mehdinuri/CPU4v1/README.md

# CPU4v1
Maestro Intersection Controlling System

# How to Use VSCode with STM32 Microcontrollers
[VSCode STM32](https://community.st.com/t5/stm32-mcus/how-to-use-vs-code-with-stm32-microcontrollers/ta-p/742589)

# Setup for STM32 development on Windows with WSL2
[WSL2 ST](https://github.com/robinhellmers/developer_setup_stm32_wsl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)
