mehdinuri/CPU4v1/PSM/Docs/sema_C2506-P250606_PSM_V1.pdf

GRID VOLTAGE & FREQUENCY MEASUREMENT | BP CONNECTOR

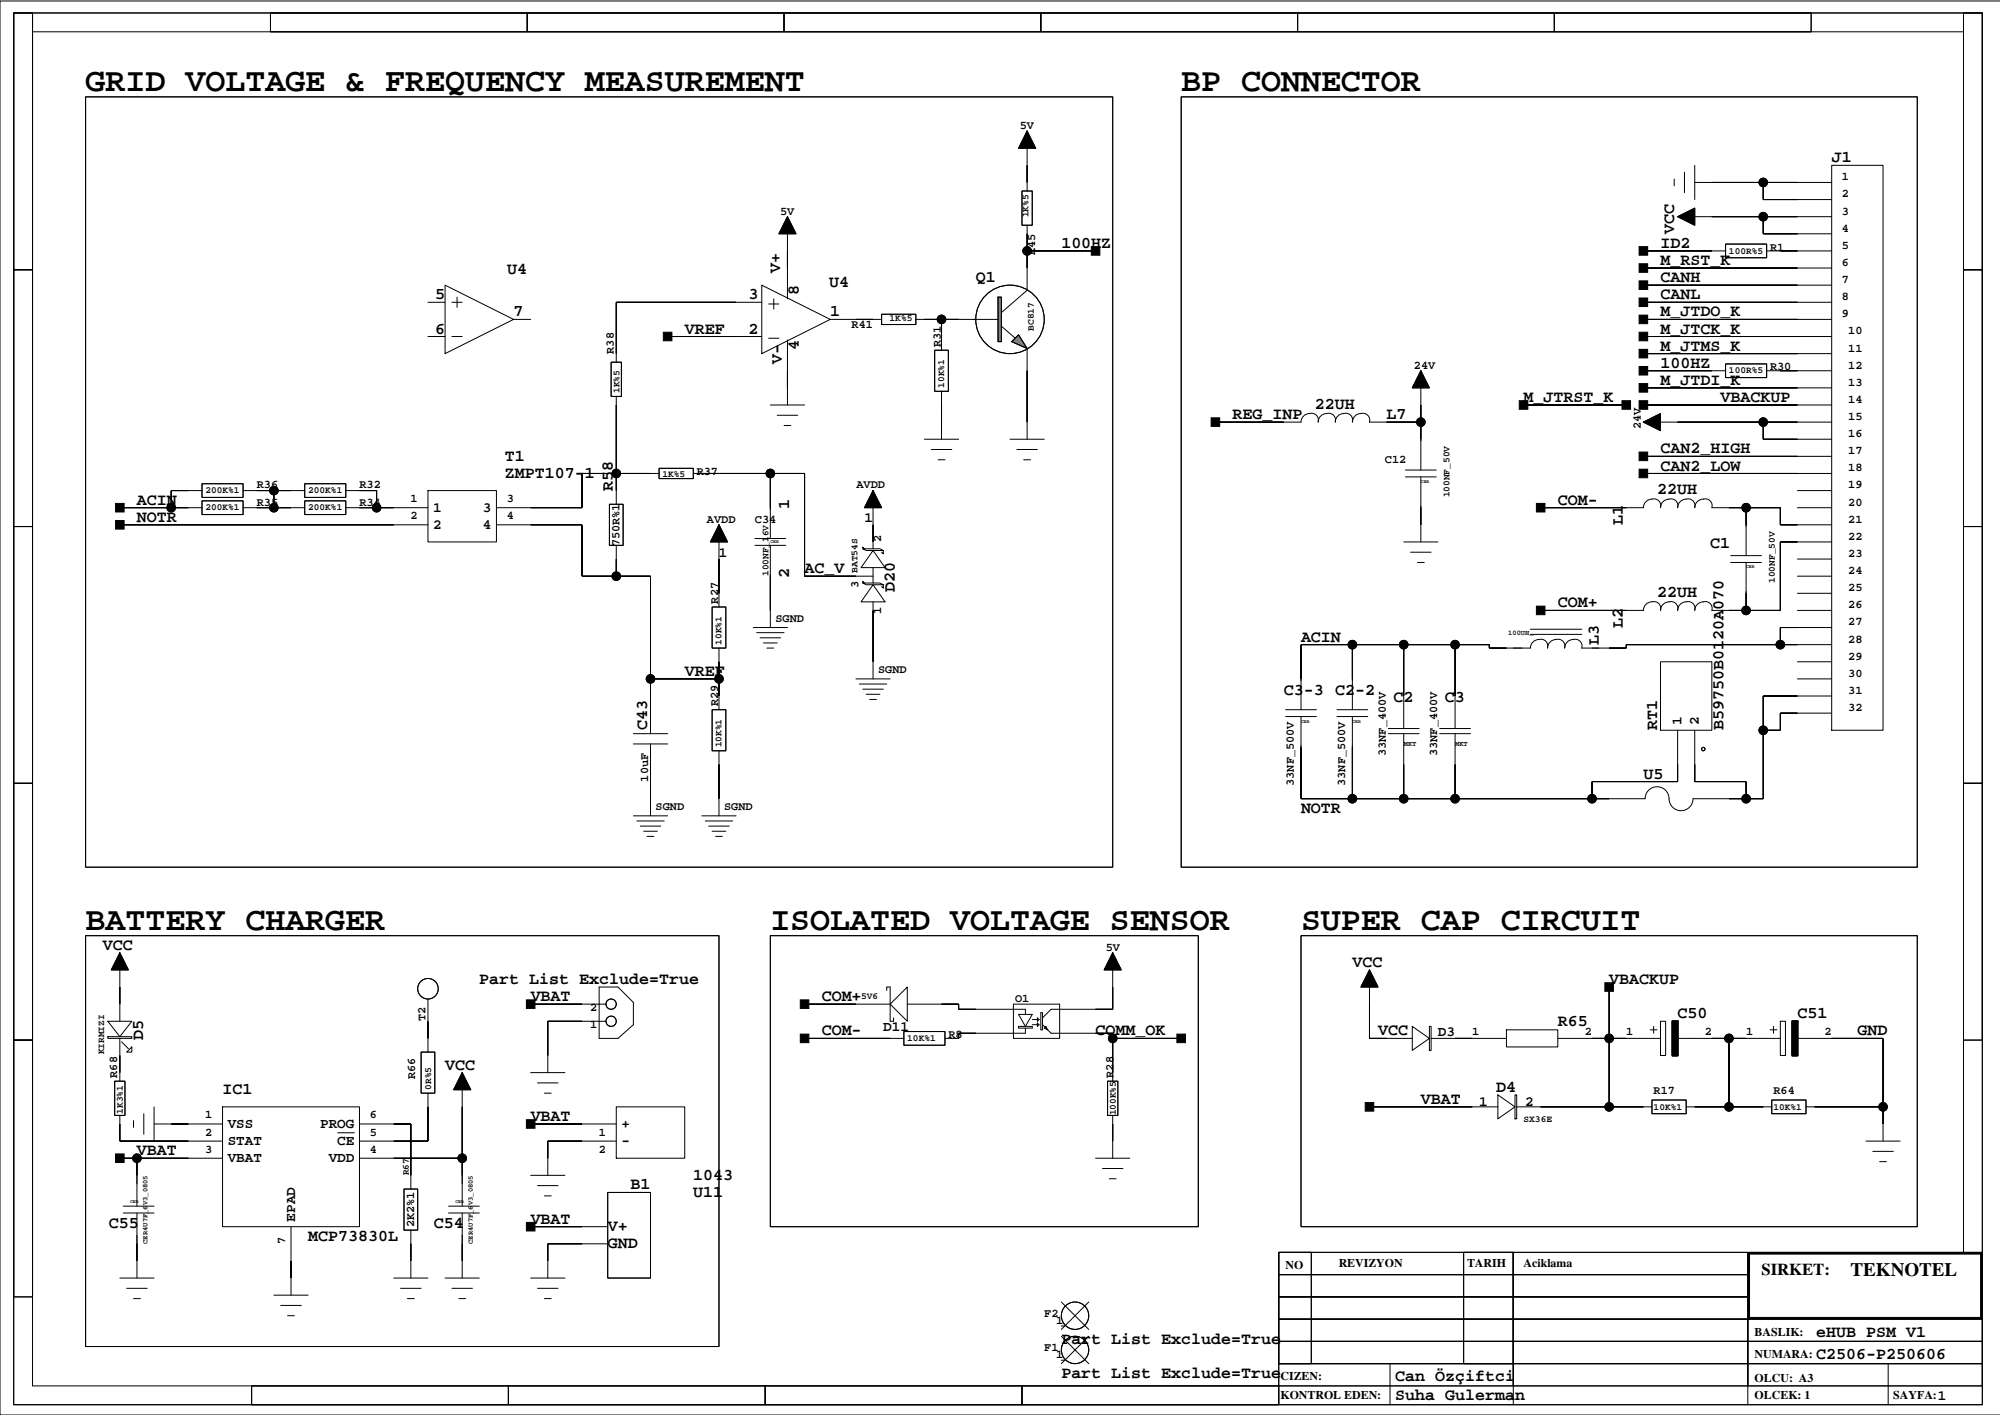
[picture p1: page 1]

Part List Exclude=True
VBAT

MICROCONTROLLER | INDICATOR LEDs

# CAN TRANSCEIVERS

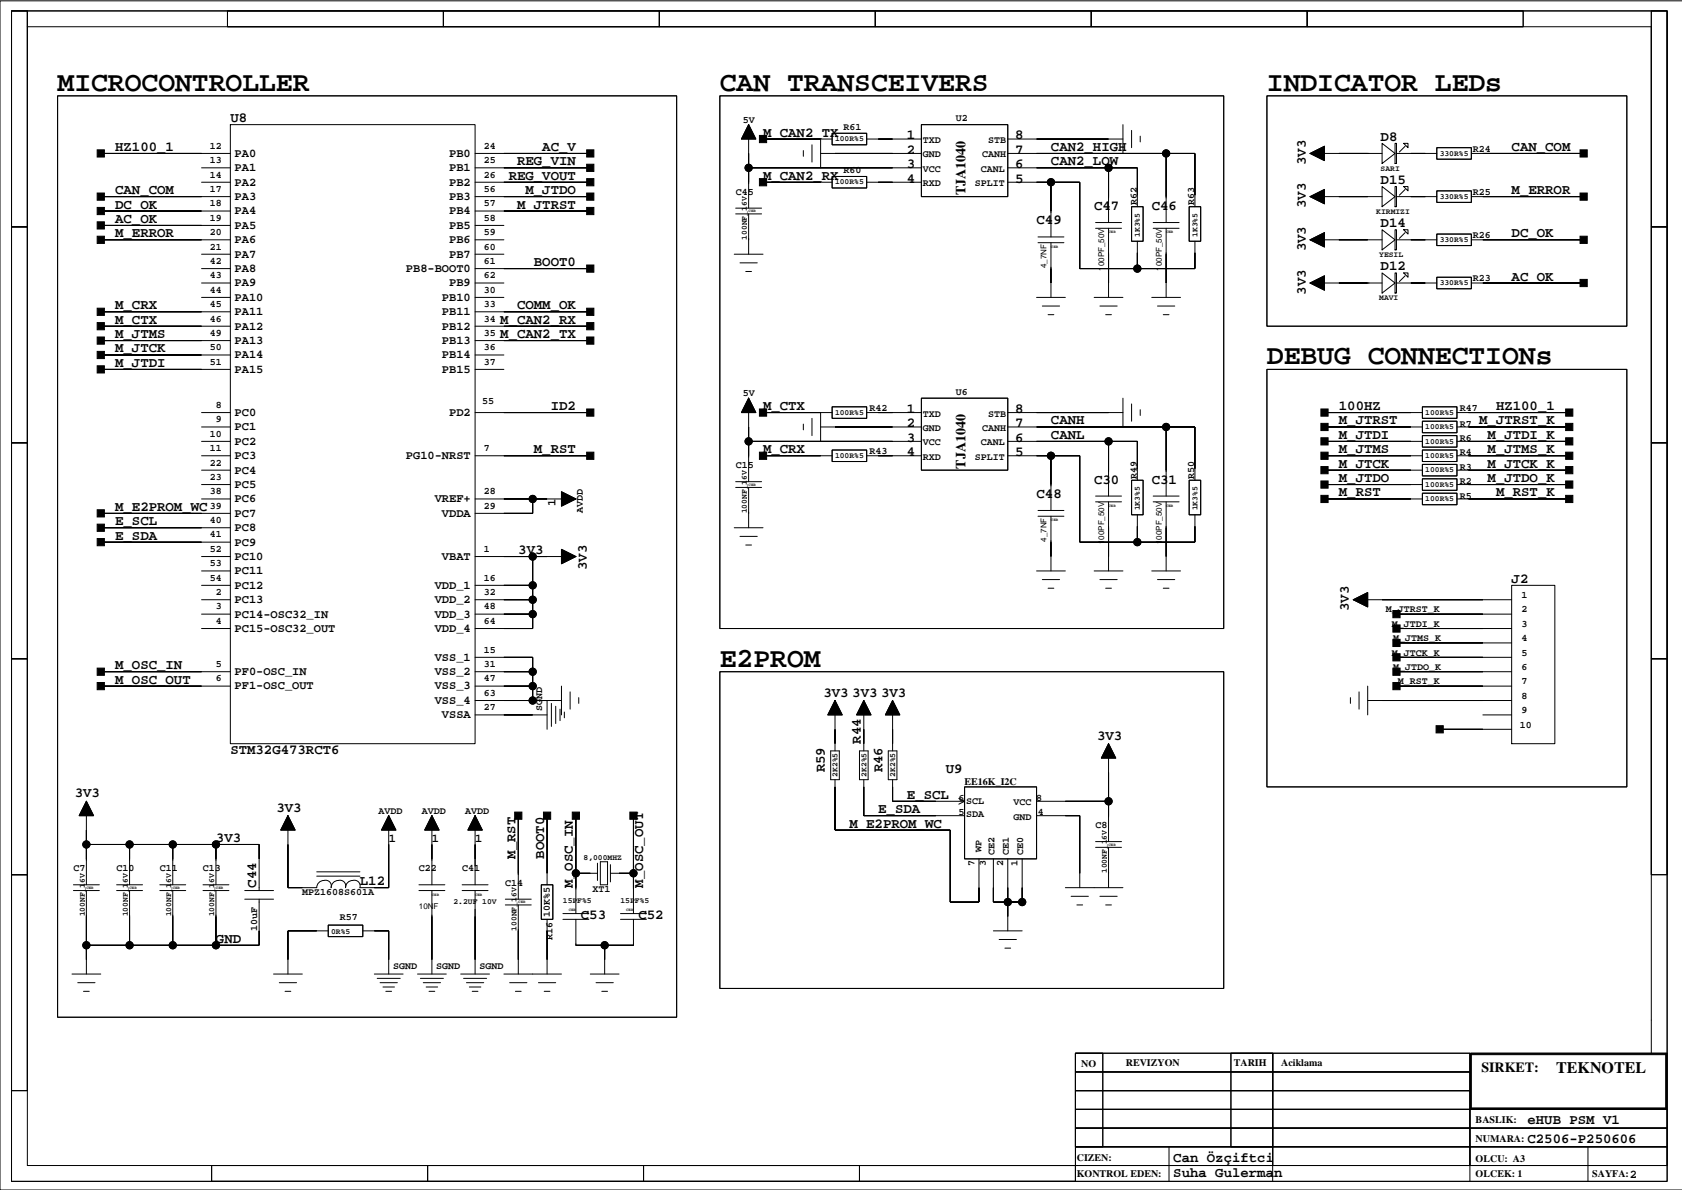
[picture p2: page 2]

# 24V IN 5V7 6A OUT SMPS

# LDOs

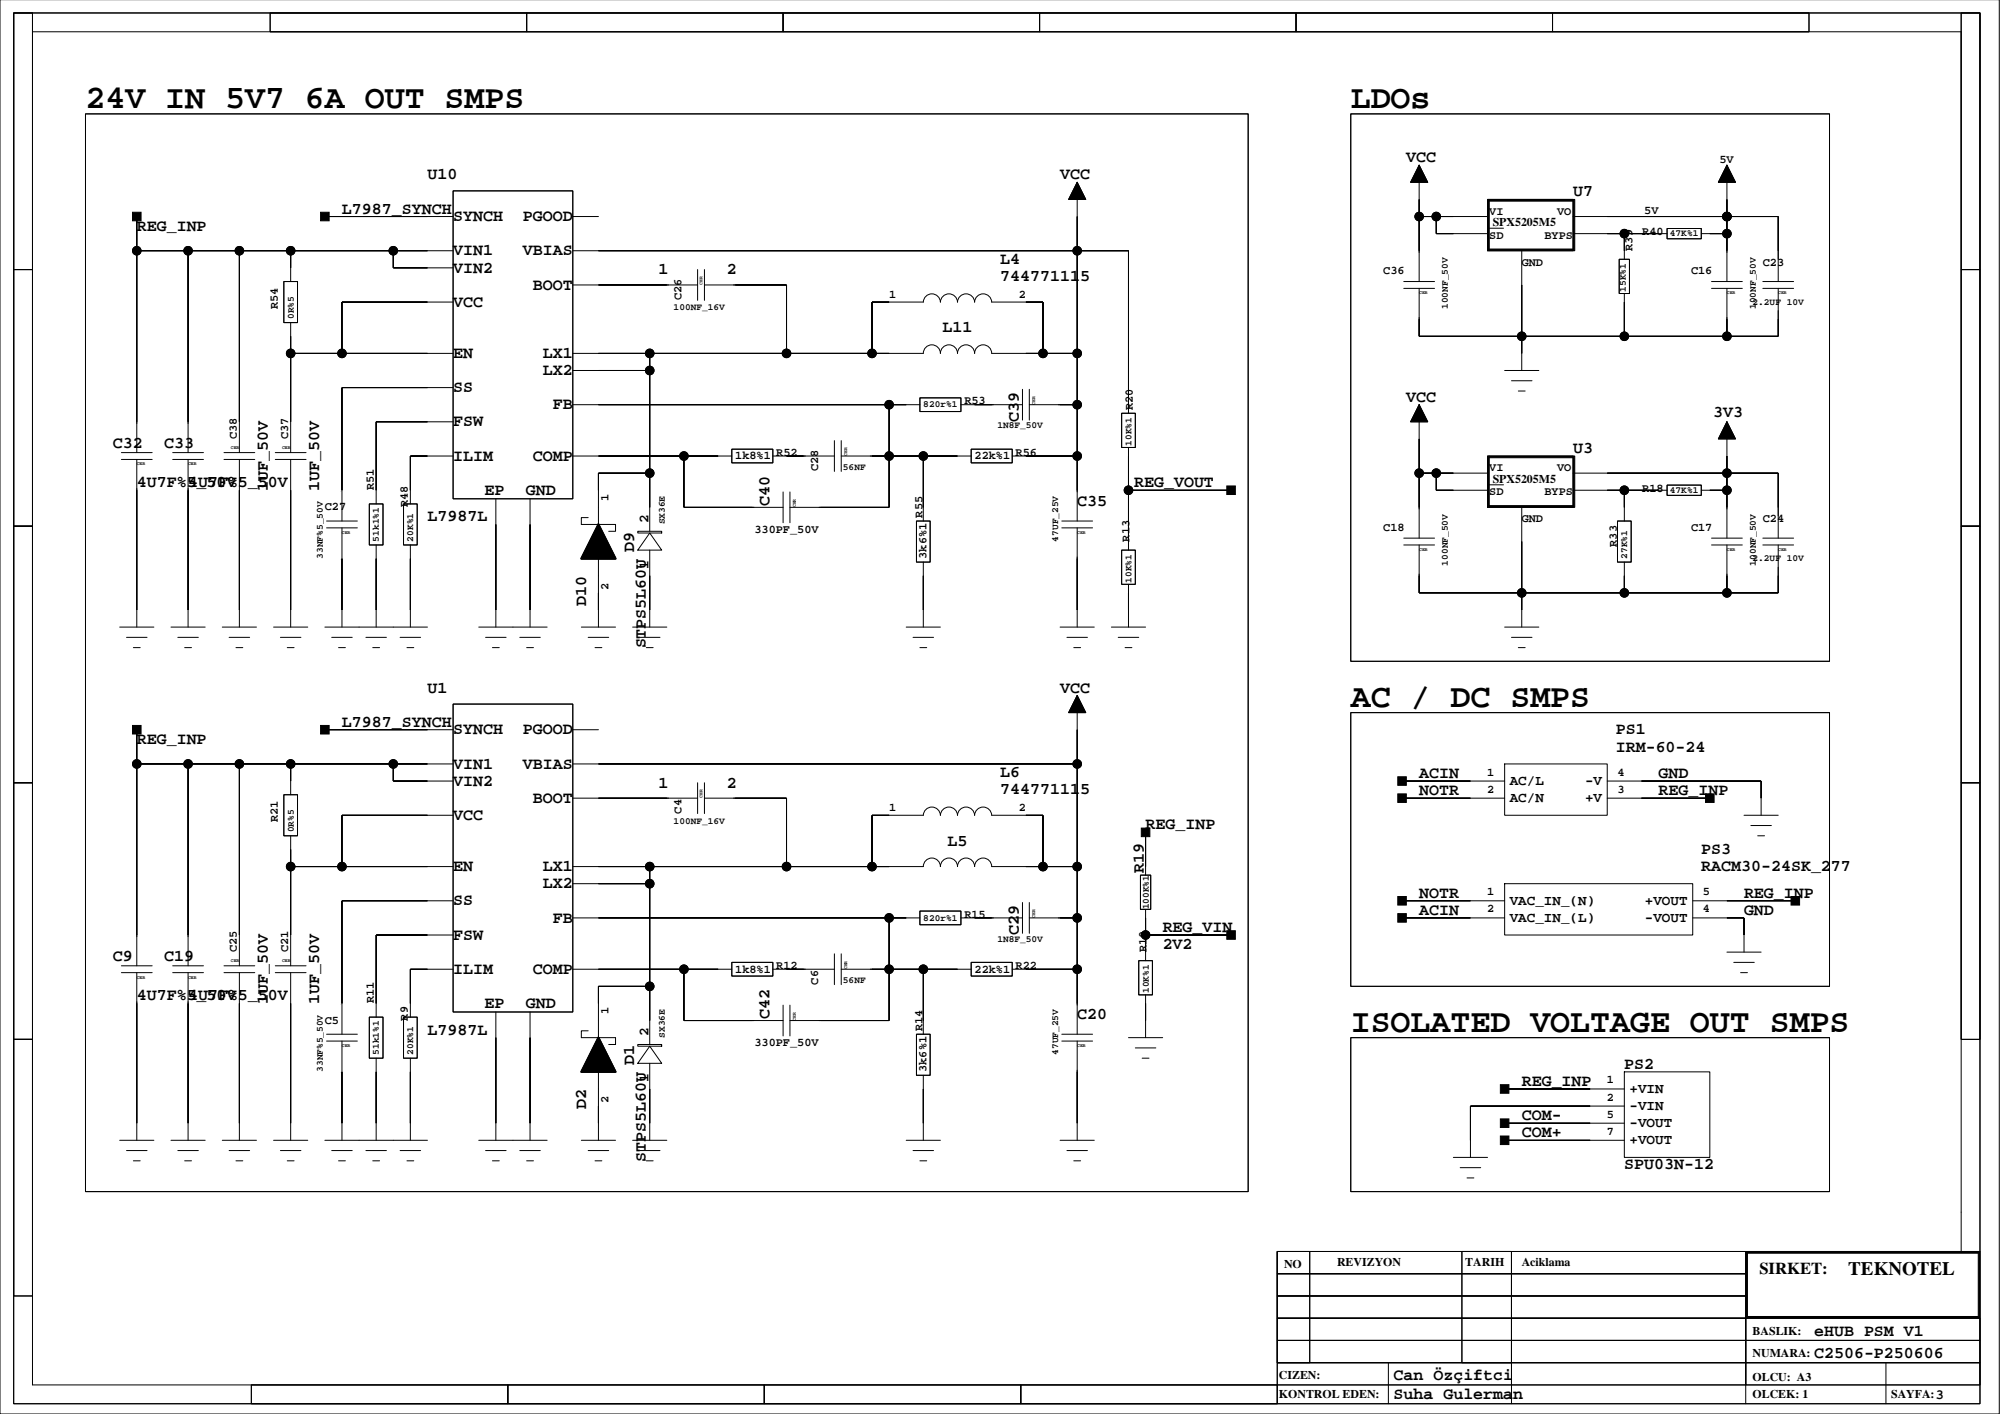
[picture p3: page 3]

ISOLATED VOLTAGE OUT SMPS
