mehdinuri/CPU4v1/SSM/Docs/sema_C2505-P250505_SSM_V1.pdf

## NRST

## Debug Connector

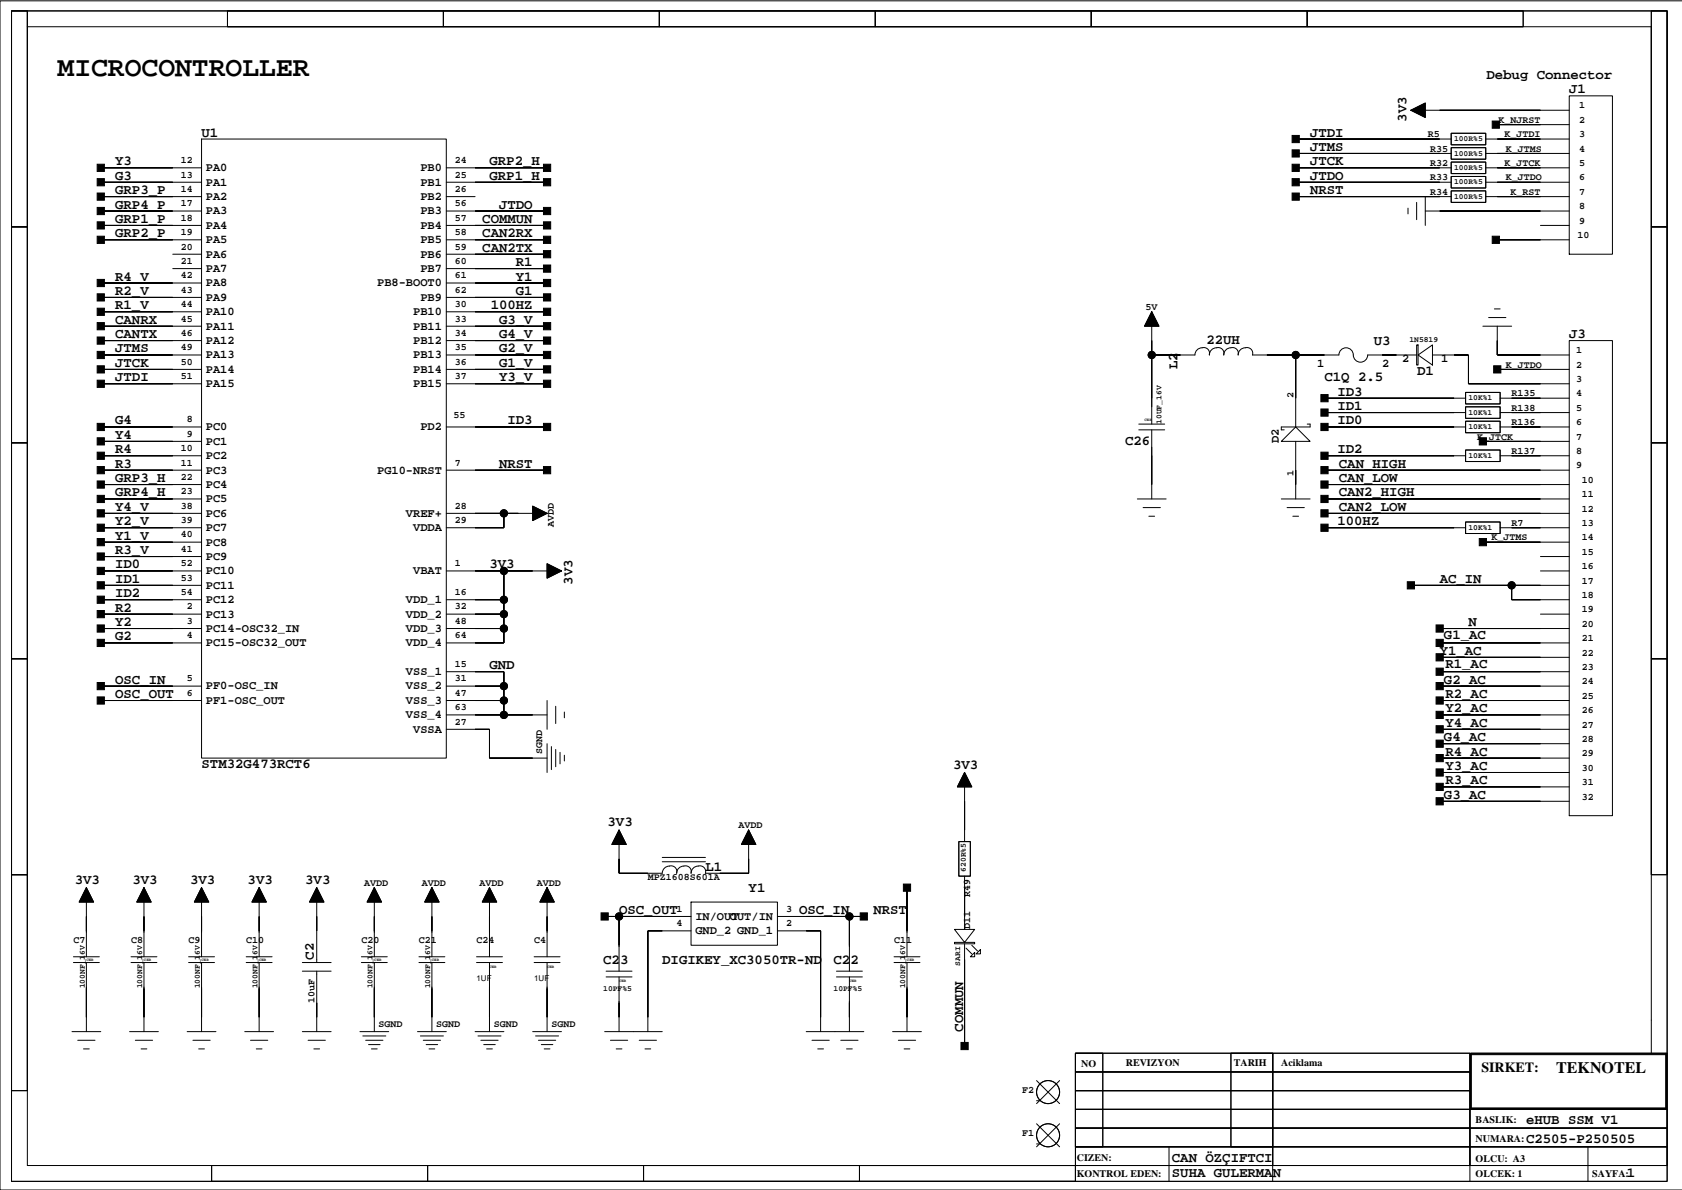
[picture p4: page 1]

C28
U33

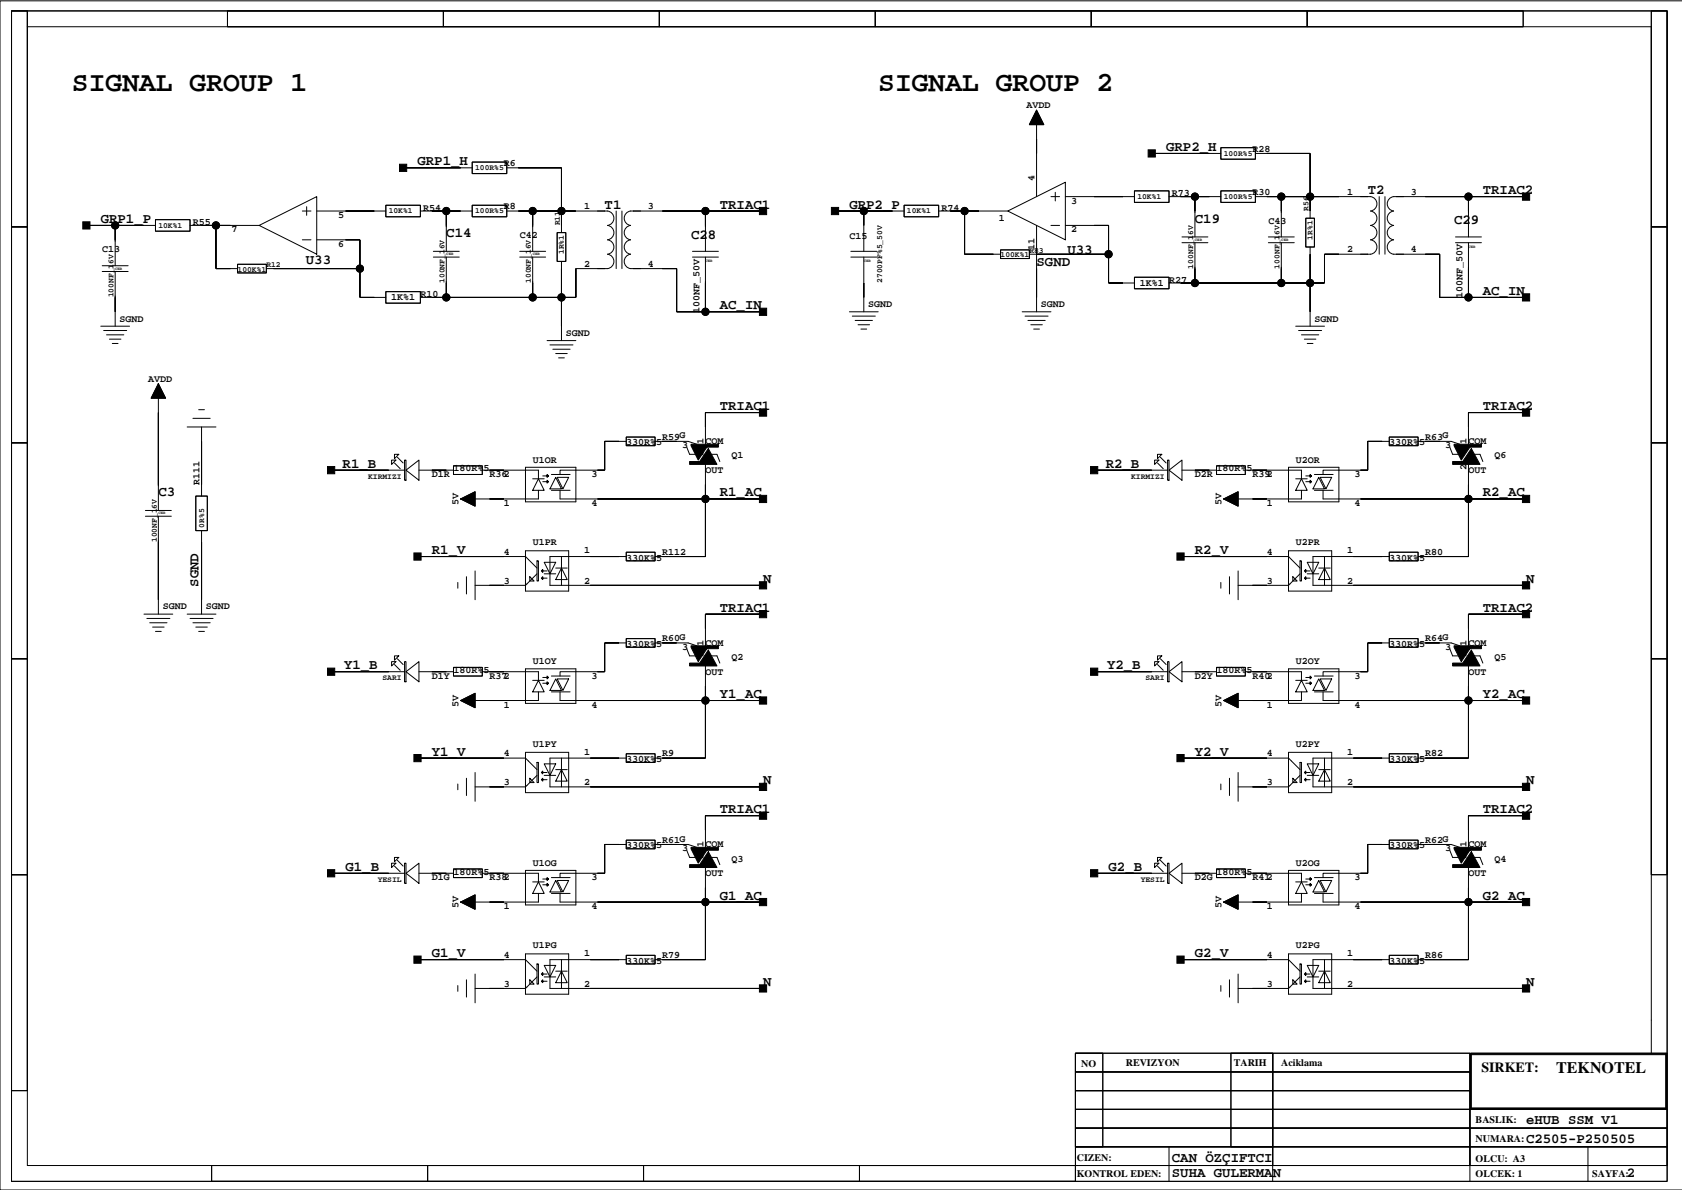
[picture p5: page 2]

U33

C31

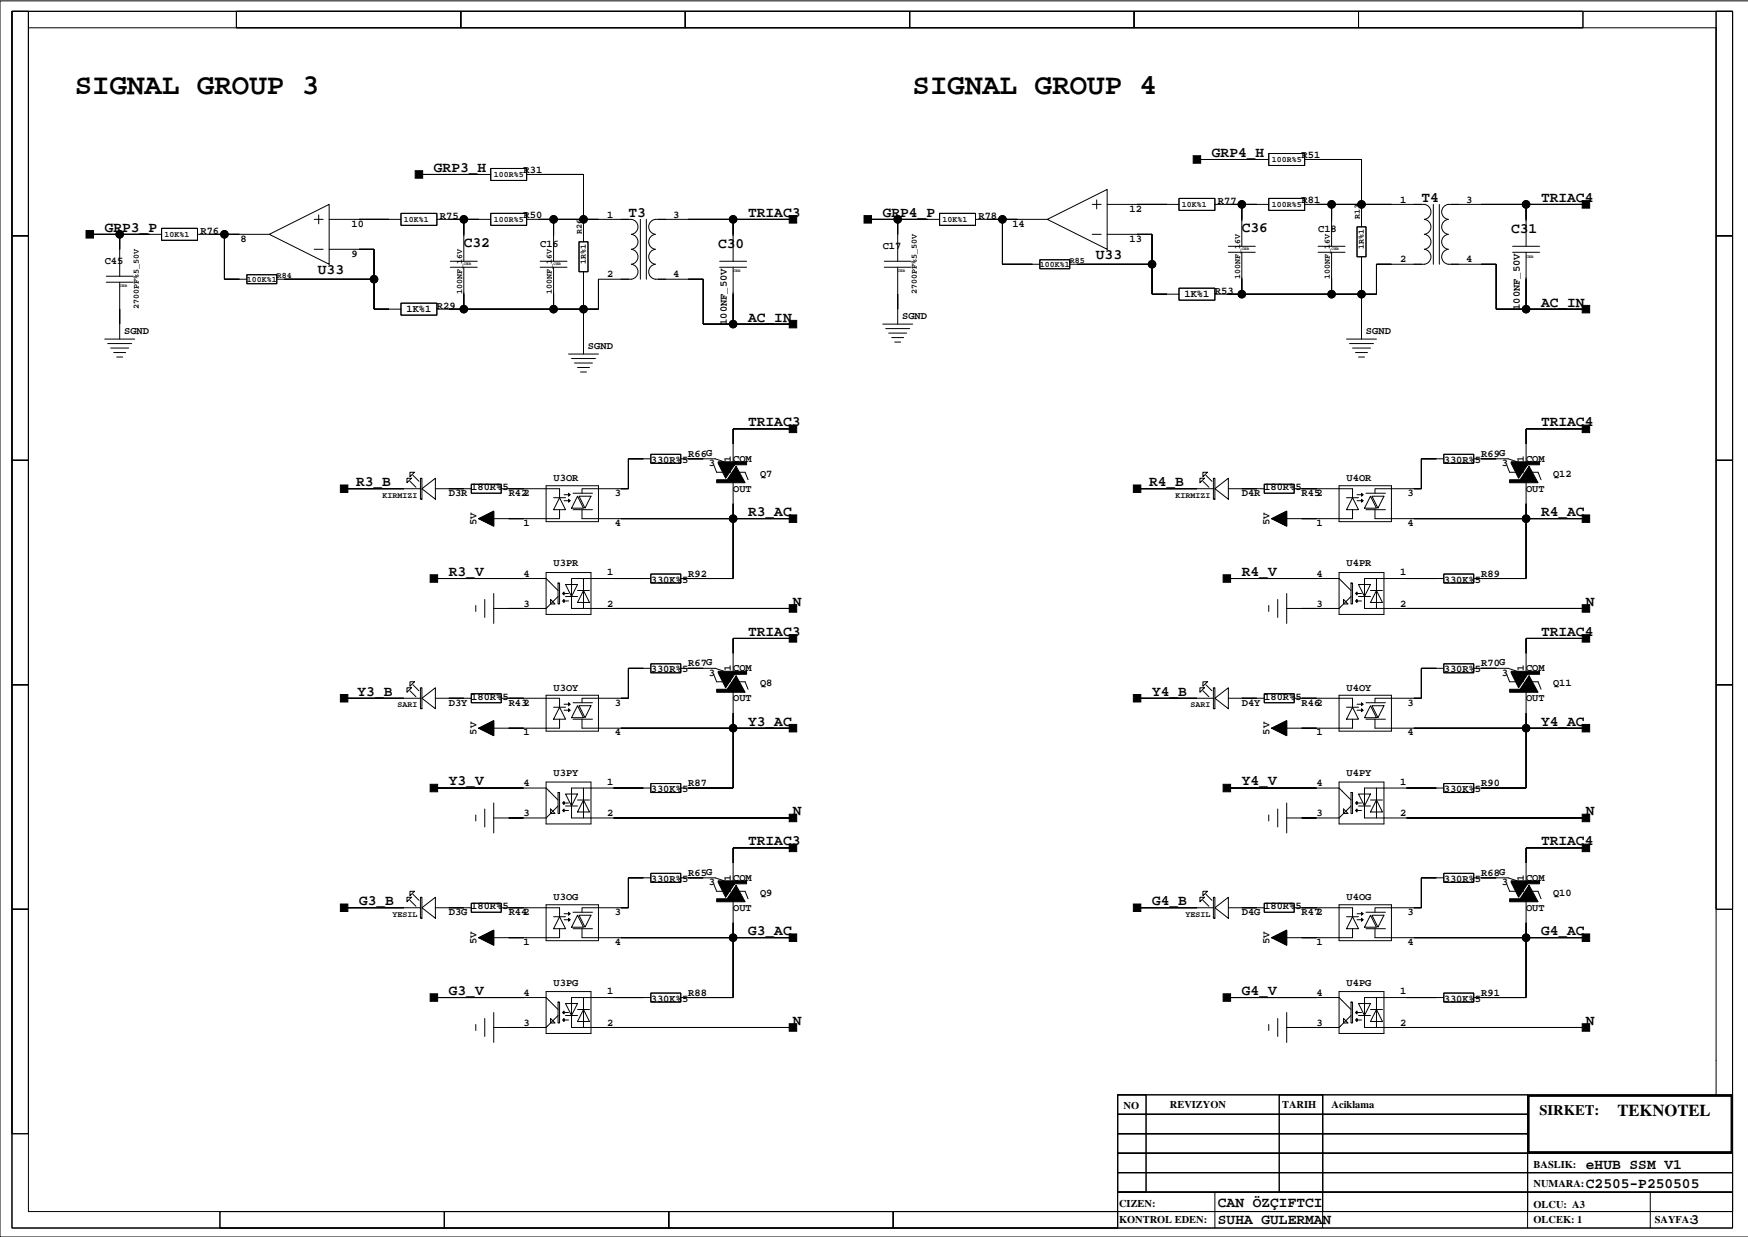
[picture p6: page 3]

## CANTX CAN_HIGH

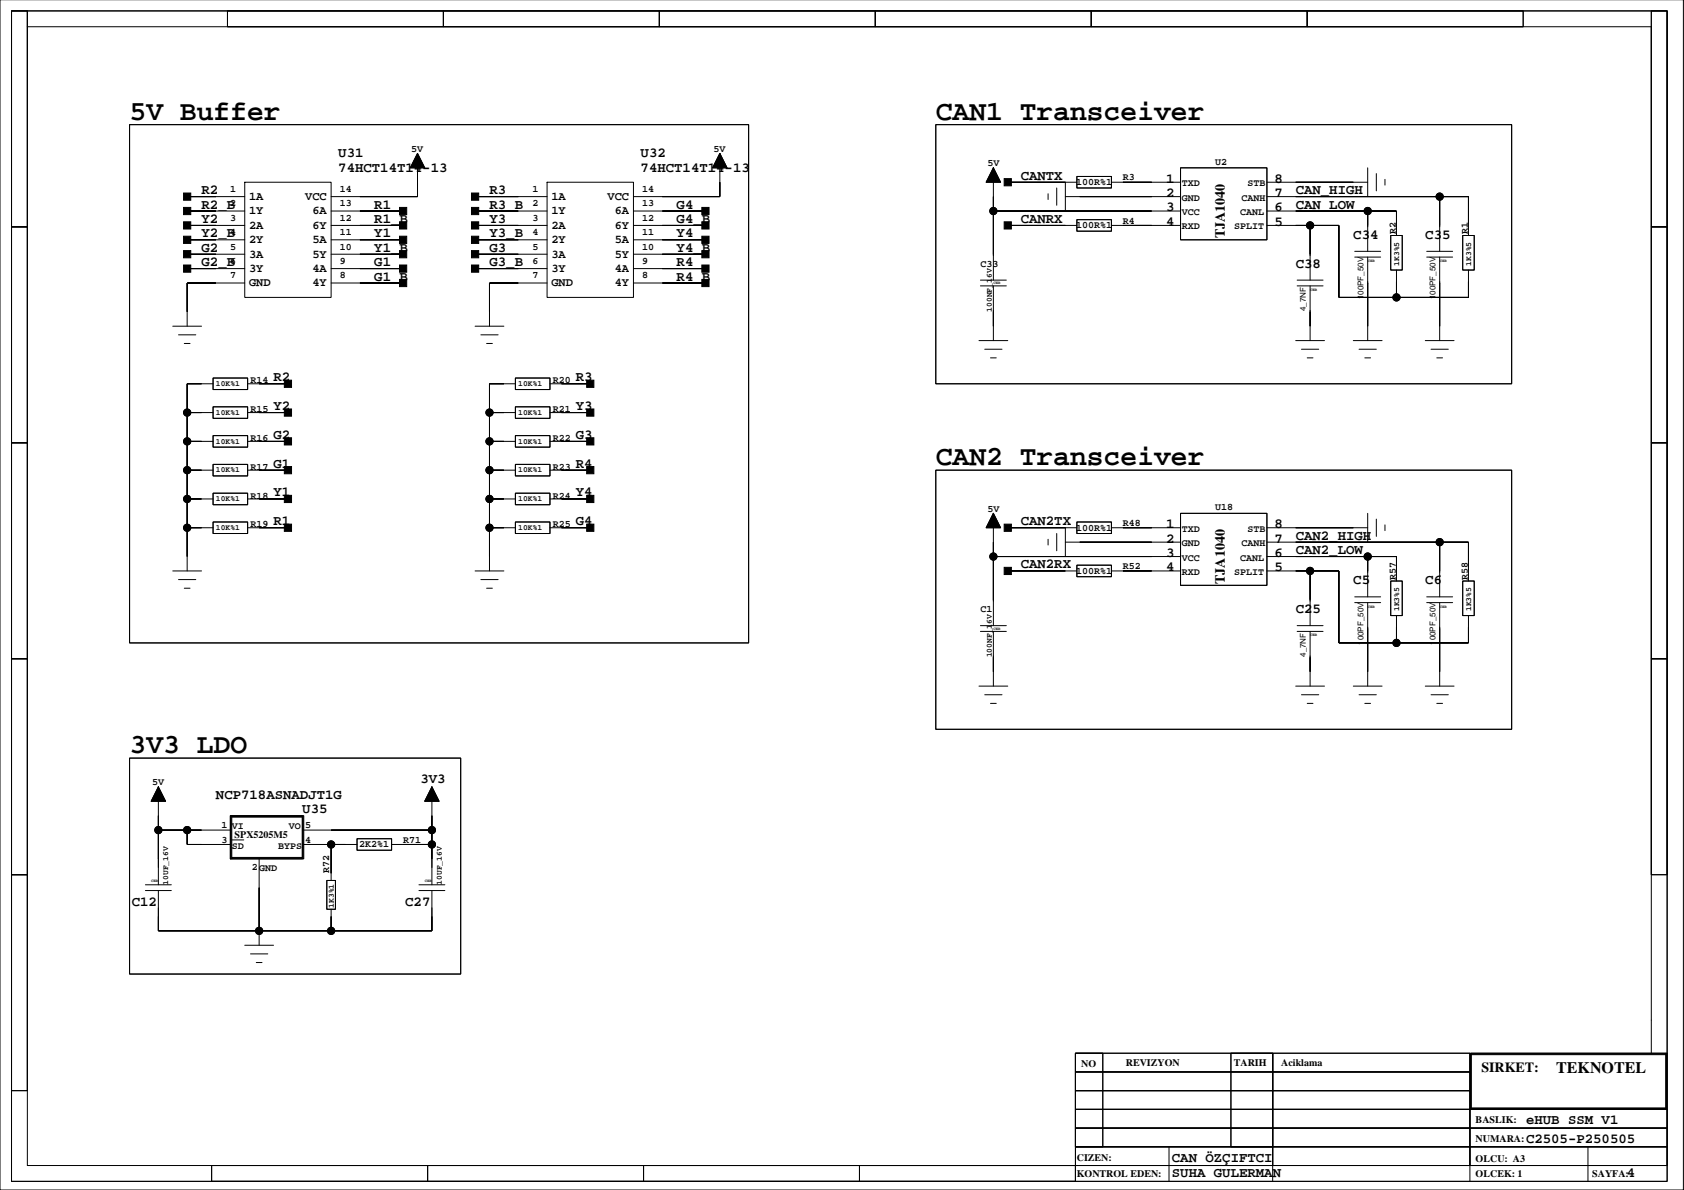
[picture p7: page 4]
