mehdinuri/CPU4v1/CPM/Docs/schema_c0502-p251207_cpu_v4.pdf

C60

C41

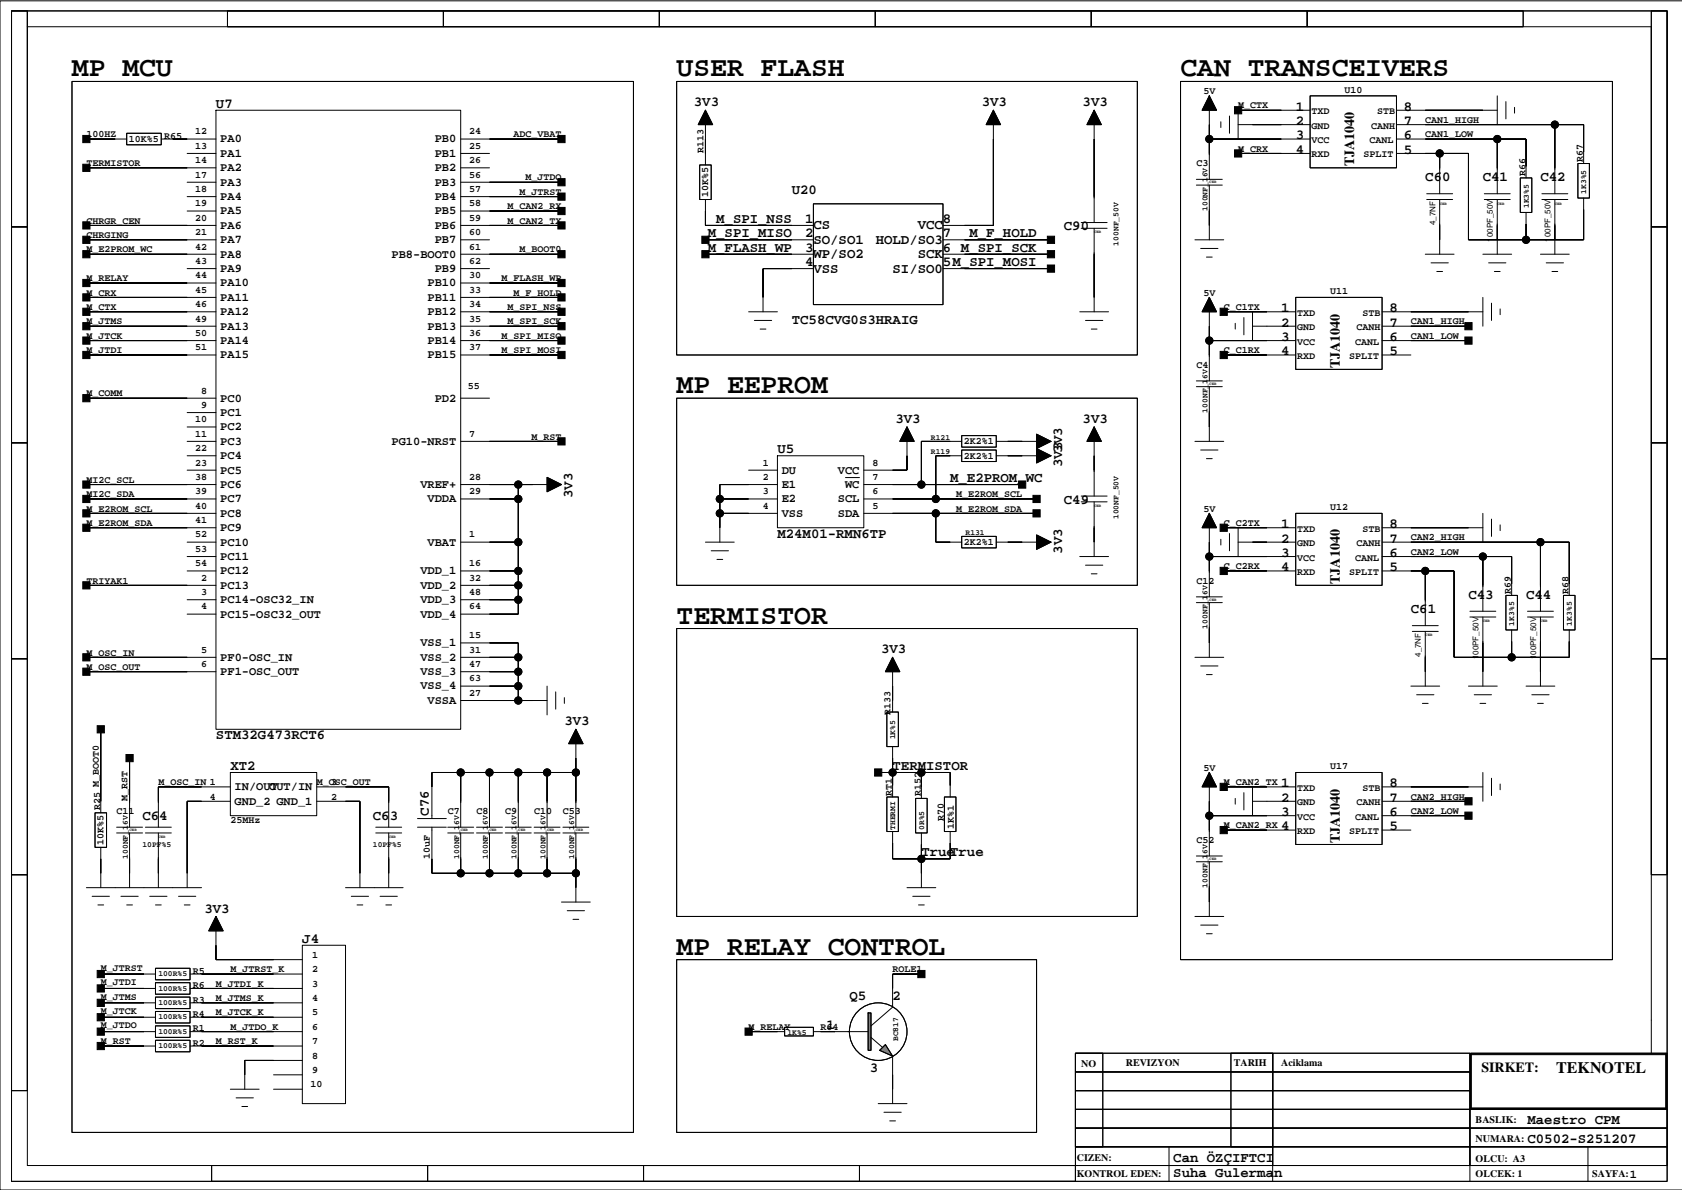
[picture p8: page 1]

3V3

J5

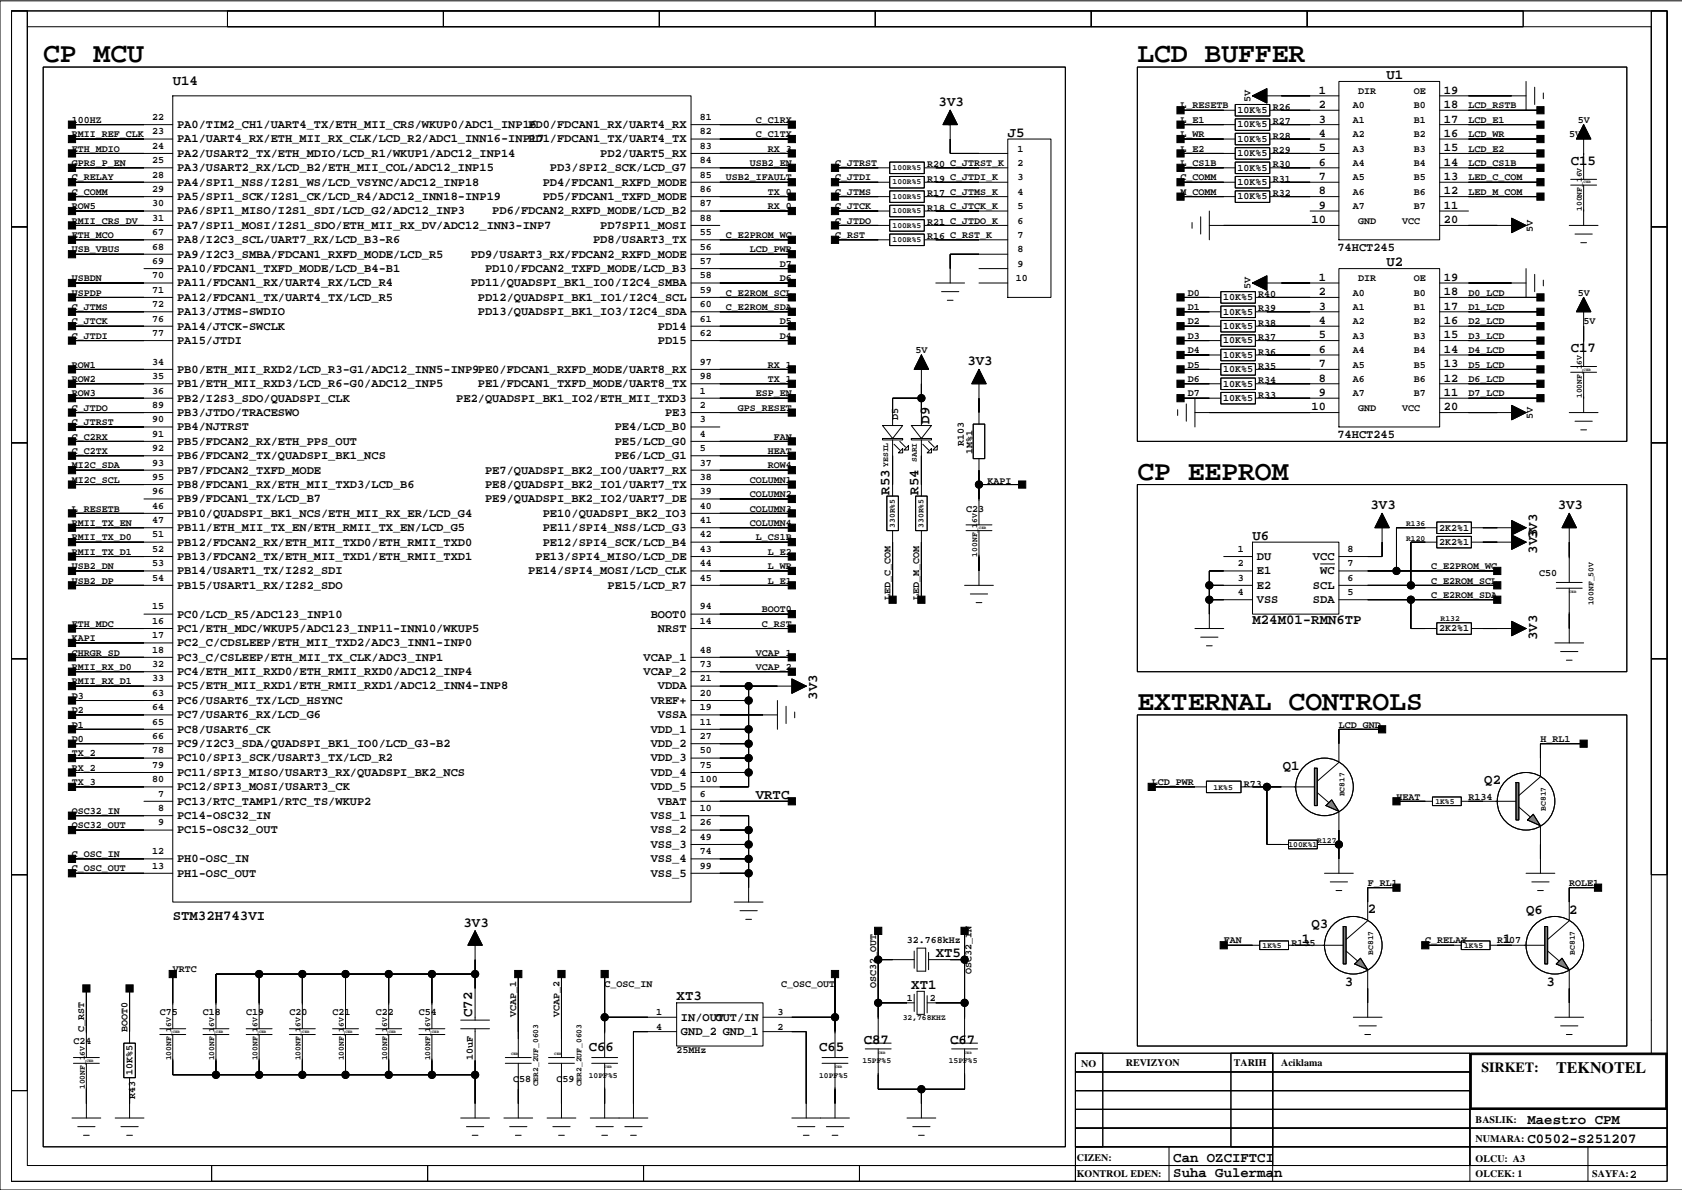
[picture p9: page 2]

U13

L2

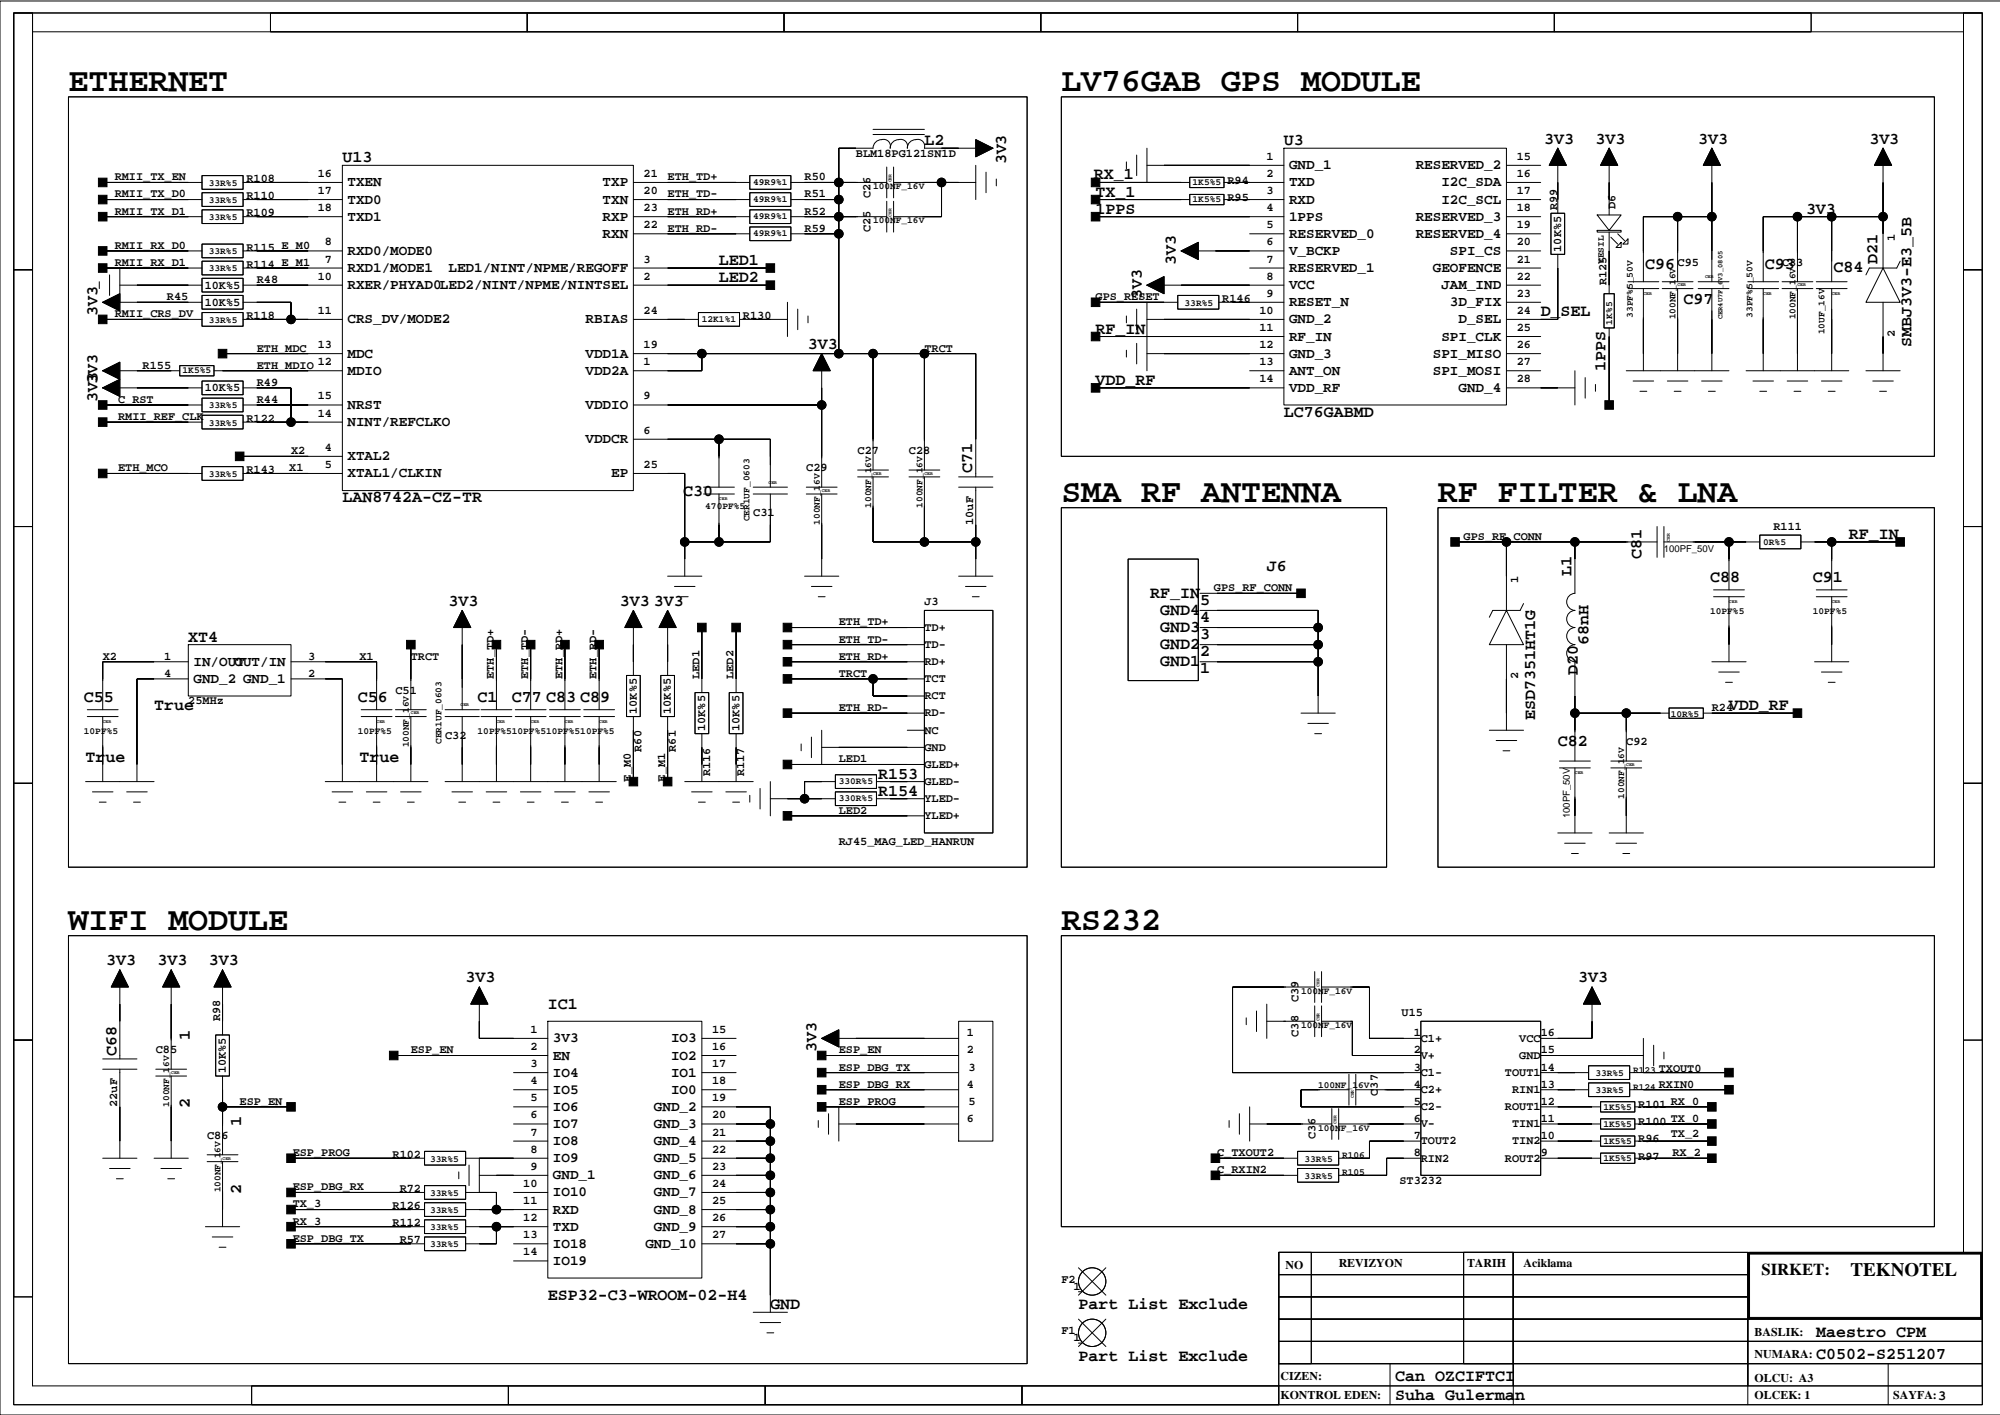
[picture p10: page 3]

## NTC

## BAT

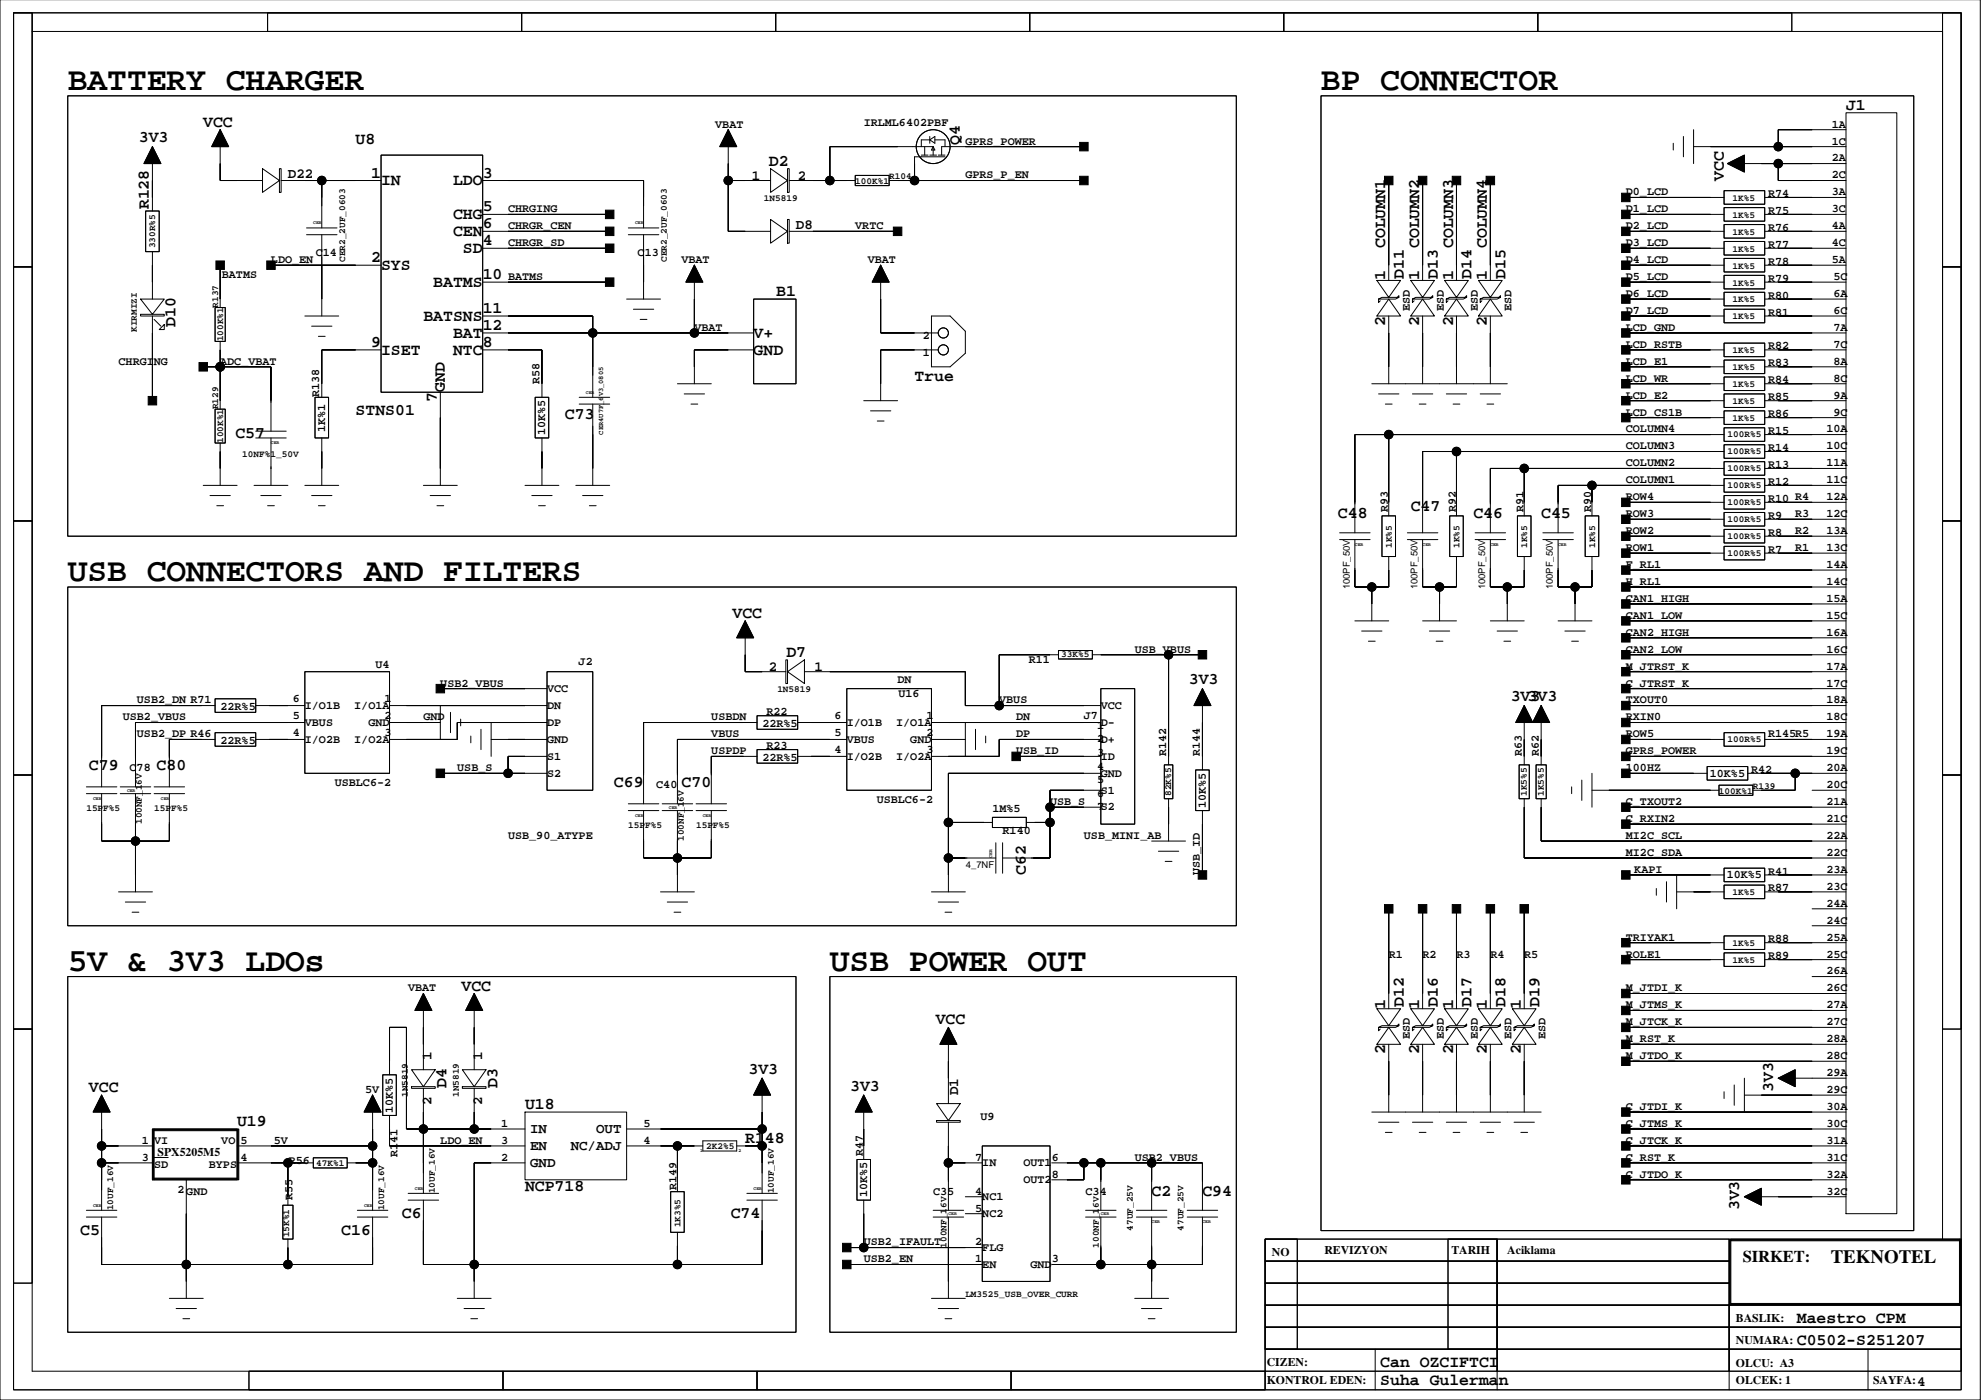
[picture p11: page 4]

USB CONNECTORS AND FILTERS

3 | CER | 2 | 2K2%5
