mehdinuri/CPU4v1/CPM/CP/Docs/PedestrianDetector_Schema.pdf

3V3

3V3

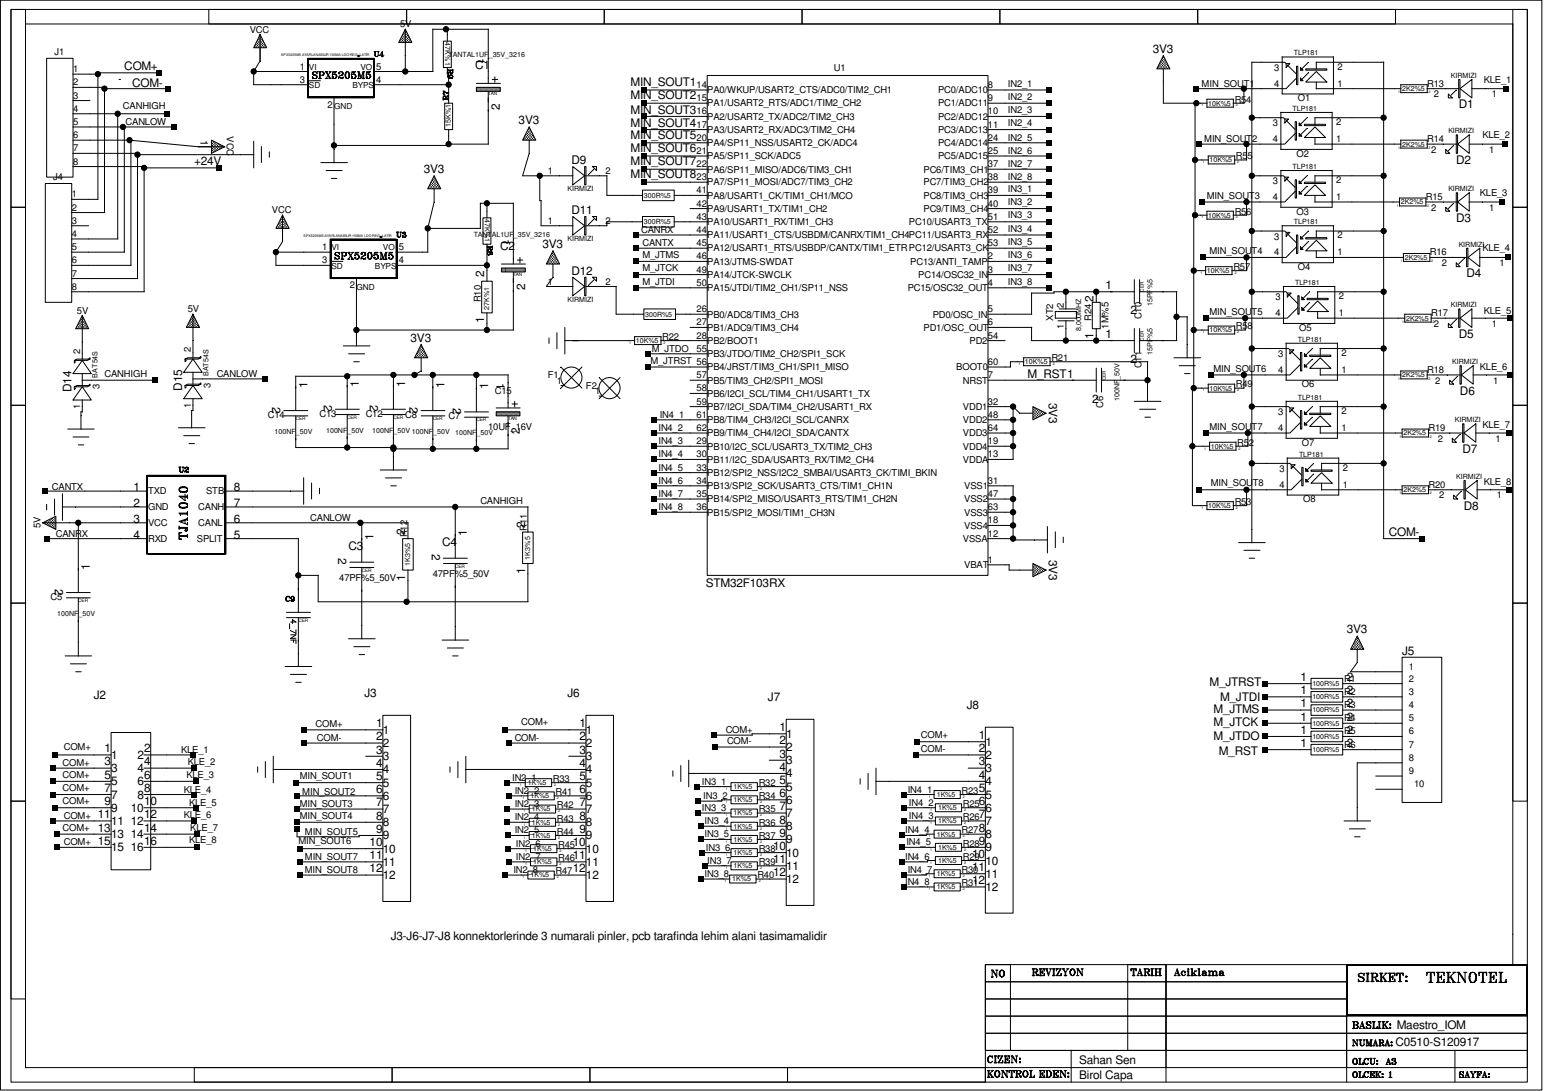
[picture p12: page 1]

J3-J6-J7-J8 konnektorlerinde 3 numarali pinler, pcb tarafinda lehim alani tasimamalidir
