mehdinuri/CPU4v1/CPM/MP/MP.ioc

Mcu.UserName=STM32G473RCTx
PA0.GPIO_Label=WKUP_100Hz
PA0.Signal=S_TIM2_CH1
PA10.GPIO_Label=RELAY
PA10.Signal=GPIO_Output
PA11.Signal=FDCAN1_RX
PA12.Signal=FDCAN1_TX
PA13.Signal=SYS_JTMS-SWDIO
PA14.Signal=SYS_JTCK-SWCLK
PA15.Signal=SYS_JTDI
PA2.GPIO_Label=TERMISTOR
PA2.Signal=ADC1_IN3
PA6.GPIO_Label=CHRGR_CEN
PA6.Signal=GPIO_Output
PA7.GPIO_Label=CHRGING
PA7.Signal=GPIO_Input
PA8.GPIO_Label=EEPROM_WP
PA8.Signal=GPIO_Output
PB0.GPIO_Label=VBAT
PB0.Signal=ADC1_IN15
PB10.GPIO_Label=FLASH_WP
PB10.Signal=GPIO_Output
PB11.GPIO_Label=FLASH_HOLD
PB11.Signal=GPIO_Output
PB12.Signal=SPI2_NSS
PB13.Signal=SPI2_SCK
PB14.Signal=SPI2_MISO
PB15.Signal=SPI2_MOSI
PB3.Signal=SYS_JTDO-SWO
PB4.Signal=SYS_JTRST
PB5.Signal=FDCAN2_RX
PB6.Signal=FDCAN2_TX
PC0.GPIO_Label=COM_LED
PC0.Signal=GPIO_Output
PC13.GPIO_Label=TRIAC
PC13.Signal=GPIO_Output
PC6.Signal=I2C4_SCL
PC7.Signal=I2C4_SDA
PC8.Signal=I2C3_SCL
PC9.Signal=I2C3_SDA
PF0-OSC_IN.Signal=RCC_OSC_IN
PF1-OSC_OUT.Signal=RCC_OSC_OUT
