mehdinuri/CPU4v1/CPM/CP/Core/Src/main.c

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
/* Includes ------------------------------------------------------------------*/
#include "main.h"
#include "FreeRTOS.h"
#include "cmsis_os2.h"
#include "bdma.h"
#include "crc.h"
#include "dma.h"
#include "fdcan.h"
#include "i2c.h"
#include "iwdg.h"
#include "mbedtls.h"
#include "rng.h"
#include "rtc.h"
#include "tim.h"
#include "usart.h"
#include "usb_device.h"
#include "gpio.h"
#include "DWT.h"
#include "SystemRuntime.h"

void SystemClock_Config(void);
void PeriphCommonClock_Config(void);
static void MPU_Config(void);
void MX_FREERTOS_Init(void);
/* USER CODE BEGIN 0 */
void D2SRAMClocksEnable(void)
{
  __HAL_RCC_D2SRAM1_CLK_ENABLE();
  __HAL_RCC_D2SRAM2_CLK_ENABLE();
  __HAL_RCC_D2SRAM3_CLK_ENABLE();
}

void PeripheralsInit(void)
{
  DWTInit();
  MX_GPIO_Init();
  MX_DMA_Init();
  MX_BDMA_Init();
  MX_RTC_Init();
  MX_TIM2_Init();
  MX_FDCAN1_Init();
  MX_FDCAN2_Init();
  MX_USART2_UART_Init();
  MX_UART4_Init();
  MX_UART5_Init();
  MX_UART8_Init();
  /* MX_I2C1_Init(); */
  MX_I2C4_Init();
  /* MX_CRC_Init(); */
  MX_RNG_Init();
}

/* USER CODE END 0 */

/**
  * @brief  The application entry point.
  * @retval int
  */
int main(void)
{

  /* USER CODE BEGIN 1 */
  SCB_InvalidateICache();
  SCB_InvalidateDCache();
  /* USER CODE END 1 */

  /* MPU Configuration--------------------------------------------------------*/
  MPU_Config();

  /* Enable the CPU Cache */

  /* Enable I-Cache---------------------------------------------------------*/
  SCB_EnableICache();

  /* Enable D-Cache---------------------------------------------------------*/
  SCB_EnableDCache();

  /* MCU Configuration--------------------------------------------------------*/

  /* Reset of all peripherals, Initializes the Flash interface and the Systick. */
  HAL_Init();

  /* USER CODE BEGIN Init */
  __HAL_RCC_CSI_ENABLE();
  __HAL_RCC_SYSCFG_CLK_ENABLE();
  HAL_EnableCompensationCell();
  /* USER CODE END Init */

  /* Configure the system clock */
  SystemClock_Config();

  /* Configure the peripherals common clocks */
  PeriphCommonClock_Config();

  /* USER CODE BEGIN SysInit */
  D2SRAMClocksEnable();

  SetDeviceResetSource();
  SetDeviceResetEvent();
  CheckWakeupState();
  ClearAllFlags();

  /* USER CODE END SysInit */

  /* Initialize all configured peripherals */
  
  /* Call PreOsInit function */
  MX_MBEDTLS_Init();
  /* USER CODE BEGIN 2 */
  PeripheralsInit();

  /* USER CODE END 2 */

  /* Init scheduler */
  osKernelInitialize();  /* Call init function for freertos objects (in cmsis_os2.c) */
  MX_FREERTOS_Init();

  /* Start scheduler */
  osKernelStart();

  /* We should never get here as control is now taken by the scheduler */

  /* Infinite loop */
  /* USER CODE BEGIN WHILE */
  while (1)
  {
    /* USER CODE END WHILE */

    /* USER CODE BEGIN 3 */
  }

  /* USER CODE END 3 */
}

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
/* USER CODE BEGIN 4 */
void SystemReset(void)
{
  #ifdef DEBUG
  __disable_irq();
  while (1)
  {
    ;
  }

  #else
  HAL_NVIC_SystemReset();
  #endif
}

/* USER CODE END 4 */

 /* MPU Configuration */

void MPU_Config(void)
{
  MPU_Region_InitTypeDef MPU_InitStruct = {0};

  /* Disables the MPU */
  HAL_MPU_Disable();

  /** Initializes and configures the Region and the memory to be protected
  */
  MPU_InitStruct.Enable = MPU_REGION_ENABLE;
  MPU_InitStruct.Number = MPU_REGION_NUMBER0;
  MPU_InitStruct.BaseAddress = 0x00;
  MPU_InitStruct.Size = MPU_REGION_SIZE_4GB;
  MPU_InitStruct.SubRegionDisable = 0x87;
  MPU_InitStruct.TypeExtField = MPU_TEX_LEVEL0;
  MPU_InitStruct.AccessPermission = MPU_REGION_NO_ACCESS;
  MPU_InitStruct.DisableExec = MPU_INSTRUCTION_ACCESS_DISABLE;
  MPU_InitStruct.IsShareable = MPU_ACCESS_SHAREABLE;
  MPU_InitStruct.IsCacheable = MPU_ACCESS_NOT_CACHEABLE;
  MPU_InitStruct.IsBufferable = MPU_ACCESS_NOT_BUFFERABLE;

  HAL_MPU_ConfigRegion(&MPU_InitStruct);

  /** Initializes and configures the Region and the memory to be protected
  */
  MPU_InitStruct.Number = MPU_REGION_NUMBER1;
  MPU_InitStruct.BaseAddress = 0x08000000;
  MPU_InitStruct.Size = MPU_REGION_SIZE_2MB;
  MPU_InitStruct.SubRegionDisable = 0x0;
  MPU_InitStruct.AccessPermission = MPU_REGION_FULL_ACCESS;
  MPU_InitStruct.DisableExec = MPU_INSTRUCTION_ACCESS_ENABLE;
  MPU_InitStruct.IsShareable = MPU_ACCESS_NOT_SHAREABLE;
  MPU_InitStruct.IsCacheable = MPU_ACCESS_CACHEABLE;

  HAL_MPU_ConfigRegion(&MPU_InitStruct);

  /** Initializes and configures the Region and the memory to be protected
  */
  MPU_InitStruct.Number = MPU_REGION_NUMBER2;
  MPU_InitStruct.BaseAddress = 0x00000000;
  MPU_InitStruct.Size = MPU_REGION_SIZE_64KB;
  MPU_InitStruct.TypeExtField = MPU_TEX_LEVEL1;
  MPU_InitStruct.IsCacheable = MPU_ACCESS_NOT_CACHEABLE;

  HAL_MPU_ConfigRegion(&MPU_InitStruct);

  /** Initializes and configures the Region and the memory to be protected
  */
  MPU_InitStruct.Number = MPU_REGION_NUMBER3;
  MPU_InitStruct.BaseAddress = 0x20000000;
  MPU_InitStruct.Size = MPU_REGION_SIZE_128KB;
  MPU_InitStruct.DisableExec = MPU_INSTRUCTION_ACCESS_DISABLE;

  HAL_MPU_ConfigRegion(&MPU_InitStruct);

  /** Initializes and configures the Region and the memory to be protected
  */
  MPU_InitStruct.Number = MPU_REGION_NUMBER4;
  MPU_InitStruct.BaseAddress = 0x24000000;
  MPU_InitStruct.Size = MPU_REGION_SIZE_512KB;
  MPU_InitStruct.SubRegionDisable = 0x07;
  MPU_InitStruct.IsCacheable = MPU_ACCESS_CACHEABLE;
  MPU_InitStruct.IsBufferable = MPU_ACCESS_BUFFERABLE;

  HAL_MPU_ConfigRegion(&MPU_InitStruct);

  /** Initializes and configures the Region and the memory to be protected
  */
  MPU_InitStruct.Number = MPU_REGION_NUMBER5;
  MPU_InitStruct.Size = MPU_REGION_SIZE_128KB;
  MPU_InitStruct.SubRegionDisable = 0x00;
  MPU_InitStruct.IsCacheable = MPU_ACCESS_NOT_CACHEABLE;
  MPU_InitStruct.IsBufferable = MPU_ACCESS_NOT_BUFFERABLE;

  HAL_MPU_ConfigRegion(&MPU_InitStruct);

  /** Initializes and configures the Region and the memory to be protected
  */
  MPU_InitStruct.Number = MPU_REGION_NUMBER6;
  MPU_InitStruct.BaseAddress = 0x24020000;
  MPU_InitStruct.Size = MPU_REGION_SIZE_64KB;
  MPU_InitStruct.SubRegionDisable = 0x0;

  HAL_MPU_ConfigRegion(&MPU_InitStruct);

  /** Initializes and configures the Region and the memory to be protected
  */
  MPU_InitStruct.Number = MPU_REGION_NUMBER7;
  MPU_InitStruct.BaseAddress = 0x30000000;
  MPU_InitStruct.Size = MPU_REGION_SIZE_256KB;
  MPU_InitStruct.SubRegionDisable = 0x03;
  MPU_InitStruct.IsCacheable = MPU_ACCESS_CACHEABLE;
  MPU_InitStruct.IsBufferable = MPU_ACCESS_BUFFERABLE;

  HAL_MPU_ConfigRegion(&MPU_InitStruct);

  /** Initializes and configures the Region and the memory to be protected
  */
  MPU_InitStruct.Number = MPU_REGION_NUMBER8;
  MPU_InitStruct.Size = MPU_REGION_SIZE_64KB;
  MPU_InitStruct.SubRegionDisable = 0x0;
  MPU_InitStruct.IsShareable = MPU_ACCESS_SHAREABLE;
  MPU_InitStruct.IsCacheable = MPU_ACCESS_NOT_CACHEABLE;
  MPU_InitStruct.IsBufferable = MPU_ACCESS_NOT_BUFFERABLE;

  HAL_MPU_ConfigRegion(&MPU_InitStruct);

  /** Initializes and configures the Region and the memory to be protected
  */
  MPU_InitStruct.Number = MPU_REGION_NUMBER9;
  MPU_InitStruct.Size = MPU_REGION_SIZE_256B;
  MPU_InitStruct.SubRegionDisable = 0x00;
  MPU_InitStruct.TypeExtField = MPU_TEX_LEVEL0;
  MPU_InitStruct.IsBufferable = MPU_ACCESS_BUFFERABLE;

  HAL_MPU_ConfigRegion(&MPU_InitStruct);

  /** Initializes and configures the Region and the memory to be protected
  */
  MPU_InitStruct.Number = MPU_REGION_NUMBER10;
  MPU_InitStruct.BaseAddress = 0x30040000;
  MPU_InitStruct.Size = MPU_REGION_SIZE_32KB;
  MPU_InitStruct.SubRegionDisable = 0x0;
  MPU_InitStruct.TypeExtField = MPU_TEX_LEVEL1;
  MPU_InitStruct.IsShareable = MPU_ACCESS_NOT_SHAREABLE;
  MPU_InitStruct.IsCacheable = MPU_ACCESS_CACHEABLE;

  HAL_MPU_ConfigRegion(&MPU_InitStruct);

  /** Initializes and configures the Region and the memory to be protected
  */
  MPU_InitStruct.Number = MPU_REGION_NUMBER11;
  MPU_InitStruct.BaseAddress = 0x38000000;
  MPU_InitStruct.Size = MPU_REGION_SIZE_64KB;
  MPU_InitStruct.IsShareable = MPU_ACCESS_SHAREABLE;
  MPU_InitStruct.IsCacheable = MPU_ACCESS_NOT_CACHEABLE;
  MPU_InitStruct.IsBufferable = MPU_ACCESS_NOT_BUFFERABLE;

  HAL_MPU_ConfigRegion(&MPU_InitStruct);

  /** Initializes and configures the Region and the memory to be protected
  */
  MPU_InitStruct.Number = MPU_REGION_NUMBER12;
  MPU_InitStruct.BaseAddress = 0x38800000;
  MPU_InitStruct.Size = MPU_REGION_SIZE_4KB;
  MPU_InitStruct.IsShareable = MPU_ACCESS_NOT_SHAREABLE;

  HAL_MPU_ConfigRegion(&MPU_InitStruct);
  /* Enables the MPU */
  HAL_MPU_Enable(MPU_PRIVILEGED_DEFAULT);

}

/**
  * @brief  Period elapsed callback in non blocking mode
  * @note   This function is called  when TIM1 interrupt took place, inside
  * HAL_TIM_IRQHandler(). It makes a direct call to HAL_IncTick() to increment
  * a global variable "uwTick" used as application time base.
  * @param  htim : TIM handle
  * @retval None
  */
void HAL_TIM_PeriodElapsedCallback(TIM_HandleTypeDef *htim)
{
  if (htim->Instance == TIM1)
  {
    HAL_IncTick();
  }
}

/**
  * @brief  This function is executed in case of error occurrence.
  * @retval None
  */
void Error_Handler(void)
{
  /* USER CODE BEGIN Error_Handler_Debug */
  /* User can add his own implementation to report the HAL error return state */
  __disable_irq();
  while (1)
  {
  }

  /* USER CODE END Error_Handler_Debug */
}
#ifdef USE_FULL_ASSERT
/**
  * @brief  Reports the name of the source file and the source line number
  *         where the assert_param error has occurred.
  * @param  file: pointer to the source file name
  * @param  line: assert_param error line source number
  * @retval None
  */
void assert_failed(uint8_t *file, uint32_t line)
{
  /* USER CODE BEGIN 6 */

  /* User can add his own implementation to report the file name and line number,
   *  ex: printf("Wrong parameters value: file %s on line %d\r\n", file, line) */
  /* USER CODE END 6 */
}
#endif /* USE_FULL_ASSERT */
