mehdinuri/CPU4v1/CPM/CP/App/Adapters/STM32/ControllerModeControlAdapter.h

/* App/Adapters/STM32/ControllerModeControlAdapter.h */
#ifndef CONTROLLER_MODE_CONTROL_ADAPTER_H
#define CONTROLLER_MODE_CONTROL_ADAPTER_H

#include "Domain/Intersection/IntersectionEngine.h"
#include "Ports/IControllerModeControlPort.h"

typedef struct
{
  IntersectionEngine_t *engine;
} ControllerModeControlAdapterCtx_t;

void ControllerModeControlAdapterInit(ControllerModeControlAdapterCtx_t *ctx);
IControllerModeControlPort_t ControllerModeControlAdapterCreatePort(
  ControllerModeControlAdapterCtx_t *ctx);

#endif /* CONTROLLER_MODE_CONTROL_ADAPTER_H */
