mehdinuri/CPU4v1/SSM/Core/Inc/main.h

#define R2_Pin GPIO_PIN_13
#define R2_GPIO_Port GPIOC
#define Y2_Pin GPIO_PIN_14
#define Y2_GPIO_Port GPIOC
#define G2_Pin GPIO_PIN_15
#define G2_GPIO_Port GPIOC
#define G4_Pin GPIO_PIN_0
#define G4_GPIO_Port GPIOC
#define Y4_Pin GPIO_PIN_1
#define Y4_GPIO_Port GPIOC
#define R4_Pin GPIO_PIN_2
#define R4_GPIO_Port GPIOC
#define R3_Pin GPIO_PIN_3
#define R3_GPIO_Port GPIOC
#define Y3_Pin GPIO_PIN_0
#define Y3_GPIO_Port GPIOA
#define G3_Pin GPIO_PIN_1
#define G3_GPIO_Port GPIOA
#define GRP3_P_Pin GPIO_PIN_2
#define GRP3_P_GPIO_Port GPIOA
#define GRP4_P_Pin GPIO_PIN_3
#define GRP4_P_GPIO_Port GPIOA
#define GRP1_P_Pin GPIO_PIN_4
#define GRP1_P_GPIO_Port GPIOA
#define GRP2_P_Pin GPIO_PIN_5
#define GRP2_P_GPIO_Port GPIOA
#define GRP3_H_Pin GPIO_PIN_4
#define GRP3_H_GPIO_Port GPIOC
#define GRP4_H_Pin GPIO_PIN_5
#define GRP4_H_GPIO_Port GPIOC
#define GRP2_H_Pin GPIO_PIN_0
#define GRP2_H_GPIO_Port GPIOB
#define GRP1_H_Pin GPIO_PIN_1
#define GRP1_H_GPIO_Port GPIOB
#define GRID_FREQ_Pin GPIO_PIN_10
#define GRID_FREQ_GPIO_Port GPIOB
#define G3_V_Pin GPIO_PIN_11
#define G3_V_GPIO_Port GPIOB
#define G4_V_Pin GPIO_PIN_12
#define G4_V_GPIO_Port GPIOB
#define G2_V_Pin GPIO_PIN_13
#define G2_V_GPIO_Port GPIOB
#define G1_V_Pin GPIO_PIN_14
#define G1_V_GPIO_Port GPIOB
#define Y3_V_Pin GPIO_PIN_15
#define Y3_V_GPIO_Port GPIOB
#define Y4_V_Pin GPIO_PIN_6
#define Y4_V_GPIO_Port GPIOC
#define Y2_V_Pin GPIO_PIN_7
#define Y2_V_GPIO_Port GPIOC
#define Y1_V_Pin GPIO_PIN_8
#define Y1_V_GPIO_Port GPIOC
#define R3_V_Pin GPIO_PIN_9
#define R3_V_GPIO_Port GPIOC
#define R4_V_Pin GPIO_PIN_8
#define R4_V_GPIO_Port GPIOA
#define R2_V_Pin GPIO_PIN_9
#define R2_V_GPIO_Port GPIOA
#define R1_V_Pin GPIO_PIN_10
#define R1_V_GPIO_Port GPIOA
#define ID0_Pin GPIO_PIN_10
#define ID0_GPIO_Port GPIOC
#define ID1_Pin GPIO_PIN_11
#define ID1_GPIO_Port GPIOC
#define ID2_Pin GPIO_PIN_12
#define ID2_GPIO_Port GPIOC
#define ID3_Pin GPIO_PIN_2
#define ID3_GPIO_Port GPIOD
#define COM_LED_Pin GPIO_PIN_4
#define COM_LED_GPIO_Port GPIOB
#define R1_Pin GPIO_PIN_7
#define R1_GPIO_Port GPIOB
#define Y1_Pin GPIO_PIN_8
#define Y1_GPIO_Port GPIOB
#define G1_Pin GPIO_PIN_9
#define G1_GPIO_Port GPIOB
