mehdinuri/CPU4v1/CPM/CP/App/Adapters/STM32/ControlBusAdapter.h

/* App/Adapters/STM32/ControlBusAdapter.h
 *
 * FDCAN2-backed control-bus adapter for the private CP <-> MP link.
 */
#ifndef CONTROL_BUS_ADAPTER_H
#define CONTROL_BUS_ADAPTER_H

#include "cmsis_os2.h"
#include "fdcan.h"

#include "Ports/IControlBusPort.h"

typedef struct
{
  FDCAN_HandleTypeDef *hfdcan;
  ControlBusRxCallback_t rxCallback;
  void *rxCallbackCtx;
  osMemoryPoolId_t rxPool;
  osMemoryPoolId_t txPool;
  osMessageQueueId_t rxQueue;
  osMessageQueueId_t txQueue;
  uint32_t txErrors;
  uint32_t rxDrops;
  uint32_t txDrops;
} ControlBusAdapterCtx_t;

void ControlBusAdapterInit(ControlBusAdapterCtx_t *ctx,
                           FDCAN_HandleTypeDef *hfdcan);
IControlBusPort_t ControlBusAdapterCreatePort(ControlBusAdapterCtx_t *ctx);
void ControlBusAdapterOnRxIsr(ControlBusAdapterCtx_t *ctx,
                              const FDCAN_RxHeaderTypeDef *header,
                              const uint8_t *data);
void ControlBusAdapterStep(ControlBusAdapterCtx_t *ctx);

#endif /* CONTROL_BUS_ADAPTER_H */
