mehdinuri/CPU4v1/CPM/CP/Core/Src/fdcan.c

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
/* Includes ------------------------------------------------------------------*/
#include "fdcan.h"

/* USER CODE BEGIN 0 */
#include <string.h>
#include "cmsis_os.h"
#include "Adapters/STM32/ControlBusAdapter.h"
#include "Adapters/STM32/FieldBusRxAdapter.h"
#include "Adapters/STM32/MmiCanAdapter.h"

extern ControlBusAdapterCtx_t *MainApplicationGetControlBusAdapter(void);
/* USER CODE END 0 */

FDCAN_HandleTypeDef hfdcan1;
FDCAN_HandleTypeDef hfdcan2;

/* FDCAN1 init function */
void MX_FDCAN1_Init(void)
{

  /* USER CODE BEGIN FDCAN1_Init 0 */
  FDCAN_FilterTypeDef SFilterConfig;

  /* USER CODE END FDCAN1_Init 0 */

  hfdcan1.Instance = FDCAN1;
  hfdcan1.Init.FrameFormat = FDCAN_FRAME_CLASSIC;
  hfdcan1.Init.Mode = FDCAN_MODE_NORMAL;
  hfdcan1.Init.AutoRetransmission = ENABLE;
  hfdcan1.Init.TransmitPause = DISABLE;
  hfdcan1.Init.ProtocolException = ENABLE;
  hfdcan1.Init.NominalPrescaler = 4;
  hfdcan1.Init.NominalSyncJumpWidth = 1;
  hfdcan1.Init.NominalTimeSeg1 = 8;
  hfdcan1.Init.NominalTimeSeg2 = 1;
  hfdcan1.Init.DataPrescaler = 1;
  hfdcan1.Init.DataSyncJumpWidth = 1;
  hfdcan1.Init.DataTimeSeg1 = 1;
  hfdcan1.Init.DataTimeSeg2 = 1;
  hfdcan1.Init.MessageRAMOffset = 0;
  hfdcan1.Init.StdFiltersNbr = 1;
  hfdcan1.Init.ExtFiltersNbr = 0;
  hfdcan1.Init.RxFifo0ElmtsNbr = 32;
  hfdcan1.Init.RxFifo0ElmtSize = FDCAN_DATA_BYTES_8;
  hfdcan1.Init.RxFifo1ElmtsNbr = 0;
  hfdcan1.Init.RxFifo1ElmtSize = FDCAN_DATA_BYTES_8;
  hfdcan1.Init.RxBuffersNbr = 0;
  hfdcan1.Init.RxBufferSize = FDCAN_DATA_BYTES_8;
  hfdcan1.Init.TxEventsNbr = 0;
  hfdcan1.Init.TxBuffersNbr = 0;
  hfdcan1.Init.TxFifoQueueElmtsNbr = 32;
  hfdcan1.Init.TxFifoQueueMode = FDCAN_TX_FIFO_OPERATION;
  hfdcan1.Init.TxElmtSize = FDCAN_DATA_BYTES_8;
  if (HAL_FDCAN_Init(&hfdcan1) != HAL_OK)
  {
    Error_Handler();
  }
  /* USER CODE BEGIN FDCAN1_Init 2 */

  SFilterConfig.IdType = FDCAN_STANDARD_ID;
  SFilterConfig.FilterIndex = 0;
  SFilterConfig.FilterType = FDCAN_FILTER_RANGE;
  SFilterConfig.FilterConfig = FDCAN_FILTER_TO_RXFIFO0;
  SFilterConfig.FilterID1 = 0x000;
  SFilterConfig.FilterID2 = 0x7FF;
  if (HAL_FDCAN_ConfigFilter(&hfdcan1, &SFilterConfig) != HAL_OK)
  {
    Error_Handler();
  }

  if (HAL_FDCAN_ConfigGlobalFilter(&hfdcan1, FDCAN_REJECT, FDCAN_REJECT,
                                   FDCAN_REJECT_REMOTE,
                                   FDCAN_REJECT_REMOTE) != HAL_OK)
  {
    Error_Handler();
  }

  /* USER CODE END FDCAN1_Init 2 */

}
/* FDCAN2 init function */
void MX_FDCAN2_Init(void)
{

  /* USER CODE BEGIN FDCAN2_Init 0 */
  FDCAN_FilterTypeDef SFilterConfig;

  /* USER CODE END FDCAN2_Init 0 */

  hfdcan2.Instance = FDCAN2;
  hfdcan2.Init.FrameFormat = FDCAN_FRAME_FD_BRS;
  hfdcan2.Init.Mode = FDCAN_MODE_NORMAL;
  hfdcan2.Init.AutoRetransmission = ENABLE;
  hfdcan2.Init.TransmitPause = DISABLE;
  hfdcan2.Init.ProtocolException = ENABLE;
  hfdcan2.Init.NominalPrescaler = 4;
  hfdcan2.Init.NominalSyncJumpWidth = 1;
  hfdcan2.Init.NominalTimeSeg1 = 8;
  hfdcan2.Init.NominalTimeSeg2 = 1;
  hfdcan2.Init.DataPrescaler = 10;
  hfdcan2.Init.DataSyncJumpWidth = 1;
  hfdcan2.Init.DataTimeSeg1 = 8;
  hfdcan2.Init.DataTimeSeg2 = 1;
  /* FDCAN1 and FDCAN2 share a single message RAM. Keep FDCAN2 away from the
   * legacy FDCAN1 allocation so both controllers can run concurrently. */
  hfdcan2.Init.MessageRAMOffset = 512;
  hfdcan2.Init.StdFiltersNbr = 1;
  hfdcan2.Init.ExtFiltersNbr = 1;
  hfdcan2.Init.RxFifo0ElmtsNbr = 32;
  hfdcan2.Init.RxFifo0ElmtSize = FDCAN_DATA_BYTES_64;
  hfdcan2.Init.RxFifo1ElmtsNbr = 0;
  hfdcan2.Init.RxFifo1ElmtSize = FDCAN_DATA_BYTES_64;
  hfdcan2.Init.RxBuffersNbr = 0;
  hfdcan2.Init.RxBufferSize = FDCAN_DATA_BYTES_8;
  hfdcan2.Init.TxEventsNbr = 0;
  hfdcan2.Init.TxBuffersNbr = 0;
  hfdcan2.Init.TxFifoQueueElmtsNbr = 32;
  hfdcan2.Init.TxFifoQueueMode = FDCAN_TX_FIFO_OPERATION;
  hfdcan2.Init.TxElmtSize = FDCAN_DATA_BYTES_64;
  if (HAL_FDCAN_Init(&hfdcan2) != HAL_OK)
  {
    Error_Handler();
  }
  /* USER CODE BEGIN FDCAN2_Init 2 */
  SFilterConfig.IdType = FDCAN_STANDARD_ID;
  SFilterConfig.FilterIndex = 0;
  SFilterConfig.FilterType = FDCAN_FILTER_RANGE;
  SFilterConfig.FilterConfig = FDCAN_FILTER_TO_RXFIFO0;
  SFilterConfig.FilterID1 = 0x100U;
  SFilterConfig.FilterID2 = 0x186U;
  if (HAL_FDCAN_ConfigFilter(&hfdcan2, &SFilterConfig) != HAL_OK)
  {
    Error_Handler();
  }

  if (HAL_FDCAN_ConfigGlobalFilter(&hfdcan2, FDCAN_REJECT, FDCAN_REJECT,
                                   FDCAN_REJECT_REMOTE,
                                   FDCAN_REJECT_REMOTE) != HAL_OK)
  {
    Error_Handler();
  }

  /* USER CODE END FDCAN2_Init 2 */

}

static uint32_t HAL_RCC_FDCAN_CLK_ENABLED=0;

void HAL_FDCAN_MspInit(FDCAN_HandleTypeDef* fdcanHandle)
{

  GPIO_InitTypeDef GPIO_InitStruct = {0};
  RCC_PeriphCLKInitTypeDef PeriphClkInitStruct = {0};
  if(fdcanHandle->Instance==FDCAN1)
  {
  /** Initializes the peripherals clock
  */
    PeriphClkInitStruct.PeriphClockSelection = RCC_PERIPHCLK_FDCAN;
    PeriphClkInitStruct.FdcanClockSelection = RCC_FDCANCLKSOURCE_PLL;
    if (HAL_RCCEx_PeriphCLKConfig(&PeriphClkInitStruct) != HAL_OK)
    {
      Error_Handler();
    }

    /* FDCAN1 clock enable */
    HAL_RCC_FDCAN_CLK_ENABLED++;
    if(HAL_RCC_FDCAN_CLK_ENABLED==1){
      __HAL_RCC_FDCAN_CLK_ENABLE();
    }

    __HAL_RCC_GPIOD_CLK_ENABLE();
    /**FDCAN1 GPIO Configuration
    PD0     ------> FDCAN1_RX
    PD1     ------> FDCAN1_TX
    */
    GPIO_InitStruct.Pin = GPIO_PIN_0|GPIO_PIN_1;
    GPIO_InitStruct.Mode = GPIO_MODE_AF_PP;
    GPIO_InitStruct.Pull = GPIO_NOPULL;
    GPIO_InitStruct.Speed = GPIO_SPEED_FREQ_LOW;
    GPIO_InitStruct.Alternate = GPIO_AF9_FDCAN1;
    HAL_GPIO_Init(GPIOD, &GPIO_InitStruct);

    /* FDCAN1 interrupt Init */
    HAL_NVIC_SetPriority(FDCAN1_IT0_IRQn, 5, 0);
    HAL_NVIC_EnableIRQ(FDCAN1_IT0_IRQn);
  }
  else if(fdcanHandle->Instance==FDCAN2)
  {
  /** Initializes the peripherals clock
  */
    PeriphClkInitStruct.PeriphClockSelection = RCC_PERIPHCLK_FDCAN;
    PeriphClkInitStruct.FdcanClockSelection = RCC_FDCANCLKSOURCE_PLL;
    if (HAL_RCCEx_PeriphCLKConfig(&PeriphClkInitStruct) != HAL_OK)
    {
      Error_Handler();
    }

    /* FDCAN2 clock enable */
    HAL_RCC_FDCAN_CLK_ENABLED++;
    if(HAL_RCC_FDCAN_CLK_ENABLED==1){
      __HAL_RCC_FDCAN_CLK_ENABLE();
    }

    __HAL_RCC_GPIOB_CLK_ENABLE();
    /**FDCAN2 GPIO Configuration
    PB5     ------> FDCAN2_RX
    PB6     ------> FDCAN2_TX
    */
    GPIO_InitStruct.Pin = GPIO_PIN_5|GPIO_PIN_6;
    GPIO_InitStruct.Mode = GPIO_MODE_AF_PP;
    GPIO_InitStruct.Pull = GPIO_NOPULL;
    GPIO_InitStruct.Speed = GPIO_SPEED_FREQ_LOW;
    GPIO_InitStruct.Alternate = GPIO_AF9_FDCAN2;
    HAL_GPIO_Init(GPIOB, &GPIO_InitStruct);

    /* FDCAN2 interrupt Init */
    HAL_NVIC_SetPriority(FDCAN2_IT0_IRQn, 5, 0);
    HAL_NVIC_EnableIRQ(FDCAN2_IT0_IRQn);
  }
}

void HAL_FDCAN_MspDeInit(FDCAN_HandleTypeDef* fdcanHandle)
{

  if(fdcanHandle->Instance==FDCAN1)
  {
    /* Peripheral clock disable */
    HAL_RCC_FDCAN_CLK_ENABLED--;
    if(HAL_RCC_FDCAN_CLK_ENABLED==0){
      __HAL_RCC_FDCAN_CLK_DISABLE();
    }

    /**FDCAN1 GPIO Configuration
    PD0     ------> FDCAN1_RX
    PD1     ------> FDCAN1_TX
    */
    HAL_GPIO_DeInit(GPIOD, GPIO_PIN_0|GPIO_PIN_1);

    /* FDCAN1 interrupt Deinit */
    HAL_NVIC_DisableIRQ(FDCAN1_IT0_IRQn);
  }
  else if(fdcanHandle->Instance==FDCAN2)
  {
    /* Peripheral clock disable */
    HAL_RCC_FDCAN_CLK_ENABLED--;
    if(HAL_RCC_FDCAN_CLK_ENABLED==0){
      __HAL_RCC_FDCAN_CLK_DISABLE();
    }

    /**FDCAN2 GPIO Configuration
    PB5     ------> FDCAN2_RX
    PB6     ------> FDCAN2_TX
    */
    HAL_GPIO_DeInit(GPIOB, GPIO_PIN_5|GPIO_PIN_6);

    /* FDCAN2 interrupt Deinit */
    HAL_NVIC_DisableIRQ(FDCAN2_IT0_IRQn);
  }
}

/* USER CODE BEGIN 1 */
void CANStart(FDCAN_HandleTypeDef *hfdcan)
{
  if (HAL_FDCAN_Start(hfdcan) != HAL_OK)
  {
    Error_Handler();
  }

  if (HAL_FDCAN_ActivateNotification(hfdcan, FDCAN_IT_RX_FIFO0_NEW_MESSAGE,
                                     0) != HAL_OK)
  {
    Error_Handler();
  }
}

void CANStop(FDCAN_HandleTypeDef *hfdcan)
{
  HAL_FDCAN_Stop(hfdcan);
}

void CANDeInit(FDCAN_HandleTypeDef *hfdcan)
{
  CANStop(hfdcan);

  HAL_FDCAN_DeInit(hfdcan);
}

void CANSendMessage(tpSFDCANTxMsg pxCANTxMessage)
{
  if (HAL_FDCAN_AddMessageToTxFifoQ(pxCANTxMessage->hfdcan,
                                    &pxCANTxMessage->TxHeader,
                                    pxCANTxMessage->Data) != HAL_OK)
  {
    Error_Handler();
  }
}

void CANWaitTransmissionComplete(FDCAN_HandleTypeDef *hfdcan)
{
  while (HAL_FDCAN_GetTxFifoFreeLevel(hfdcan) == 0)
  {
    osDelay(1);
  }
}

void HAL_FDCAN_RxFifo0Callback(FDCAN_HandleTypeDef *hfdcan, uint32_t RxFifo0ITs)
{
  if (hfdcan->Instance == FDCAN1)
  {
    tSFDCANRxMsg SRxMsg;

    memset(&SRxMsg, 0, sizeof(SRxMsg));

    SRxMsg.hfdcan = &hfdcan1;

    if (HAL_FDCAN_GetRxMessage(hfdcan, FDCAN_RX_FIFO0, &SRxMsg.RxHeader,
                               SRxMsg.Data) != HAL_OK)
    {
      Error_Handler();
    }

    FieldBusRxAdapterOnRxIsr(&SRxMsg.RxHeader, &SRxMsg.Data[0]);

    if ((SRxMsg.RxHeader.Identifier >= MMI_PROTOCOL_V2_CAN_ID_ACK)
        && (SRxMsg.RxHeader.Identifier <= MMI_PROTOCOL_V2_CAN_ID_HELLO_REQ))
    {
      MmiCanAdapterOnRxIsr(&SRxMsg.RxHeader, &SRxMsg.Data[0]);
    }
  }
  else if (hfdcan->Instance == FDCAN2)
  {
    tSFDCANRxMsg SRxMsg;
    ControlBusAdapterCtx_t *controlBusAdapter;

    memset(&SRxMsg, 0, sizeof(SRxMsg));

    if (HAL_FDCAN_GetRxMessage(hfdcan, FDCAN_RX_FIFO0, &SRxMsg.RxHeader,
                               SRxMsg.Data) != HAL_OK)
    {
      Error_Handler();
    }

    controlBusAdapter = MainApplicationGetControlBusAdapter();
    if (controlBusAdapter != NULL)
    {
      ControlBusAdapterOnRxIsr(controlBusAdapter,
                               &SRxMsg.RxHeader,
                               &SRxMsg.Data[0]);
    }
  }
}

/* USER CODE END 1 */
