mehdinuri/CPU4v1/CPM/MP/Core/Src/i2c.c

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
/* Includes ------------------------------------------------------------------*/
#include "i2c.h"

/* USER CODE BEGIN 0 */
#include "cmsis_os.h"
#include <string.h>

#define EVENT_FLAGS_I2C4_ERROR 0x01U
#define EVENT_FLAGS_I2C4_RX_COMPLETE 0x02U
#define EVENT_FLAGS_I2C4_TX_COMPLETE 0x04U
#define EVENT_FLAGS_I2C4_ADDR_ACKNOWLEDGED 0x04U
#define EVENT_FLAGS_I2C4_LISTEN_COMPLETE 0x08U

static osEventFlagsId_t s_i2c4EventHandle = NULL;

/* USER CODE END 0 */

I2C_HandleTypeDef hi2c3;
I2C_HandleTypeDef hi2c4;
DMA_HandleTypeDef hdma_i2c3_rx;
DMA_HandleTypeDef hdma_i2c3_tx;
DMA_HandleTypeDef hdma_i2c4_rx;
DMA_HandleTypeDef hdma_i2c4_tx;

/* I2C3 init function */
void MX_I2C3_Init(void)
{

  hi2c3.Instance = I2C3;
  hi2c3.Init.Timing = 0x10F32A82;
  hi2c3.Init.OwnAddress1 = 0;
  hi2c3.Init.AddressingMode = I2C_ADDRESSINGMODE_7BIT;
  hi2c3.Init.DualAddressMode = I2C_DUALADDRESS_DISABLE;
  hi2c3.Init.OwnAddress2 = 0;
  hi2c3.Init.OwnAddress2Masks = I2C_OA2_NOMASK;
  hi2c3.Init.GeneralCallMode = I2C_GENERALCALL_DISABLE;
  hi2c3.Init.NoStretchMode = I2C_NOSTRETCH_DISABLE;
  if (HAL_I2C_Init(&hi2c3) != HAL_OK)
  {
    Error_Handler();
  }

  /** Configure Analogue filter
  */
  if (HAL_I2CEx_ConfigAnalogFilter(&hi2c3, I2C_ANALOGFILTER_ENABLE) != HAL_OK)
  {
    Error_Handler();
  }

  /** Configure Digital filter
  */
  if (HAL_I2CEx_ConfigDigitalFilter(&hi2c3, 0) != HAL_OK)
  {
    Error_Handler();
  }
}
/* I2C4 init function */
void MX_I2C4_Init(void)
{

  hi2c4.Instance = I2C4;
  hi2c4.Init.Timing = 0x10F0277E;
  hi2c4.Init.OwnAddress1 = 783;
  hi2c4.Init.AddressingMode = I2C_ADDRESSINGMODE_10BIT;
  hi2c4.Init.DualAddressMode = I2C_DUALADDRESS_DISABLE;
  hi2c4.Init.OwnAddress2 = 0;
  hi2c4.Init.OwnAddress2Masks = I2C_OA2_NOMASK;
  hi2c4.Init.GeneralCallMode = I2C_GENERALCALL_DISABLE;
  hi2c4.Init.NoStretchMode = I2C_NOSTRETCH_DISABLE;
  if (HAL_I2C_Init(&hi2c4) != HAL_OK)
  {
    Error_Handler();
  }

  /** Configure Analogue filter
  */
  if (HAL_I2CEx_ConfigAnalogFilter(&hi2c4, I2C_ANALOGFILTER_ENABLE) != HAL_OK)
  {
    Error_Handler();
  }

  /** Configure Digital filter
  */
  if (HAL_I2CEx_ConfigDigitalFilter(&hi2c4, 7) != HAL_OK)
  {
    Error_Handler();
  }
  /* USER CODE BEGIN I2C4_Init 2 */
	if (HAL_I2C_EnableListen_IT(&hi2c4) != HAL_OK)
	{
		Error_Handler();
	}
  /* USER CODE END I2C4_Init 2 */

}

void HAL_I2C_MspInit(I2C_HandleTypeDef* i2cHandle)
{

  GPIO_InitTypeDef GPIO_InitStruct = {0};
  RCC_PeriphCLKInitTypeDef PeriphClkInit = {0};
  if(i2cHandle->Instance==I2C3)
  {
  /** Initializes the peripherals clocks
  */
    PeriphClkInit.PeriphClockSelection = RCC_PERIPHCLK_I2C3;
    PeriphClkInit.I2c3ClockSelection = RCC_I2C3CLKSOURCE_PCLK1;
    if (HAL_RCCEx_PeriphCLKConfig(&PeriphClkInit) != HAL_OK)
    {
      Error_Handler();
    }

    __HAL_RCC_GPIOC_CLK_ENABLE();
    /**I2C3 GPIO Configuration
    PC8     ------> I2C3_SCL
    PC9     ------> I2C3_SDA
    */
    GPIO_InitStruct.Pin = GPIO_PIN_8|GPIO_PIN_9;
    GPIO_InitStruct.Mode = GPIO_MODE_AF_OD;
    GPIO_InitStruct.Pull = GPIO_PULLUP;
    GPIO_InitStruct.Speed = GPIO_SPEED_FREQ_LOW;
    GPIO_InitStruct.Alternate = GPIO_AF8_I2C3;
    HAL_GPIO_Init(GPIOC, &GPIO_InitStruct);

    /* I2C3 clock enable */
    __HAL_RCC_I2C3_CLK_ENABLE();

    /* I2C3 DMA Init */
    /* I2C3_RX Init */
    hdma_i2c3_rx.Instance = DMA1_Channel1;
    hdma_i2c3_rx.Init.Request = DMA_REQUEST_I2C3_RX;
    hdma_i2c3_rx.Init.Direction = DMA_PERIPH_TO_MEMORY;
    hdma_i2c3_rx.Init.PeriphInc = DMA_PINC_DISABLE;
    hdma_i2c3_rx.Init.MemInc = DMA_MINC_ENABLE;
    hdma_i2c3_rx.Init.PeriphDataAlignment = DMA_PDATAALIGN_BYTE;
    hdma_i2c3_rx.Init.MemDataAlignment = DMA_MDATAALIGN_BYTE;
    hdma_i2c3_rx.Init.Mode = DMA_NORMAL;
    hdma_i2c3_rx.Init.Priority = DMA_PRIORITY_LOW;
    if (HAL_DMA_Init(&hdma_i2c3_rx) != HAL_OK)
    {
      Error_Handler();
    }

    __HAL_LINKDMA(i2cHandle,hdmarx,hdma_i2c3_rx);

    /* I2C3_TX Init */
    hdma_i2c3_tx.Instance = DMA1_Channel2;
    hdma_i2c3_tx.Init.Request = DMA_REQUEST_I2C3_TX;
    hdma_i2c3_tx.Init.Direction = DMA_MEMORY_TO_PERIPH;
    hdma_i2c3_tx.Init.PeriphInc = DMA_PINC_DISABLE;
    hdma_i2c3_tx.Init.MemInc = DMA_MINC_ENABLE;
    hdma_i2c3_tx.Init.PeriphDataAlignment = DMA_PDATAALIGN_BYTE;
    hdma_i2c3_tx.Init.MemDataAlignment = DMA_MDATAALIGN_BYTE;
    hdma_i2c3_tx.Init.Mode = DMA_NORMAL;
    hdma_i2c3_tx.Init.Priority = DMA_PRIORITY_LOW;
    if (HAL_DMA_Init(&hdma_i2c3_tx) != HAL_OK)
    {
      Error_Handler();
    }

    __HAL_LINKDMA(i2cHandle,hdmatx,hdma_i2c3_tx);

    /* I2C3 interrupt Init */
    HAL_NVIC_SetPriority(I2C3_EV_IRQn, 5, 0);
    HAL_NVIC_EnableIRQ(I2C3_EV_IRQn);
    HAL_NVIC_SetPriority(I2C3_ER_IRQn, 5, 0);
    HAL_NVIC_EnableIRQ(I2C3_ER_IRQn);
  }
  else if(i2cHandle->Instance==I2C4)
  {
  /** Initializes the peripherals clocks
  */
    PeriphClkInit.PeriphClockSelection = RCC_PERIPHCLK_I2C4;
    PeriphClkInit.I2c4ClockSelection = RCC_I2C4CLKSOURCE_PCLK1;
    if (HAL_RCCEx_PeriphCLKConfig(&PeriphClkInit) != HAL_OK)
    {
      Error_Handler();
    }

    __HAL_RCC_GPIOC_CLK_ENABLE();
    /**I2C4 GPIO Configuration
    PC6     ------> I2C4_SCL
    PC7     ------> I2C4_SDA
    */
    GPIO_InitStruct.Pin = GPIO_PIN_6|GPIO_PIN_7;
    GPIO_InitStruct.Mode = GPIO_MODE_AF_OD;
    GPIO_InitStruct.Pull = GPIO_PULLUP;
    GPIO_InitStruct.Speed = GPIO_SPEED_FREQ_LOW;
    GPIO_InitStruct.Alternate = GPIO_AF8_I2C4;
    HAL_GPIO_Init(GPIOC, &GPIO_InitStruct);

    /* I2C4 clock enable */
    __HAL_RCC_I2C4_CLK_ENABLE();

    /* I2C4 DMA Init */
    /* I2C4_RX Init */
    hdma_i2c4_rx.Instance = DMA1_Channel3;
    hdma_i2c4_rx.Init.Request = DMA_REQUEST_I2C4_RX;
    hdma_i2c4_rx.Init.Direction = DMA_PERIPH_TO_MEMORY;
    hdma_i2c4_rx.Init.PeriphInc = DMA_PINC_DISABLE;
    hdma_i2c4_rx.Init.MemInc = DMA_MINC_ENABLE;
    hdma_i2c4_rx.Init.PeriphDataAlignment = DMA_PDATAALIGN_BYTE;
    hdma_i2c4_rx.Init.MemDataAlignment = DMA_MDATAALIGN_BYTE;
    hdma_i2c4_rx.Init.Mode = DMA_NORMAL;
    hdma_i2c4_rx.Init.Priority = DMA_PRIORITY_LOW;
    if (HAL_DMA_Init(&hdma_i2c4_rx) != HAL_OK)
    {
      Error_Handler();
    }

    __HAL_LINKDMA(i2cHandle,hdmarx,hdma_i2c4_rx);

    /* I2C4_TX Init */
    hdma_i2c4_tx.Instance = DMA1_Channel4;
    hdma_i2c4_tx.Init.Request = DMA_REQUEST_I2C4_TX;
    hdma_i2c4_tx.Init.Direction = DMA_MEMORY_TO_PERIPH;
    hdma_i2c4_tx.Init.PeriphInc = DMA_PINC_DISABLE;
    hdma_i2c4_tx.Init.MemInc = DMA_MINC_ENABLE;
    hdma_i2c4_tx.Init.PeriphDataAlignment = DMA_PDATAALIGN_BYTE;
    hdma_i2c4_tx.Init.MemDataAlignment = DMA_MDATAALIGN_BYTE;
    hdma_i2c4_tx.Init.Mode = DMA_NORMAL;
    hdma_i2c4_tx.Init.Priority = DMA_PRIORITY_LOW;
    if (HAL_DMA_Init(&hdma_i2c4_tx) != HAL_OK)
    {
      Error_Handler();
    }

    __HAL_LINKDMA(i2cHandle,hdmatx,hdma_i2c4_tx);

    /* I2C4 interrupt Init */
    HAL_NVIC_SetPriority(I2C4_EV_IRQn, 5, 0);
    HAL_NVIC_EnableIRQ(I2C4_EV_IRQn);
    HAL_NVIC_SetPriority(I2C4_ER_IRQn, 5, 0);
    HAL_NVIC_EnableIRQ(I2C4_ER_IRQn);
  }
}

void HAL_I2C_MspDeInit(I2C_HandleTypeDef* i2cHandle)
{

  if(i2cHandle->Instance==I2C3)
  {
    /* Peripheral clock disable */
    __HAL_RCC_I2C3_CLK_DISABLE();

    /**I2C3 GPIO Configuration
    PC8     ------> I2C3_SCL
    PC9     ------> I2C3_SDA
    */
    HAL_GPIO_DeInit(GPIOC, GPIO_PIN_8);

    HAL_GPIO_DeInit(GPIOC, GPIO_PIN_9);

    /* I2C3 DMA DeInit */
    HAL_DMA_DeInit(i2cHandle->hdmarx);
    HAL_DMA_DeInit(i2cHandle->hdmatx);

    /* I2C3 interrupt Deinit */
    HAL_NVIC_DisableIRQ(I2C3_EV_IRQn);
    HAL_NVIC_DisableIRQ(I2C3_ER_IRQn);
  }
  else if(i2cHandle->Instance==I2C4)
  {
    /* Peripheral clock disable */
    __HAL_RCC_I2C4_CLK_DISABLE();

    /**I2C4 GPIO Configuration
    PC6     ------> I2C4_SCL
    PC7     ------> I2C4_SDA
    */
    HAL_GPIO_DeInit(GPIOC, GPIO_PIN_6);

    HAL_GPIO_DeInit(GPIOC, GPIO_PIN_7);

    /* I2C4 DMA DeInit */
    HAL_DMA_DeInit(i2cHandle->hdmarx);
    HAL_DMA_DeInit(i2cHandle->hdmatx);

    /* I2C4 interrupt Deinit */
    HAL_NVIC_DisableIRQ(I2C4_EV_IRQn);
    HAL_NVIC_DisableIRQ(I2C4_ER_IRQn);
  }
}

/* USER CODE BEGIN 1 */
void I2CDeInit(I2C_HandleTypeDef* hi2c)
{
	HAL_I2C_DeInit(hi2c);
}

void HAL_I2C_AddrCallback(I2C_HandleTypeDef *hi2c, uint8_t TransferDirection, uint16_t AddrMatchCode)
{
	if (hi2c->Instance == I2C4)
  {
		if (TransferDirection == I2C_DIRECTION_TRANSMIT)
		{
			if (s_i2c4EventHandle != NULL)
      {
        (void) osEventFlagsSet(s_i2c4EventHandle,
                               EVENT_FLAGS_I2C4_ADDR_ACKNOWLEDGED);
      }
		}
  }
}

void HAL_I2C_ListenCpltCallback(I2C_HandleTypeDef *hi2c)
{
	if (hi2c->Instance == I2C4)
  {
		if (s_i2c4EventHandle != NULL)
    {
      (void) osEventFlagsSet(s_i2c4EventHandle, EVENT_FLAGS_I2C4_LISTEN_COMPLETE);
    }
  }
}

void HAL_I2C_ErrorCallback(I2C_HandleTypeDef *I2cHandle)
{
	if (I2cHandle->Instance == I2C4)
	{
		if (s_i2c4EventHandle != NULL)
    {
      (void) osEventFlagsSet(s_i2c4EventHandle, EVENT_FLAGS_I2C4_ERROR);
    }
	}
}

void HAL_I2C_SlaveRxCpltCallback(I2C_HandleTypeDef *I2cHandle)
{
	if (I2cHandle->Instance == I2C4)
	{
		if (s_i2c4EventHandle != NULL)
		{
			(void) osEventFlagsSet(s_i2c4EventHandle, EVENT_FLAGS_I2C4_RX_COMPLETE);
		}
	}
}

void HAL_I2C_SlaveTxCpltCallback(I2C_HandleTypeDef *I2cHandle)
{
	if (I2cHandle->Instance == I2C4)
	{
		if (s_i2c4EventHandle != NULL)
		{
			(void) osEventFlagsSet(s_i2c4EventHandle, EVENT_FLAGS_I2C4_TX_COMPLETE);
		}
	}
}
/* USER CODE END 1 */
