mehdinuri/CPU4v1/CPM/CP/Core/Src/i2c.c

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
/* Includes ------------------------------------------------------------------*/
#include "i2c.h"

/* USER CODE BEGIN 0 */
#include "cmsis_os2.h"
#include "defs.h"

/* USER CODE END 0 */

I2C_HandleTypeDef hi2c1;
I2C_HandleTypeDef hi2c4;
DMA_HandleTypeDef hdma_i2c1_rx;
DMA_HandleTypeDef hdma_i2c1_tx;
DMA_HandleTypeDef hdma_i2c4_rx;
DMA_HandleTypeDef hdma_i2c4_tx;

/* I2C1 init function */
void MX_I2C1_Init(void)
{

  hi2c1.Instance = I2C1;
  hi2c1.Init.Timing = 0x10B01C5D;
  hi2c1.Init.OwnAddress1 = 783;
  hi2c1.Init.AddressingMode = I2C_ADDRESSINGMODE_10BIT;
  hi2c1.Init.DualAddressMode = I2C_DUALADDRESS_DISABLE;
  hi2c1.Init.OwnAddress2 = 0;
  hi2c1.Init.OwnAddress2Masks = I2C_OA2_NOMASK;
  hi2c1.Init.GeneralCallMode = I2C_GENERALCALL_DISABLE;
  hi2c1.Init.NoStretchMode = I2C_NOSTRETCH_DISABLE;
  if (HAL_I2C_Init(&hi2c1) != HAL_OK)
  {
    Error_Handler();
  }

  /** Configure Analogue filter
  */
  if (HAL_I2CEx_ConfigAnalogFilter(&hi2c1, I2C_ANALOGFILTER_ENABLE) != HAL_OK)
  {
    Error_Handler();
  }

  /** Configure Digital filter
  */
  if (HAL_I2CEx_ConfigDigitalFilter(&hi2c1, 7) != HAL_OK)
  {
    Error_Handler();
  }
}
/* I2C4 init function */
void MX_I2C4_Init(void)
{

  hi2c4.Instance = I2C4;
  hi2c4.Init.Timing = 0x10B01C5D;
  hi2c4.Init.OwnAddress1 = 0;
  hi2c4.Init.AddressingMode = I2C_ADDRESSINGMODE_7BIT;
  hi2c4.Init.DualAddressMode = I2C_DUALADDRESS_DISABLE;
  hi2c4.Init.OwnAddress2 = 0;
  hi2c4.Init.OwnAddress2Masks = I2C_OA2_NOMASK;
  hi2c4.Init.GeneralCallMode = I2C_GENERALCALL_DISABLE;
  hi2c4.Init.NoStretchMode = I2C_NOSTRETCH_DISABLE;
  if (HAL_I2C_Init(&hi2c4) != HAL_OK)
  {
    Error_Handler();
  }

  /** Configure Analogue filter
  */
  if (HAL_I2CEx_ConfigAnalogFilter(&hi2c4, I2C_ANALOGFILTER_ENABLE) != HAL_OK)
  {
    Error_Handler();
  }

  /** Configure Digital filter
  */
  if (HAL_I2CEx_ConfigDigitalFilter(&hi2c4, 7) != HAL_OK)
  {
    Error_Handler();
  }
}

void HAL_I2C_MspInit(I2C_HandleTypeDef* i2cHandle)
{

  GPIO_InitTypeDef GPIO_InitStruct = {0};
  if(i2cHandle->Instance==I2C1)
  {
    __HAL_RCC_GPIOB_CLK_ENABLE();
    /**I2C1 GPIO Configuration
    PB7     ------> I2C1_SDA
    PB8     ------> I2C1_SCL
    */
    GPIO_InitStruct.Pin = GPIO_PIN_7|GPIO_PIN_8;
    GPIO_InitStruct.Mode = GPIO_MODE_AF_OD;
    GPIO_InitStruct.Pull = GPIO_PULLUP;
    GPIO_InitStruct.Speed = GPIO_SPEED_FREQ_LOW;
    GPIO_InitStruct.Alternate = GPIO_AF4_I2C1;
    HAL_GPIO_Init(GPIOB, &GPIO_InitStruct);

    /* I2C1 clock enable */
    __HAL_RCC_I2C1_CLK_ENABLE();

    /* I2C1 DMA Init */
    /* I2C1_RX Init */
    hdma_i2c1_rx.Instance = DMA2_Stream0;
    hdma_i2c1_rx.Init.Request = DMA_REQUEST_I2C1_RX;
    hdma_i2c1_rx.Init.Direction = DMA_PERIPH_TO_MEMORY;
    hdma_i2c1_rx.Init.PeriphInc = DMA_PINC_DISABLE;
    hdma_i2c1_rx.Init.MemInc = DMA_MINC_ENABLE;
    hdma_i2c1_rx.Init.PeriphDataAlignment = DMA_PDATAALIGN_BYTE;
    hdma_i2c1_rx.Init.MemDataAlignment = DMA_MDATAALIGN_BYTE;
    hdma_i2c1_rx.Init.Mode = DMA_NORMAL;
    hdma_i2c1_rx.Init.Priority = DMA_PRIORITY_HIGH;
    hdma_i2c1_rx.Init.FIFOMode = DMA_FIFOMODE_DISABLE;
    if (HAL_DMA_Init(&hdma_i2c1_rx) != HAL_OK)
    {
      Error_Handler();
    }

    __HAL_LINKDMA(i2cHandle,hdmarx,hdma_i2c1_rx);

    /* I2C1_TX Init */
    hdma_i2c1_tx.Instance = DMA2_Stream1;
    hdma_i2c1_tx.Init.Request = DMA_REQUEST_I2C1_TX;
    hdma_i2c1_tx.Init.Direction = DMA_MEMORY_TO_PERIPH;
    hdma_i2c1_tx.Init.PeriphInc = DMA_PINC_DISABLE;
    hdma_i2c1_tx.Init.MemInc = DMA_MINC_ENABLE;
    hdma_i2c1_tx.Init.PeriphDataAlignment = DMA_PDATAALIGN_BYTE;
    hdma_i2c1_tx.Init.MemDataAlignment = DMA_MDATAALIGN_BYTE;
    hdma_i2c1_tx.Init.Mode = DMA_NORMAL;
    hdma_i2c1_tx.Init.Priority = DMA_PRIORITY_HIGH;
    hdma_i2c1_tx.Init.FIFOMode = DMA_FIFOMODE_DISABLE;
    if (HAL_DMA_Init(&hdma_i2c1_tx) != HAL_OK)
    {
      Error_Handler();
    }

    __HAL_LINKDMA(i2cHandle,hdmatx,hdma_i2c1_tx);

    /* I2C1 interrupt Init */
    HAL_NVIC_SetPriority(I2C1_EV_IRQn, 5, 0);
    HAL_NVIC_EnableIRQ(I2C1_EV_IRQn);
    HAL_NVIC_SetPriority(I2C1_ER_IRQn, 5, 0);
    HAL_NVIC_EnableIRQ(I2C1_ER_IRQn);
  }
  else if(i2cHandle->Instance==I2C4)
  {
    __HAL_RCC_GPIOD_CLK_ENABLE();
    /**I2C4 GPIO Configuration
    PD12     ------> I2C4_SCL
    PD13     ------> I2C4_SDA
    */
    GPIO_InitStruct.Pin = GPIO_PIN_12|GPIO_PIN_13;
    GPIO_InitStruct.Mode = GPIO_MODE_AF_OD;
    GPIO_InitStruct.Pull = GPIO_PULLUP;
    GPIO_InitStruct.Speed = GPIO_SPEED_FREQ_LOW;
    GPIO_InitStruct.Alternate = GPIO_AF4_I2C4;
    HAL_GPIO_Init(GPIOD, &GPIO_InitStruct);

    /* I2C4 clock enable */
    __HAL_RCC_I2C4_CLK_ENABLE();

    /* I2C4 DMA Init */
    /* I2C4_RX Init */
    hdma_i2c4_rx.Instance = BDMA_Channel0;
    hdma_i2c4_rx.Init.Request = BDMA_REQUEST_I2C4_RX;
    hdma_i2c4_rx.Init.Direction = DMA_PERIPH_TO_MEMORY;
    hdma_i2c4_rx.Init.PeriphInc = DMA_PINC_DISABLE;
    hdma_i2c4_rx.Init.MemInc = DMA_MINC_ENABLE;
    hdma_i2c4_rx.Init.PeriphDataAlignment = DMA_PDATAALIGN_BYTE;
    hdma_i2c4_rx.Init.MemDataAlignment = DMA_MDATAALIGN_BYTE;
    hdma_i2c4_rx.Init.Mode = DMA_NORMAL;
    hdma_i2c4_rx.Init.Priority = DMA_PRIORITY_HIGH;
    if (HAL_DMA_Init(&hdma_i2c4_rx) != HAL_OK)
    {
      Error_Handler();
    }

    __HAL_LINKDMA(i2cHandle,hdmarx,hdma_i2c4_rx);

    /* I2C4_TX Init */
    hdma_i2c4_tx.Instance = BDMA_Channel1;
    hdma_i2c4_tx.Init.Request = BDMA_REQUEST_I2C4_TX;
    hdma_i2c4_tx.Init.Direction = DMA_MEMORY_TO_PERIPH;
    hdma_i2c4_tx.Init.PeriphInc = DMA_PINC_DISABLE;
    hdma_i2c4_tx.Init.MemInc = DMA_MINC_ENABLE;
    hdma_i2c4_tx.Init.PeriphDataAlignment = DMA_PDATAALIGN_BYTE;
    hdma_i2c4_tx.Init.MemDataAlignment = DMA_MDATAALIGN_BYTE;
    hdma_i2c4_tx.Init.Mode = DMA_NORMAL;
    hdma_i2c4_tx.Init.Priority = DMA_PRIORITY_HIGH;
    if (HAL_DMA_Init(&hdma_i2c4_tx) != HAL_OK)
    {
      Error_Handler();
    }

    __HAL_LINKDMA(i2cHandle,hdmatx,hdma_i2c4_tx);

    /* I2C4 interrupt Init */
    HAL_NVIC_SetPriority(I2C4_EV_IRQn, 5, 0);
    HAL_NVIC_EnableIRQ(I2C4_EV_IRQn);
    HAL_NVIC_SetPriority(I2C4_ER_IRQn, 5, 0);
    HAL_NVIC_EnableIRQ(I2C4_ER_IRQn);
  }
}

void HAL_I2C_MspDeInit(I2C_HandleTypeDef* i2cHandle)
{

  if(i2cHandle->Instance==I2C1)
  {
    /* Peripheral clock disable */
    __HAL_RCC_I2C1_CLK_DISABLE();

    /**I2C1 GPIO Configuration
    PB7     ------> I2C1_SDA
    PB8     ------> I2C1_SCL
    */
    HAL_GPIO_DeInit(GPIOB, GPIO_PIN_7);

    HAL_GPIO_DeInit(GPIOB, GPIO_PIN_8);

    /* I2C1 DMA DeInit */
    HAL_DMA_DeInit(i2cHandle->hdmarx);
    HAL_DMA_DeInit(i2cHandle->hdmatx);

    /* I2C1 interrupt Deinit */
    HAL_NVIC_DisableIRQ(I2C1_EV_IRQn);
    HAL_NVIC_DisableIRQ(I2C1_ER_IRQn);
  }
  else if(i2cHandle->Instance==I2C4)
  {
    /* Peripheral clock disable */
    __HAL_RCC_I2C4_CLK_DISABLE();

    /**I2C4 GPIO Configuration
    PD12     ------> I2C4_SCL
    PD13     ------> I2C4_SDA
    */
    HAL_GPIO_DeInit(GPIOD, GPIO_PIN_12);

    HAL_GPIO_DeInit(GPIOD, GPIO_PIN_13);

    /* I2C4 DMA DeInit */
    HAL_DMA_DeInit(i2cHandle->hdmarx);
    HAL_DMA_DeInit(i2cHandle->hdmatx);

    /* I2C4 interrupt Deinit */
    HAL_NVIC_DisableIRQ(I2C4_EV_IRQn);
    HAL_NVIC_DisableIRQ(I2C4_ER_IRQn);
  }
}

/* USER CODE BEGIN 1 */
void I2CDeInit(I2C_HandleTypeDef *i2chandle)
{
  HAL_I2C_DeInit(i2chandle);
}

void HAL_I2C_ErrorCallback(I2C_HandleTypeDef *I2cHandle)
{
  if (I2cHandle->Instance == I2C1)
  {
    if (I2C1EventHandle != NULL)
    {
      osEventFlagsSet(I2C1EventHandle, EVENT_FLAGS_I2C1_ERROR);
    }
  }
  else if (I2cHandle->Instance == I2C4)
  {
    if (I2C4EventHandle != NULL)
    {
      osEventFlagsSet(I2C4EventHandle, EVENT_FLAGS_I2C4_ERROR);
    }
  }
}

void HAL_I2C_MasterRxCpltCallback(I2C_HandleTypeDef *I2cHandle)
{
  if (I2cHandle->Instance == I2C1)
  {
    if (I2C1EventHandle != NULL)
    {
      osEventFlagsSet(I2C1EventHandle, EVENT_FLAGS_I2C1_RX_COMPLETE);
    }
  }
  else if (I2cHandle->Instance == I2C4)
  {
    if (I2C4EventHandle != NULL)
    {
      osEventFlagsSet(I2C4EventHandle, EVENT_FLAGS_I2C4_RX_COMPLETE);
    }
  }
}

void HAL_I2C_MasterTxCpltCallback(I2C_HandleTypeDef *I2cHandle)
{
  if (I2cHandle->Instance == I2C1)
  {
    if (I2C1EventHandle != NULL)
    {
      osEventFlagsSet(I2C1EventHandle, EVENT_FLAGS_I2C1_TX_COMPLETE);
    }
  }
  else if (I2cHandle->Instance == I2C4)
  {
    if (I2C4EventHandle != NULL)
    {
      osEventFlagsSet(I2C4EventHandle, EVENT_FLAGS_I2C4_TX_COMPLETE);
    }
  }
}

/* USER CODE END 1 */
