mehdinuri/CPU4v1/CPM/CP/Core/Src/usart.c

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
/* Includes ------------------------------------------------------------------*/
#include "usart.h"

/* USER CODE BEGIN 0 */
#include <string.h>
#include "SerialAdapter.h"

/* ------------------------------------------------------------------
 * HAL callback dispatch registry
 * Each SerialAdapter registers its UART handle and context pointer via
 * SerialAdapterRegisterHalCallbacks() during MainApplication_Init().
 * The three HAL weak-override callbacks below dispatch through this
 * table — no service headers are included in this file.
 * ------------------------------------------------------------------ */
#define SERIAL_REGISTRY_SIZE 4U

typedef struct
{
  UART_HandleTypeDef *huart; /* NULL = slot empty */
  SerialAdapterCtx_t *ctx;
} SerialCallbackEntry_t;

static SerialCallbackEntry_t s_registry[SERIAL_REGISTRY_SIZE];

void SerialAdapterRegisterHalCallbacks(UART_HandleTypeDef *huart,
                                       SerialAdapterCtx_t *ctx)
{
  uint8_t i;

  for (i = 0U; i < SERIAL_REGISTRY_SIZE; i++)
  {
    if (s_registry[i].huart == NULL)
    {
      s_registry[i].huart = huart;
      s_registry[i].ctx   = ctx;
      return;
    }
  }
  /* No free slot: increase SERIAL_REGISTRY_SIZE. */
}

static SerialAdapterCtx_t *RegistryLookup(UART_HandleTypeDef *huart)
{
  uint8_t i;

  for (i = 0U; i < SERIAL_REGISTRY_SIZE; i++)
  {
    if (s_registry[i].huart == huart)
    {
      return s_registry[i].ctx;
    }
  }
  return NULL;
}
/* USER CODE END 0 */

UART_HandleTypeDef huart4;
UART_HandleTypeDef huart5;
UART_HandleTypeDef huart8;
UART_HandleTypeDef huart2;
DMA_HandleTypeDef hdma_uart4_rx;
DMA_HandleTypeDef hdma_uart4_tx;
DMA_HandleTypeDef hdma_uart5_rx;
DMA_HandleTypeDef hdma_uart5_tx;
DMA_HandleTypeDef hdma_uart8_rx;
DMA_HandleTypeDef hdma_uart8_tx;
DMA_HandleTypeDef hdma_usart2_rx;
DMA_HandleTypeDef hdma_usart2_tx;

/* UART4 init function */
void MX_UART4_Init(void)
{

  huart4.Instance = UART4;
  huart4.Init.BaudRate = 115200;
  huart4.Init.WordLength = UART_WORDLENGTH_8B;
  huart4.Init.StopBits = UART_STOPBITS_1;
  huart4.Init.Parity = UART_PARITY_NONE;
  huart4.Init.Mode = UART_MODE_TX_RX;
  huart4.Init.HwFlowCtl = UART_HWCONTROL_NONE;
  huart4.Init.OverSampling = UART_OVERSAMPLING_16;
  huart4.Init.OneBitSampling = UART_ONE_BIT_SAMPLE_DISABLE;
  huart4.Init.ClockPrescaler = UART_PRESCALER_DIV1;
  huart4.AdvancedInit.AdvFeatureInit = UART_ADVFEATURE_NO_INIT;
  if (HAL_UART_Init(&huart4) != HAL_OK)
  {
    Error_Handler();
  }
  if (HAL_UARTEx_SetTxFifoThreshold(&huart4, UART_TXFIFO_THRESHOLD_1_8) != HAL_OK)
  {
    Error_Handler();
  }
  if (HAL_UARTEx_SetRxFifoThreshold(&huart4, UART_RXFIFO_THRESHOLD_1_8) != HAL_OK)
  {
    Error_Handler();
  }
  if (HAL_UARTEx_DisableFifoMode(&huart4) != HAL_OK)
  {
    Error_Handler();
  }
}
/* UART5 init function */
void MX_UART5_Init(void)
{

  huart5.Instance = UART5;
  huart5.Init.BaudRate = 115200;
  huart5.Init.WordLength = UART_WORDLENGTH_8B;
  huart5.Init.StopBits = UART_STOPBITS_1;
  huart5.Init.Parity = UART_PARITY_NONE;
  huart5.Init.Mode = UART_MODE_TX_RX;
  huart5.Init.HwFlowCtl = UART_HWCONTROL_NONE;
  huart5.Init.OverSampling = UART_OVERSAMPLING_16;
  huart5.Init.OneBitSampling = UART_ONE_BIT_SAMPLE_DISABLE;
  huart5.Init.ClockPrescaler = UART_PRESCALER_DIV1;
  huart5.AdvancedInit.AdvFeatureInit = UART_ADVFEATURE_NO_INIT;
  if (HAL_UART_Init(&huart5) != HAL_OK)
  {
    Error_Handler();
  }
  if (HAL_UARTEx_SetTxFifoThreshold(&huart5, UART_TXFIFO_THRESHOLD_1_8) != HAL_OK)
  {
    Error_Handler();
  }
  if (HAL_UARTEx_SetRxFifoThreshold(&huart5, UART_RXFIFO_THRESHOLD_1_8) != HAL_OK)
  {
    Error_Handler();
  }
  if (HAL_UARTEx_DisableFifoMode(&huart5) != HAL_OK)
  {
    Error_Handler();
  }
}
/* UART8 init function */
void MX_UART8_Init(void)
{

  huart8.Instance = UART8;
  huart8.Init.BaudRate = 115200;
  huart8.Init.WordLength = UART_WORDLENGTH_8B;
  huart8.Init.StopBits = UART_STOPBITS_1;
  huart8.Init.Parity = UART_PARITY_NONE;
  huart8.Init.Mode = UART_MODE_TX_RX;
  huart8.Init.HwFlowCtl = UART_HWCONTROL_NONE;
  huart8.Init.OverSampling = UART_OVERSAMPLING_16;
  huart8.Init.OneBitSampling = UART_ONE_BIT_SAMPLE_DISABLE;
  huart8.Init.ClockPrescaler = UART_PRESCALER_DIV1;
  huart8.AdvancedInit.AdvFeatureInit = UART_ADVFEATURE_NO_INIT;
  if (HAL_UART_Init(&huart8) != HAL_OK)
  {
    Error_Handler();
  }
  if (HAL_UARTEx_SetTxFifoThreshold(&huart8, UART_TXFIFO_THRESHOLD_1_8) != HAL_OK)
  {
    Error_Handler();
  }
  if (HAL_UARTEx_SetRxFifoThreshold(&huart8, UART_RXFIFO_THRESHOLD_1_8) != HAL_OK)
  {
    Error_Handler();
  }
  if (HAL_UARTEx_DisableFifoMode(&huart8) != HAL_OK)
  {
    Error_Handler();
  }
}
/* USART2 init function */

void MX_USART2_UART_Init(void)
{

  huart2.Instance = USART2;
  huart2.Init.BaudRate = 38400;
  huart2.Init.WordLength = UART_WORDLENGTH_8B;
  huart2.Init.StopBits = UART_STOPBITS_1;
  huart2.Init.Parity = UART_PARITY_NONE;
  huart2.Init.Mode = UART_MODE_TX_RX;
  huart2.Init.HwFlowCtl = UART_HWCONTROL_NONE;
  huart2.Init.OverSampling = UART_OVERSAMPLING_16;
  huart2.Init.OneBitSampling = UART_ONE_BIT_SAMPLE_DISABLE;
  huart2.Init.ClockPrescaler = UART_PRESCALER_DIV1;
  huart2.AdvancedInit.AdvFeatureInit = UART_ADVFEATURE_NO_INIT;
  if (HAL_UART_Init(&huart2) != HAL_OK)
  {
    Error_Handler();
  }
  if (HAL_UARTEx_SetTxFifoThreshold(&huart2, UART_TXFIFO_THRESHOLD_1_8) != HAL_OK)
  {
    Error_Handler();
  }
  if (HAL_UARTEx_SetRxFifoThreshold(&huart2, UART_RXFIFO_THRESHOLD_1_8) != HAL_OK)
  {
    Error_Handler();
  }
  if (HAL_UARTEx_DisableFifoMode(&huart2) != HAL_OK)
  {
    Error_Handler();
  }
}

void HAL_UART_MspInit(UART_HandleTypeDef* uartHandle)
{

  GPIO_InitTypeDef GPIO_InitStruct = {0};
  if(uartHandle->Instance==UART4)
  {
    /* UART4 clock enable */
    __HAL_RCC_UART4_CLK_ENABLE();

    __HAL_RCC_GPIOC_CLK_ENABLE();
    /**UART4 GPIO Configuration
    PC10     ------> UART4_TX
    PC11     ------> UART4_RX
    */
    GPIO_InitStruct.Pin = GPIO_PIN_10|GPIO_PIN_11;
    GPIO_InitStruct.Mode = GPIO_MODE_AF_PP;
    GPIO_InitStruct.Pull = GPIO_NOPULL;
    GPIO_InitStruct.Speed = GPIO_SPEED_FREQ_LOW;
    GPIO_InitStruct.Alternate = GPIO_AF8_UART4;
    HAL_GPIO_Init(GPIOC, &GPIO_InitStruct);

    /* UART4 DMA Init */
    /* UART4_RX Init */
    hdma_uart4_rx.Instance = DMA1_Stream0;
    hdma_uart4_rx.Init.Request = DMA_REQUEST_UART4_RX;
    hdma_uart4_rx.Init.Direction = DMA_PERIPH_TO_MEMORY;
    hdma_uart4_rx.Init.PeriphInc = DMA_PINC_DISABLE;
    hdma_uart4_rx.Init.MemInc = DMA_MINC_ENABLE;
    hdma_uart4_rx.Init.PeriphDataAlignment = DMA_PDATAALIGN_BYTE;
    hdma_uart4_rx.Init.MemDataAlignment = DMA_MDATAALIGN_BYTE;
    hdma_uart4_rx.Init.Mode = DMA_NORMAL;
    hdma_uart4_rx.Init.Priority = DMA_PRIORITY_HIGH;
    hdma_uart4_rx.Init.FIFOMode = DMA_FIFOMODE_DISABLE;
    if (HAL_DMA_Init(&hdma_uart4_rx) != HAL_OK)
    {
      Error_Handler();
    }

    __HAL_LINKDMA(uartHandle,hdmarx,hdma_uart4_rx);

    /* UART4_TX Init */
    hdma_uart4_tx.Instance = DMA1_Stream1;
    hdma_uart4_tx.Init.Request = DMA_REQUEST_UART4_TX;
    hdma_uart4_tx.Init.Direction = DMA_MEMORY_TO_PERIPH;
    hdma_uart4_tx.Init.PeriphInc = DMA_PINC_DISABLE;
    hdma_uart4_tx.Init.MemInc = DMA_MINC_ENABLE;
    hdma_uart4_tx.Init.PeriphDataAlignment = DMA_PDATAALIGN_BYTE;
    hdma_uart4_tx.Init.MemDataAlignment = DMA_MDATAALIGN_BYTE;
    hdma_uart4_tx.Init.Mode = DMA_NORMAL;
    hdma_uart4_tx.Init.Priority = DMA_PRIORITY_HIGH;
    hdma_uart4_tx.Init.FIFOMode = DMA_FIFOMODE_DISABLE;
    if (HAL_DMA_Init(&hdma_uart4_tx) != HAL_OK)
    {
      Error_Handler();
    }

    __HAL_LINKDMA(uartHandle,hdmatx,hdma_uart4_tx);

    /* UART4 interrupt Init */
    HAL_NVIC_SetPriority(UART4_IRQn, 5, 0);
    HAL_NVIC_EnableIRQ(UART4_IRQn);
  }
  else if(uartHandle->Instance==UART5)
  {
    /* UART5 clock enable */
    __HAL_RCC_UART5_CLK_ENABLE();

    __HAL_RCC_GPIOC_CLK_ENABLE();
    __HAL_RCC_GPIOD_CLK_ENABLE();
    /**UART5 GPIO Configuration
    PC12     ------> UART5_TX
    PD2     ------> UART5_RX
    */
    GPIO_InitStruct.Pin = GPIO_PIN_12;
    GPIO_InitStruct.Mode = GPIO_MODE_AF_PP;
    GPIO_InitStruct.Pull = GPIO_NOPULL;
    GPIO_InitStruct.Speed = GPIO_SPEED_FREQ_LOW;
    GPIO_InitStruct.Alternate = GPIO_AF8_UART5;
    HAL_GPIO_Init(GPIOC, &GPIO_InitStruct);

    GPIO_InitStruct.Pin = GPIO_PIN_2;
    GPIO_InitStruct.Mode = GPIO_MODE_AF_PP;
    GPIO_InitStruct.Pull = GPIO_NOPULL;
    GPIO_InitStruct.Speed = GPIO_SPEED_FREQ_LOW;
    GPIO_InitStruct.Alternate = GPIO_AF8_UART5;
    HAL_GPIO_Init(GPIOD, &GPIO_InitStruct);

    /* UART5 DMA Init */
    /* UART5_RX Init */
    hdma_uart5_rx.Instance = DMA1_Stream4;
    hdma_uart5_rx.Init.Request = DMA_REQUEST_UART5_RX;
    hdma_uart5_rx.Init.Direction = DMA_PERIPH_TO_MEMORY;
    hdma_uart5_rx.Init.PeriphInc = DMA_PINC_DISABLE;
    hdma_uart5_rx.Init.MemInc = DMA_MINC_ENABLE;
    hdma_uart5_rx.Init.PeriphDataAlignment = DMA_PDATAALIGN_BYTE;
    hdma_uart5_rx.Init.MemDataAlignment = DMA_MDATAALIGN_BYTE;
    hdma_uart5_rx.Init.Mode = DMA_NORMAL;
    hdma_uart5_rx.Init.Priority = DMA_PRIORITY_HIGH;
    hdma_uart5_rx.Init.FIFOMode = DMA_FIFOMODE_DISABLE;
    if (HAL_DMA_Init(&hdma_uart5_rx) != HAL_OK)
    {
      Error_Handler();
    }

    __HAL_LINKDMA(uartHandle,hdmarx,hdma_uart5_rx);

    /* UART5_TX Init */
    hdma_uart5_tx.Instance = DMA1_Stream5;
    hdma_uart5_tx.Init.Request = DMA_REQUEST_UART5_TX;
    hdma_uart5_tx.Init.Direction = DMA_MEMORY_TO_PERIPH;
    hdma_uart5_tx.Init.PeriphInc = DMA_PINC_DISABLE;
    hdma_uart5_tx.Init.MemInc = DMA_MINC_ENABLE;
    hdma_uart5_tx.Init.PeriphDataAlignment = DMA_PDATAALIGN_BYTE;
    hdma_uart5_tx.Init.MemDataAlignment = DMA_MDATAALIGN_BYTE;
    hdma_uart5_tx.Init.Mode = DMA_NORMAL;
    hdma_uart5_tx.Init.Priority = DMA_PRIORITY_HIGH;
    hdma_uart5_tx.Init.FIFOMode = DMA_FIFOMODE_DISABLE;
    if (HAL_DMA_Init(&hdma_uart5_tx) != HAL_OK)
    {
      Error_Handler();
    }

    __HAL_LINKDMA(uartHandle,hdmatx,hdma_uart5_tx);

    /* UART5 interrupt Init */
    HAL_NVIC_SetPriority(UART5_IRQn, 5, 0);
    HAL_NVIC_EnableIRQ(UART5_IRQn);
  }
  else if(uartHandle->Instance==UART8)
  {
    /* UART8 clock enable */
    __HAL_RCC_UART8_CLK_ENABLE();

    __HAL_RCC_GPIOE_CLK_ENABLE();
    /**UART8 GPIO Configuration
    PE0     ------> UART8_RX
    PE1     ------> UART8_TX
    */
    GPIO_InitStruct.Pin = GPIO_PIN_0|GPIO_PIN_1;
    GPIO_InitStruct.Mode = GPIO_MODE_AF_PP;
    GPIO_InitStruct.Pull = GPIO_NOPULL;
    GPIO_InitStruct.Speed = GPIO_SPEED_FREQ_LOW;
    GPIO_InitStruct.Alternate = GPIO_AF8_UART8;
    HAL_GPIO_Init(GPIOE, &GPIO_InitStruct);

    /* UART8 DMA Init */
    /* UART8_RX Init */
    hdma_uart8_rx.Instance = DMA1_Stream6;
    hdma_uart8_rx.Init.Request = DMA_REQUEST_UART8_RX;
    hdma_uart8_rx.Init.Direction = DMA_PERIPH_TO_MEMORY;
    hdma_uart8_rx.Init.PeriphInc = DMA_PINC_DISABLE;
    hdma_uart8_rx.Init.MemInc = DMA_MINC_ENABLE;
    hdma_uart8_rx.Init.PeriphDataAlignment = DMA_PDATAALIGN_BYTE;
    hdma_uart8_rx.Init.MemDataAlignment = DMA_MDATAALIGN_BYTE;
    hdma_uart8_rx.Init.Mode = DMA_NORMAL;
    hdma_uart8_rx.Init.Priority = DMA_PRIORITY_HIGH;
    hdma_uart8_rx.Init.FIFOMode = DMA_FIFOMODE_DISABLE;
    if (HAL_DMA_Init(&hdma_uart8_rx) != HAL_OK)
    {
      Error_Handler();
    }

    __HAL_LINKDMA(uartHandle,hdmarx,hdma_uart8_rx);

    /* UART8_TX Init */
    hdma_uart8_tx.Instance = DMA1_Stream7;
    hdma_uart8_tx.Init.Request = DMA_REQUEST_UART8_TX;
    hdma_uart8_tx.Init.Direction = DMA_MEMORY_TO_PERIPH;
    hdma_uart8_tx.Init.PeriphInc = DMA_PINC_DISABLE;
    hdma_uart8_tx.Init.MemInc = DMA_MINC_ENABLE;
    hdma_uart8_tx.Init.PeriphDataAlignment = DMA_PDATAALIGN_BYTE;
    hdma_uart8_tx.Init.MemDataAlignment = DMA_MDATAALIGN_BYTE;
    hdma_uart8_tx.Init.Mode = DMA_NORMAL;
    hdma_uart8_tx.Init.Priority = DMA_PRIORITY_HIGH;
    hdma_uart8_tx.Init.FIFOMode = DMA_FIFOMODE_DISABLE;
    if (HAL_DMA_Init(&hdma_uart8_tx) != HAL_OK)
    {
      Error_Handler();
    }

    __HAL_LINKDMA(uartHandle,hdmatx,hdma_uart8_tx);

    /* UART8 interrupt Init */
    HAL_NVIC_SetPriority(UART8_IRQn, 5, 0);
    HAL_NVIC_EnableIRQ(UART8_IRQn);
  }
  else if(uartHandle->Instance==USART2)
  {
    /* USART2 clock enable */
    __HAL_RCC_USART2_CLK_ENABLE();

    __HAL_RCC_GPIOD_CLK_ENABLE();
    /**USART2 GPIO Configuration
    PD5     ------> USART2_TX
    PD6     ------> USART2_RX
    */
    GPIO_InitStruct.Pin = GPIO_PIN_5|GPIO_PIN_6;
    GPIO_InitStruct.Mode = GPIO_MODE_AF_PP;
    GPIO_InitStruct.Pull = GPIO_NOPULL;
    GPIO_InitStruct.Speed = GPIO_SPEED_FREQ_LOW;
    GPIO_InitStruct.Alternate = GPIO_AF7_USART2;
    HAL_GPIO_Init(GPIOD, &GPIO_InitStruct);

    /* USART2 DMA Init */
    /* USART2_RX Init */
    hdma_usart2_rx.Instance = DMA1_Stream2;
    hdma_usart2_rx.Init.Request = DMA_REQUEST_USART2_RX;
    hdma_usart2_rx.Init.Direction = DMA_PERIPH_TO_MEMORY;
    hdma_usart2_rx.Init.PeriphInc = DMA_PINC_DISABLE;
    hdma_usart2_rx.Init.MemInc = DMA_MINC_ENABLE;
    hdma_usart2_rx.Init.PeriphDataAlignment = DMA_PDATAALIGN_BYTE;
    hdma_usart2_rx.Init.MemDataAlignment = DMA_MDATAALIGN_BYTE;
    hdma_usart2_rx.Init.Mode = DMA_NORMAL;
    hdma_usart2_rx.Init.Priority = DMA_PRIORITY_HIGH;
    hdma_usart2_rx.Init.FIFOMode = DMA_FIFOMODE_DISABLE;
    if (HAL_DMA_Init(&hdma_usart2_rx) != HAL_OK)
    {
      Error_Handler();
    }

    __HAL_LINKDMA(uartHandle,hdmarx,hdma_usart2_rx);

    /* USART2_TX Init */
    hdma_usart2_tx.Instance = DMA1_Stream3;
    hdma_usart2_tx.Init.Request = DMA_REQUEST_USART2_TX;
    hdma_usart2_tx.Init.Direction = DMA_MEMORY_TO_PERIPH;
    hdma_usart2_tx.Init.PeriphInc = DMA_PINC_DISABLE;
    hdma_usart2_tx.Init.MemInc = DMA_MINC_ENABLE;
    hdma_usart2_tx.Init.PeriphDataAlignment = DMA_PDATAALIGN_BYTE;
    hdma_usart2_tx.Init.MemDataAlignment = DMA_MDATAALIGN_BYTE;
    hdma_usart2_tx.Init.Mode = DMA_NORMAL;
    hdma_usart2_tx.Init.Priority = DMA_PRIORITY_HIGH;
    hdma_usart2_tx.Init.FIFOMode = DMA_FIFOMODE_DISABLE;
    if (HAL_DMA_Init(&hdma_usart2_tx) != HAL_OK)
    {
      Error_Handler();
    }

    __HAL_LINKDMA(uartHandle,hdmatx,hdma_usart2_tx);

    /* USART2 interrupt Init */
    HAL_NVIC_SetPriority(USART2_IRQn, 5, 0);
    HAL_NVIC_EnableIRQ(USART2_IRQn);
  }
}

void HAL_UART_MspDeInit(UART_HandleTypeDef* uartHandle)
{

  if(uartHandle->Instance==UART4)
  {
    /* Peripheral clock disable */
    __HAL_RCC_UART4_CLK_DISABLE();

    /**UART4 GPIO Configuration
    PC10     ------> UART4_TX
    PC11     ------> UART4_RX
    */
    HAL_GPIO_DeInit(GPIOC, GPIO_PIN_10|GPIO_PIN_11);

    /* UART4 DMA DeInit */
    HAL_DMA_DeInit(uartHandle->hdmarx);
    HAL_DMA_DeInit(uartHandle->hdmatx);

    /* UART4 interrupt Deinit */
    HAL_NVIC_DisableIRQ(UART4_IRQn);
  }
  else if(uartHandle->Instance==UART5)
  {
    /* Peripheral clock disable */
    __HAL_RCC_UART5_CLK_DISABLE();

    /**UART5 GPIO Configuration
    PC12     ------> UART5_TX
    PD2     ------> UART5_RX
    */
    HAL_GPIO_DeInit(GPIOC, GPIO_PIN_12);

    HAL_GPIO_DeInit(GPIOD, GPIO_PIN_2);

    /* UART5 DMA DeInit */
    HAL_DMA_DeInit(uartHandle->hdmarx);
    HAL_DMA_DeInit(uartHandle->hdmatx);

    /* UART5 interrupt Deinit */
    HAL_NVIC_DisableIRQ(UART5_IRQn);
  }
  else if(uartHandle->Instance==UART8)
  {
    /* Peripheral clock disable */
    __HAL_RCC_UART8_CLK_DISABLE();

    /**UART8 GPIO Configuration
    PE0     ------> UART8_RX
    PE1     ------> UART8_TX
    */
    HAL_GPIO_DeInit(GPIOE, GPIO_PIN_0|GPIO_PIN_1);

    /* UART8 DMA DeInit */
    HAL_DMA_DeInit(uartHandle->hdmarx);
    HAL_DMA_DeInit(uartHandle->hdmatx);

    /* UART8 interrupt Deinit */
    HAL_NVIC_DisableIRQ(UART8_IRQn);
  }
  else if(uartHandle->Instance==USART2)
  {
    /* Peripheral clock disable */
    __HAL_RCC_USART2_CLK_DISABLE();

    /**USART2 GPIO Configuration
    PD5     ------> USART2_TX
    PD6     ------> USART2_RX
    */
    HAL_GPIO_DeInit(GPIOD, GPIO_PIN_5|GPIO_PIN_6);

    /* USART2 DMA DeInit */
    HAL_DMA_DeInit(uartHandle->hdmarx);
    HAL_DMA_DeInit(uartHandle->hdmatx);

    /* USART2 interrupt Deinit */
    HAL_NVIC_DisableIRQ(USART2_IRQn);
  }
}

/* USER CODE BEGIN 1 */
void UART4Init(uint32_t lBaudRate)
{
  huart4.Instance = UART4;
  huart4.Init.BaudRate = lBaudRate;
  huart4.Init.WordLength = UART_WORDLENGTH_8B;
  huart4.Init.StopBits = UART_STOPBITS_1;
  huart4.Init.Parity = UART_PARITY_NONE;
  huart4.Init.Mode = UART_MODE_TX_RX;
  huart4.Init.HwFlowCtl = UART_HWCONTROL_NONE;
  huart4.Init.OverSampling = UART_OVERSAMPLING_16;
  huart4.Init.OneBitSampling = UART_ONE_BIT_SAMPLE_DISABLE;
  huart4.Init.ClockPrescaler = UART_PRESCALER_DIV1;
  huart4.AdvancedInit.AdvFeatureInit = UART_ADVFEATURE_NO_INIT;
  if (HAL_UART_Init(&huart4) != HAL_OK)
  {
    Error_Handler();
  }

  if (HAL_UARTEx_SetTxFifoThreshold(&huart4,
                                    UART_TXFIFO_THRESHOLD_1_8) != HAL_OK)
  {
    Error_Handler();
  }

  if (HAL_UARTEx_SetRxFifoThreshold(&huart4,
                                    UART_RXFIFO_THRESHOLD_1_8) != HAL_OK)
  {
    Error_Handler();
  }

  if (HAL_UARTEx_DisableFifoMode(&huart4) != HAL_OK)
  {
    Error_Handler();
  }

} /* UART4Init */

void UART8Init(uint32_t lBaudRate)
{
  huart8.Instance = UART8;
  huart8.Init.BaudRate = lBaudRate;
  huart8.Init.WordLength = UART_WORDLENGTH_8B;
  huart8.Init.StopBits = UART_STOPBITS_1;
  huart8.Init.Parity = UART_PARITY_NONE;
  huart8.Init.Mode = UART_MODE_TX_RX;
  huart8.Init.HwFlowCtl = UART_HWCONTROL_NONE;
  huart8.Init.OverSampling = UART_OVERSAMPLING_16;
  huart8.Init.OneBitSampling = UART_ONE_BIT_SAMPLE_DISABLE;
  huart8.Init.ClockPrescaler = UART_PRESCALER_DIV1;
  huart8.AdvancedInit.AdvFeatureInit = UART_ADVFEATURE_NO_INIT;
  if (HAL_UART_Init(&huart8) != HAL_OK)
  {
    Error_Handler();
  }

  if (HAL_UARTEx_SetTxFifoThreshold(&huart8,
                                    UART_TXFIFO_THRESHOLD_1_8) != HAL_OK)
  {
    Error_Handler();
  }

  if (HAL_UARTEx_SetRxFifoThreshold(&huart8,
                                    UART_RXFIFO_THRESHOLD_1_8) != HAL_OK)
  {
    Error_Handler();
  }

  if (HAL_UARTEx_DisableFifoMode(&huart8) != HAL_OK)
  {
    Error_Handler();
  }

} /* UART8Init */

void USART2Init(uint32_t lBaudRate)
{
  huart2.Instance = USART2;
  huart2.Init.BaudRate = lBaudRate;
  huart2.Init.WordLength = UART_WORDLENGTH_8B;
  huart2.Init.StopBits = UART_STOPBITS_1;
  huart2.Init.Parity = UART_PARITY_NONE;
  huart2.Init.Mode = UART_MODE_TX_RX;
  huart2.Init.HwFlowCtl = UART_HWCONTROL_NONE;
  huart2.Init.OverSampling = UART_OVERSAMPLING_16;
  huart2.Init.OneBitSampling = UART_ONE_BIT_SAMPLE_DISABLE;
  huart2.Init.ClockPrescaler = UART_PRESCALER_DIV1;
  huart2.AdvancedInit.AdvFeatureInit = UART_ADVFEATURE_NO_INIT;
  if (HAL_UART_Init(&huart2) != HAL_OK)
  {
    Error_Handler();
  }

  if (HAL_UARTEx_SetTxFifoThreshold(&huart2,
                                    UART_TXFIFO_THRESHOLD_1_8) != HAL_OK)
  {
    Error_Handler();
  }

  if (HAL_UARTEx_SetRxFifoThreshold(&huart2,
                                    UART_RXFIFO_THRESHOLD_1_8) != HAL_OK)
  {
    Error_Handler();
  }

  if (HAL_UARTEx_DisableFifoMode(&huart2) != HAL_OK)
  {
    Error_Handler();
  }

} /* USART2Init */

void HAL_UART_ErrorCallback(UART_HandleTypeDef *huart)
{
  SerialAdapterCtx_t *ctx = RegistryLookup(huart);

  if (ctx != NULL)
  {
    SerialAdapterOnError(ctx);
  }
}

void HAL_UARTEx_RxEventCallback(UART_HandleTypeDef *huart, uint16_t Size)
{
  SerialAdapterCtx_t *ctx = RegistryLookup(huart);

  if (ctx != NULL)
  {
    SerialAdapterOnRxEvent(ctx, Size);
  }
}

void HAL_UART_TxCpltCallback(UART_HandleTypeDef *huart)
{
  SerialAdapterCtx_t *ctx = RegistryLookup(huart);

  if (ctx != NULL)
  {
    SerialAdapterOnTxCplt(ctx);
  }
}

void UARTDeInit(UART_HandleTypeDef *huart)
{
  HAL_UART_DeInit(huart);
}

/* USER CODE END 1 */
