mehdinuri/CPU4v1/CPM/CP/Core/Src/gpio.c

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

/* Includes ------------------------------------------------------------------*/
#include "gpio.h"

/*----------------------------------------------------------------------------*/
/* Configure GPIO                                                             */
/*----------------------------------------------------------------------------*/
/** Configure pins
     PC14-OSC32_IN (OSC32_IN)   ------> RCC_OSC32_IN
     PC15-OSC32_OUT (OSC32_OUT)   ------> RCC_OSC32_OUT
     PH0-OSC_IN (PH0)   ------> RCC_OSC_IN
     PH1-OSC_OUT (PH1)   ------> RCC_OSC_OUT
     PA8   ------> RCC_MCO_1
     PA13 (JTMS/SWDIO)   ------> DEBUG_JTMS-SWDIO
     PA14 (JTCK/SWCLK)   ------> DEBUG_JTCK-SWCLK
     PA15 (JTDI)   ------> DEBUG_JTDI
     PB3 (JTDO/TRACESWO)   ------> DEBUG_JTDO-SWO
     PB4 (NJTRST)   ------> DEBUG_JTRST
*/
void MX_GPIO_Init(void)
{

  GPIO_InitTypeDef GPIO_InitStruct = {0};

  /* GPIO Ports Clock Enable */
  __HAL_RCC_GPIOE_CLK_ENABLE();
  __HAL_RCC_GPIOC_CLK_ENABLE();
  __HAL_RCC_GPIOH_CLK_ENABLE();
  __HAL_RCC_GPIOA_CLK_ENABLE();
  __HAL_RCC_GPIOB_CLK_ENABLE();
  __HAL_RCC_GPIOD_CLK_ENABLE();

  /*Configure GPIO pin Output Level */
  HAL_GPIO_WritePin(GPIOE, ESP_EN_Pin|DIMMING_Pin|HEAT_Pin|KEYPAD_ROW4_Pin
                          |LCD_CS1B_Pin|LCD_E2_Pin|LCD_WRITE_Pin|LCD_E1_Pin, GPIO_PIN_RESET);

  /*Configure GPIO pin Output Level */
  HAL_GPIO_WritePin(GPS_RESET_GPIO_Port, GPS_RESET_Pin, GPIO_PIN_SET);

  /*Configure GPIO pin Output Level */
  HAL_GPIO_WritePin(GPIOC, CHARGER_SD_Pin|LCD_D3_Pin|LCD_D2_Pin|LCD_D1_Pin
                          |LCD_D0_Pin, GPIO_PIN_RESET);

  /*Configure GPIO pin Output Level */
  HAL_GPIO_WritePin(GPIOA, GPRS_PWR_EN_Pin|COM_LED_Pin|KEYPAD_ROW5_Pin, GPIO_PIN_RESET);

  /*Configure GPIO pin Output Level */
  HAL_GPIO_WritePin(RELAY_GPIO_Port, RELAY_Pin, GPIO_PIN_SET);

  /*Configure GPIO pin Output Level */
  HAL_GPIO_WritePin(GPIOB, KEYPAD_ROW1_Pin|KEYPAD_ROW2_Pin|KEYPAD_ROW3_Pin|LCD_RESET_Pin, GPIO_PIN_RESET);

  /*Configure GPIO pin Output Level */
  HAL_GPIO_WritePin(EEPROM_WP_GPIO_Port, EEPROM_WP_Pin, GPIO_PIN_SET);

  /*Configure GPIO pin Output Level */
  HAL_GPIO_WritePin(GPIOD, LCD_PWR_Pin|LCD_D7_Pin|LCD_D6_Pin|LCD_D5_Pin
                          |LCD_D4_Pin, GPIO_PIN_RESET);

  /*Configure GPIO pins : ESP_EN_Pin GPS_RESET_Pin DIMMING_Pin HEAT_Pin
                           KEYPAD_ROW4_Pin LCD_CS1B_Pin LCD_E2_Pin LCD_WRITE_Pin
                           LCD_E1_Pin */
  GPIO_InitStruct.Pin = ESP_EN_Pin|GPS_RESET_Pin|DIMMING_Pin|HEAT_Pin
                          |KEYPAD_ROW4_Pin|LCD_CS1B_Pin|LCD_E2_Pin|LCD_WRITE_Pin
                          |LCD_E1_Pin;
  GPIO_InitStruct.Mode = GPIO_MODE_OUTPUT_PP;
  GPIO_InitStruct.Pull = GPIO_NOPULL;
  GPIO_InitStruct.Speed = GPIO_SPEED_FREQ_LOW;
  HAL_GPIO_Init(GPIOE, &GPIO_InitStruct);

  /*Configure GPIO pin : PE4 */
  GPIO_InitStruct.Pin = GPIO_PIN_4;
  GPIO_InitStruct.Mode = GPIO_MODE_ANALOG;
  GPIO_InitStruct.Pull = GPIO_NOPULL;
  HAL_GPIO_Init(GPIOE, &GPIO_InitStruct);

  /*Configure GPIO pins : PC13 PC0 */
  GPIO_InitStruct.Pin = GPIO_PIN_13|GPIO_PIN_0;
  GPIO_InitStruct.Mode = GPIO_MODE_ANALOG;
  GPIO_InitStruct.Pull = GPIO_NOPULL;
  HAL_GPIO_Init(GPIOC, &GPIO_InitStruct);

  /*Configure GPIO pin : DOOR_Pin */
  GPIO_InitStruct.Pin = DOOR_Pin;
  GPIO_InitStruct.Mode = GPIO_MODE_INPUT;
  GPIO_InitStruct.Pull = GPIO_NOPULL;
  HAL_GPIO_Init(DOOR_GPIO_Port, &GPIO_InitStruct);

  /*Configure GPIO pins : CHARGER_SD_Pin LCD_D3_Pin LCD_D2_Pin LCD_D1_Pin
                           LCD_D0_Pin */
  GPIO_InitStruct.Pin = CHARGER_SD_Pin|LCD_D3_Pin|LCD_D2_Pin|LCD_D1_Pin
                          |LCD_D0_Pin;
  GPIO_InitStruct.Mode = GPIO_MODE_OUTPUT_PP;
  GPIO_InitStruct.Pull = GPIO_NOPULL;
  GPIO_InitStruct.Speed = GPIO_SPEED_FREQ_LOW;
  HAL_GPIO_Init(GPIOC, &GPIO_InitStruct);

  /*Configure GPIO pins : GPRS_PWR_EN_Pin RELAY_Pin COM_LED_Pin KEYPAD_ROW5_Pin */
  GPIO_InitStruct.Pin = GPRS_PWR_EN_Pin|RELAY_Pin|COM_LED_Pin|KEYPAD_ROW5_Pin;
  GPIO_InitStruct.Mode = GPIO_MODE_OUTPUT_PP;
  GPIO_InitStruct.Pull = GPIO_NOPULL;
  GPIO_InitStruct.Speed = GPIO_SPEED_FREQ_LOW;
  HAL_GPIO_Init(GPIOA, &GPIO_InitStruct);

  /*Configure GPIO pins : KEYPAD_ROW1_Pin KEYPAD_ROW2_Pin KEYPAD_ROW3_Pin LCD_RESET_Pin */
  GPIO_InitStruct.Pin = KEYPAD_ROW1_Pin|KEYPAD_ROW2_Pin|KEYPAD_ROW3_Pin|LCD_RESET_Pin;
  GPIO_InitStruct.Mode = GPIO_MODE_OUTPUT_PP;
  GPIO_InitStruct.Pull = GPIO_NOPULL;
  GPIO_InitStruct.Speed = GPIO_SPEED_FREQ_LOW;
  HAL_GPIO_Init(GPIOB, &GPIO_InitStruct);

  /*Configure GPIO pins : KEYPAD_COL1_Pin KEYPAD_COL2_Pin KEYPAD_COL3_Pin KEYPAD_COL4_Pin */
  GPIO_InitStruct.Pin = KEYPAD_COL1_Pin|KEYPAD_COL2_Pin|KEYPAD_COL3_Pin|KEYPAD_COL4_Pin;
  GPIO_InitStruct.Mode = GPIO_MODE_INPUT;
  GPIO_InitStruct.Pull = GPIO_NOPULL;
  HAL_GPIO_Init(GPIOE, &GPIO_InitStruct);

  /*Configure GPIO pins : PB14 PB15 PB9 */
  GPIO_InitStruct.Pin = GPIO_PIN_14|GPIO_PIN_15|GPIO_PIN_9;
  GPIO_InitStruct.Mode = GPIO_MODE_ANALOG;
  GPIO_InitStruct.Pull = GPIO_NOPULL;
  HAL_GPIO_Init(GPIOB, &GPIO_InitStruct);

  /*Configure GPIO pin : EEPROM_WP_Pin */
  GPIO_InitStruct.Pin = EEPROM_WP_Pin;
  GPIO_InitStruct.Mode = GPIO_MODE_OUTPUT_OD;
  GPIO_InitStruct.Pull = GPIO_NOPULL;
  GPIO_InitStruct.Speed = GPIO_SPEED_FREQ_LOW;
  HAL_GPIO_Init(EEPROM_WP_GPIO_Port, &GPIO_InitStruct);

  /*Configure GPIO pins : LCD_PWR_Pin LCD_D7_Pin LCD_D6_Pin LCD_D5_Pin
                           LCD_D4_Pin */
  GPIO_InitStruct.Pin = LCD_PWR_Pin|LCD_D7_Pin|LCD_D6_Pin|LCD_D5_Pin
                          |LCD_D4_Pin;
  GPIO_InitStruct.Mode = GPIO_MODE_OUTPUT_PP;
  GPIO_InitStruct.Pull = GPIO_NOPULL;
  GPIO_InitStruct.Speed = GPIO_SPEED_FREQ_LOW;
  HAL_GPIO_Init(GPIOD, &GPIO_InitStruct);

  /*Configure GPIO pin : MCO_Pin */
  GPIO_InitStruct.Pin = MCO_Pin;
  GPIO_InitStruct.Mode = GPIO_MODE_AF_PP;
  GPIO_InitStruct.Pull = GPIO_NOPULL;
  GPIO_InitStruct.Speed = GPIO_SPEED_FREQ_VERY_HIGH;
  GPIO_InitStruct.Alternate = GPIO_AF0_MCO;
  HAL_GPIO_Init(MCO_GPIO_Port, &GPIO_InitStruct);

  /*Configure GPIO pin : PA10 */
  GPIO_InitStruct.Pin = GPIO_PIN_10;
  GPIO_InitStruct.Mode = GPIO_MODE_ANALOG;
  GPIO_InitStruct.Pull = GPIO_NOPULL;
  HAL_GPIO_Init(GPIOA, &GPIO_InitStruct);

  /*Configure GPIO pins : PD3 PD4 PD7 */
  GPIO_InitStruct.Pin = GPIO_PIN_3|GPIO_PIN_4|GPIO_PIN_7;
  GPIO_InitStruct.Mode = GPIO_MODE_ANALOG;
  GPIO_InitStruct.Pull = GPIO_NOPULL;
  HAL_GPIO_Init(GPIOD, &GPIO_InitStruct);

  /*AnalogSwitch Config */
  HAL_SYSCFG_AnalogSwitchConfig(SYSCFG_SWITCH_PC3, SYSCFG_SWITCH_PC3_CLOSE);

}

/* USER CODE BEGIN 2 */
void GPIODeInit(void)
{
  GPIO_InitTypeDef GPIO_InitStruct = { 0 };

  GPIO_InitStruct.Pin  = GPIO_PIN_All;
  GPIO_InitStruct.Mode = GPIO_MODE_ANALOG;
  GPIO_InitStruct.Pull = GPIO_NOPULL;

  HAL_GPIO_Init(GPIOA, &GPIO_InitStruct);
  HAL_GPIO_Init(GPIOB, &GPIO_InitStruct);
  HAL_GPIO_Init(GPIOC, &GPIO_InitStruct);
  HAL_GPIO_Init(GPIOD, &GPIO_InitStruct);
  HAL_GPIO_Init(GPIOE, &GPIO_InitStruct);

  HAL_GPIO_DeInit(GPIOA, GPIO_PIN_All);
  HAL_GPIO_DeInit(GPIOB, GPIO_PIN_All);
  HAL_GPIO_DeInit(GPIOC, GPIO_PIN_All);
  HAL_GPIO_DeInit(GPIOD, GPIO_PIN_All);
  HAL_GPIO_DeInit(GPIOE, GPIO_PIN_All);

  __HAL_RCC_GPIOA_CLK_DISABLE();
  __HAL_RCC_GPIOB_CLK_DISABLE();
  __HAL_RCC_GPIOC_CLK_DISABLE();
  __HAL_RCC_GPIOD_CLK_DISABLE();
  __HAL_RCC_GPIOE_CLK_DISABLE();
}

/* Platform-internal GPIO helpers (no domain port yet).
 * GPRS power  — used by MCS.c until ModemAdapter is implemented.
 * Charger SD  — used by data.c until PowerManagementAdapter is implemented. */

void GPIOChargerShutdownEnable(void)
{
  HAL_GPIO_WritePin(CHARGER_SD_GPIO_Port, CHARGER_SD_Pin, GPIO_PIN_RESET);
}

void GPIOChargerShutdownDisable(void)
{
  HAL_GPIO_WritePin(CHARGER_SD_GPIO_Port, CHARGER_SD_Pin, GPIO_PIN_SET);
}

void GPIOGPRSPowerEnable(void)
{
  HAL_GPIO_WritePin(GPRS_PWR_EN_GPIO_Port, GPRS_PWR_EN_Pin, GPIO_PIN_RESET);
}

void GPIOGPRSPowerDisable(void)
{
  HAL_GPIO_WritePin(GPRS_PWR_EN_GPIO_Port, GPRS_PWR_EN_Pin, GPIO_PIN_SET);
}

/* USER CODE END 2 */
