mehdinuri/CPU4v1/SSM/Core/Src/gpio.c

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

/* Includes ------------------------------------------------------------------*/
#include "gpio.h"

/*----------------------------------------------------------------------------*/
/* Configure GPIO                                                             */
/*----------------------------------------------------------------------------*/
/** Configure pins as
        * Analog
        * Input
        * Output
        * EVENT_OUT
        * EXTI
        * Free pins are configured automatically as Analog (this feature is enabled through
        * the Code Generation settings)
*/
void MX_GPIO_Init(void)
{

  GPIO_InitTypeDef GPIO_InitStruct = {0};

  /* GPIO Ports Clock Enable */
  __HAL_RCC_GPIOC_CLK_ENABLE();
  __HAL_RCC_GPIOF_CLK_ENABLE();
  __HAL_RCC_GPIOG_CLK_ENABLE();
  __HAL_RCC_GPIOA_CLK_ENABLE();
  __HAL_RCC_GPIOB_CLK_ENABLE();
  __HAL_RCC_GPIOD_CLK_ENABLE();

  /*Configure GPIO pin Output Level */
  HAL_GPIO_WritePin(GPIOC, R2_Pin|Y2_Pin|G2_Pin|G4_Pin
                          |Y4_Pin|R4_Pin|R3_Pin, GPIO_PIN_RESET);

  /*Configure GPIO pin Output Level */
  HAL_GPIO_WritePin(GPIOA, Y3_Pin|G3_Pin, GPIO_PIN_RESET);

  /*Configure GPIO pin Output Level */
  HAL_GPIO_WritePin(GPIOB, COM_LED_Pin|R1_Pin|Y1_Pin|G1_Pin, GPIO_PIN_RESET);

  /*Configure GPIO pins : R2_Pin Y2_Pin G2_Pin G4_Pin
                           Y4_Pin R4_Pin R3_Pin */
  GPIO_InitStruct.Pin = R2_Pin|Y2_Pin|G2_Pin|G4_Pin
                          |Y4_Pin|R4_Pin|R3_Pin;
  GPIO_InitStruct.Mode = GPIO_MODE_OUTPUT_PP;
  GPIO_InitStruct.Pull = GPIO_NOPULL;
  GPIO_InitStruct.Speed = GPIO_SPEED_FREQ_LOW;
  HAL_GPIO_Init(GPIOC, &GPIO_InitStruct);

  /*Configure GPIO pin : PG10 */
  GPIO_InitStruct.Pin = GPIO_PIN_10;
  GPIO_InitStruct.Mode = GPIO_MODE_ANALOG;
  GPIO_InitStruct.Pull = GPIO_NOPULL;
  HAL_GPIO_Init(GPIOG, &GPIO_InitStruct);

  /*Configure GPIO pins : Y3_Pin G3_Pin */
  GPIO_InitStruct.Pin = Y3_Pin|G3_Pin;
  GPIO_InitStruct.Mode = GPIO_MODE_OUTPUT_PP;
  GPIO_InitStruct.Pull = GPIO_NOPULL;
  GPIO_InitStruct.Speed = GPIO_SPEED_FREQ_LOW;
  HAL_GPIO_Init(GPIOA, &GPIO_InitStruct);

  /*Configure GPIO pins : PA6 PA7 */
  GPIO_InitStruct.Pin = GPIO_PIN_6|GPIO_PIN_7;
  GPIO_InitStruct.Mode = GPIO_MODE_ANALOG;
  GPIO_InitStruct.Pull = GPIO_NOPULL;
  HAL_GPIO_Init(GPIOA, &GPIO_InitStruct);

  /*Configure GPIO pin : PB2 */
  GPIO_InitStruct.Pin = GPIO_PIN_2;
  GPIO_InitStruct.Mode = GPIO_MODE_ANALOG;
  GPIO_InitStruct.Pull = GPIO_NOPULL;
  HAL_GPIO_Init(GPIOB, &GPIO_InitStruct);

  /*Configure GPIO pins : G3_V_Pin G4_V_Pin G2_V_Pin G1_V_Pin
                           Y3_V_Pin */
  GPIO_InitStruct.Pin = G3_V_Pin|G4_V_Pin|G2_V_Pin|G1_V_Pin
                          |Y3_V_Pin;
  GPIO_InitStruct.Mode = GPIO_MODE_INPUT;
  GPIO_InitStruct.Pull = GPIO_PULLUP;
  HAL_GPIO_Init(GPIOB, &GPIO_InitStruct);

  /*Configure GPIO pins : Y4_V_Pin Y2_V_Pin Y1_V_Pin R3_V_Pin */
  GPIO_InitStruct.Pin = Y4_V_Pin|Y2_V_Pin|Y1_V_Pin|R3_V_Pin;
  GPIO_InitStruct.Mode = GPIO_MODE_INPUT;
  GPIO_InitStruct.Pull = GPIO_PULLUP;
  HAL_GPIO_Init(GPIOC, &GPIO_InitStruct);

  /*Configure GPIO pins : R4_V_Pin R2_V_Pin R1_V_Pin */
  GPIO_InitStruct.Pin = R4_V_Pin|R2_V_Pin|R1_V_Pin;
  GPIO_InitStruct.Mode = GPIO_MODE_INPUT;
  GPIO_InitStruct.Pull = GPIO_PULLUP;
  HAL_GPIO_Init(GPIOA, &GPIO_InitStruct);

  /*Configure GPIO pins : ID0_Pin ID1_Pin ID2_Pin */
  GPIO_InitStruct.Pin = ID0_Pin|ID1_Pin|ID2_Pin;
  GPIO_InitStruct.Mode = GPIO_MODE_INPUT;
  GPIO_InitStruct.Pull = GPIO_NOPULL;
  HAL_GPIO_Init(GPIOC, &GPIO_InitStruct);

  /*Configure GPIO pin : ID3_Pin */
  GPIO_InitStruct.Pin = ID3_Pin;
  GPIO_InitStruct.Mode = GPIO_MODE_INPUT;
  GPIO_InitStruct.Pull = GPIO_NOPULL;
  HAL_GPIO_Init(ID3_GPIO_Port, &GPIO_InitStruct);

  /*Configure GPIO pins : COM_LED_Pin R1_Pin Y1_Pin G1_Pin */
  GPIO_InitStruct.Pin = COM_LED_Pin|R1_Pin|Y1_Pin|G1_Pin;
  GPIO_InitStruct.Mode = GPIO_MODE_OUTPUT_PP;
  GPIO_InitStruct.Pull = GPIO_NOPULL;
  GPIO_InitStruct.Speed = GPIO_SPEED_FREQ_LOW;
  HAL_GPIO_Init(GPIOB, &GPIO_InitStruct);

}

/* USER CODE BEGIN 2 */
void GPIODeInit(void)
{
	GPIO_InitTypeDef GPIO_InitStruct = {0};
	
	GPIO_InitStruct.Pin = GPIO_PIN_All;
  GPIO_InitStruct.Mode = GPIO_MODE_ANALOG;
  GPIO_InitStruct.Pull = GPIO_NOPULL;
  GPIO_InitStruct.Speed = GPIO_SPEED_FREQ_LOW;
  
	HAL_GPIO_Init(GPIOA, &GPIO_InitStruct);
	HAL_GPIO_Init(GPIOB, &GPIO_InitStruct);
	HAL_GPIO_Init(GPIOC, &GPIO_InitStruct);
	HAL_GPIO_Init(GPIOD, &GPIO_InitStruct);
	HAL_GPIO_Init(GPIOG, &GPIO_InitStruct);
	
	__HAL_RCC_GPIOC_CLK_DISABLE();
  __HAL_RCC_GPIOF_CLK_DISABLE();
  __HAL_RCC_GPIOG_CLK_DISABLE();
  __HAL_RCC_GPIOA_CLK_DISABLE();
  __HAL_RCC_GPIOB_CLK_DISABLE();
  __HAL_RCC_GPIOD_CLK_DISABLE();
}

uint8_t GPIOGetCardID(void)
{
	return ((HAL_GPIO_ReadPin(ID3_GPIO_Port, ID3_Pin) << 3) | 
					(HAL_GPIO_ReadPin(ID2_GPIO_Port, ID2_Pin) << 2) | 
					(HAL_GPIO_ReadPin(ID1_GPIO_Port, ID1_Pin) << 1) | 
					HAL_GPIO_ReadPin(ID0_GPIO_Port, ID0_Pin));
}

void GPIOComLEDOn(void)
{
	HAL_GPIO_WritePin(COM_LED_GPIO_Port, COM_LED_Pin, GPIO_PIN_RESET);
}

void GPIOComLEDOff(void)
{
	HAL_GPIO_WritePin(COM_LED_GPIO_Port, COM_LED_Pin, GPIO_PIN_SET);
}

void GPIOComLEDToggle(void)
{
	HAL_GPIO_TogglePin(COM_LED_GPIO_Port, COM_LED_Pin);
}
/* USER CODE END 2 */
