mehdinuri/CPU4v1/SSM/App/Domain/Crc32.c

/**
 ******************************************************************************
 * @file    Domain/Crc32.c
 * @brief   CRC-32/ISO-HDLC, table-driven. Table lives in flash (const) so
 *          RAM cost is zero; 1 KB of code-space is a fine trade for speed.
 *
 *          Reference: standard reflected CRC-32 (same as PNG, zip, Ethernet).
 *          Algorithm spot-checked against "123456789" → 0xCBF43926.
 ******************************************************************************
 */

#include "Domain/Crc32.h"

/* Standard reflected CRC-32 lookup table (poly 0xEDB88320). Generated once
 * at build time by initialising with the polynomial; the values are fixed
 * and audited against public references. */
static const uint32_t kCrc32Table[256] =
{
  0x00000000U, 0x77073096U, 0xEE0E612CU, 0x990951BAU,
  0x076DC419U, 0x706AF48FU, 0xE963A535U, 0x9E6495A3U,
  0x0EDB8832U, 0x79DCB8A4U, 0xE0D5E91EU, 0x97D2D988U,
  0x09B64C2BU, 0x7EB17CBDU, 0xE7B82D07U, 0x90BF1D91U,
  0x1DB71064U, 0x6AB020F2U, 0xF3B97148U, 0x84BE41DEU,
  0x1ADAD47DU, 0x6DDDE4EBU, 0xF4D4B551U, 0x83D385C7U,
  0x136C9856U, 0x646BA8C0U, 0xFD62F97AU, 0x8A65C9ECU,
  0x14015C4FU, 0x63066CD9U, 0xFA0F3D63U, 0x8D080DF5U,
  0x3B6E20C8U, 0x4C69105EU, 0xD56041E4U, 0xA2677172U,
  0x3C03E4D1U, 0x4B04D447U, 0xD20D85FDU, 0xA50AB56BU,
  0x35B5A8FAU, 0x42B2986CU, 0xDBBBC9D6U, 0xACBCF940U,
  0x32D86CE3U, 0x45DF5C75U, 0xDCD60DCFU, 0xABD13D59U,
  0x26D930ACU, 0x51DE003AU, 0xC8D75180U, 0xBFD06116U,
  0x21B4F4B5U, 0x56B3C423U, 0xCFBA9599U, 0xB8BDA50FU,
  0x2802B89EU, 0x5F058808U, 0xC60CD9B2U, 0xB10BE924U,
  0x2F6F7C87U, 0x58684C11U, 0xC1611DABU, 0xB6662D3DU,
  0x76DC4190U, 0x01DB7106U, 0x98D220BCU, 0xEFD5102AU,
  0x71B18589U, 0x06B6B51FU, 0x9FBFE4A5U, 0xE8B8D433U,
  0x7807C9A2U, 0x0F00F934U, 0x9609A88EU, 0xE10E9818U,
  0x7F6A0DBBU, 0x086D3D2DU, 0x91646C97U, 0xE6635C01U,
  0x6B6B51F4U, 0x1C6C6162U, 0x856530D8U, 0xF262004EU,
  0x6C0695EDU, 0x1B01A57BU, 0x8208F4C1U, 0xF50FC457U,
  0x65B0D9C6U, 0x12B7E950U, 0x8BBEB8EAU, 0xFCB9887CU,
  0x62DD1DDFU, 0x15DA2D49U, 0x8CD37CF3U, 0xFBD44C65U,
  0x4DB26158U, 0x3AB551CEU, 0xA3BC0074U, 0xD4BB30E2U,
  0x4ADFA541U, 0x3DD895D7U, 0xA4D1C46DU, 0xD3D6F4FBU,
  0x4369E96AU, 0x346ED9FCU, 0xAD678846U, 0xDA60B8D0U,
  0x44042D73U, 0x33031DE5U, 0xAA0A4C5FU, 0xDD0D7CC9U,
  0x5005713CU, 0x270241AAU, 0xBE0B1010U, 0xC90C2086U,
  0x5768B525U, 0x206F85B3U, 0xB966D409U, 0xCE61E49FU,
  0x5EDEF90EU, 0x29D9C998U, 0xB0D09822U, 0xC7D7A8B4U,
  0x59B33D17U, 0x2EB40D81U, 0xB7BD5C3BU, 0xC0BA6CADU,
  0xEDB88320U, 0x9ABFB3B6U, 0x03B6E20CU, 0x74B1D29AU,
  0xEAD54739U, 0x9DD277AFU, 0x04DB2615U, 0x73DC1683U,
  0xE3630B12U, 0x94643B84U, 0x0D6D6A3EU, 0x7A6A5AA8U,
  0xE40ECF0BU, 0x9309FF9DU, 0x0A00AE27U, 0x7D079EB1U,
  0xF00F9344U, 0x8708A3D2U, 0x1E01F268U, 0x6906C2FEU,
  0xF762575DU, 0x806567CBU, 0x196C3671U, 0x6E6B06E7U,
  0xFED41B76U, 0x89D32BE0U, 0x10DA7A5AU, 0x67DD4ACCU,
  0xF9B9DF6FU, 0x8EBEEFF9U, 0x17B7BE43U, 0x60B08ED5U,
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
};

uint32_t Crc32_Compute(const void *data, uint16_t len)
{
  const uint8_t *bytes = (const uint8_t *) data;
  uint32_t crc = 0xFFFFFFFFU;
  uint16_t i;

  for (i = 0U; i < len; i++)
  {
    crc = (crc >> 8) ^ kCrc32Table[(crc ^ bytes[i]) & 0xFFU];
  }

  return crc ^ 0xFFFFFFFFU;
}

/************************ (C) COPYRIGHT TEKNOTEL ELEKTRONIK ****END OF FILE****/
