mehdinuri/CPU4v1/PSM/App/Ports/ICANTxPort.h

/**
 ******************************************************************************
 * @file    Ports/ICANTxPort.h
 * @brief   Port interface for CAN frame transmission.
 *          STM32: wraps CANTxRequest() on FDCAN1 (classic CAN, standard ID).
 *          Host: records last frame sent for inspection.
 ******************************************************************************
 */

#ifndef PORTS_ICANTXPORT_H
#define PORTS_ICANTXPORT_H

#include <stdint.h>

/* ---------------------------------------------------------------------------
 * Port interface
 * ---------------------------------------------------------------------------*/
typedef struct
{
  void *ctx;
  void (*Send)(void *ctx,
               uint32_t id,
               const uint8_t *data,
               uint8_t dataLen);
  uint8_t (*GetOverflowCount)(void *ctx);
} ICANTxPort_t;

/* ---------------------------------------------------------------------------
 * Zero-cost inline dispatch helper
 * ---------------------------------------------------------------------------*/
static inline void CANTx_Send(ICANTxPort_t *p,
                               uint32_t id,
                               const uint8_t *data,
                               uint8_t dataLen)
{
  p->Send(p->ctx, id, data, dataLen);
}

static inline uint8_t CANTx_GetOverflowCount(ICANTxPort_t *p)
{
  return p->GetOverflowCount(p->ctx);
}

#endif /* PORTS_ICANTXPORT_H */

/************************ (C) COPYRIGHT TEKNOTEL ELEKTRONIK ****END OF FILE****/
