mehdinuri/CPU4v1/SSM/Core/Inc/adc.h

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
/* Define to prevent recursive inclusion -------------------------------------*/
#ifndef __ADC_H__
#define __ADC_H__

#ifdef __cplusplus
extern "C" {
#endif

/* Includes ------------------------------------------------------------------*/
#include "main.h"

extern ADC_HandleTypeDef hadc1;

extern ADC_HandleTypeDef hadc2;

void MX_ADC1_Init(void);
void MX_ADC2_Init(void);

/* USER CODE BEGIN Prototypes */
extern void ADCSGCurrentMeasurementStart(void);

/**
 * @brief Task-context processor: compute RMS + auto-range + publish the
 *        most recently completed DMA half. No-op if no half has been
 *        signalled since the last call. Must run from a task (allocates
 *        FPU context, calls sqrtf, touches the double-buffer adapter).
 */
extern void ADCSGCurrentProcessLatestHalf(void);

/* USER CODE END Prototypes */

#ifdef __cplusplus
}
#endif

#endif /* __ADC_H__ */
