mehdinuri/CPU4v1/PSM/Core/Src/iwdg.c

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
/* Includes ------------------------------------------------------------------*/
#include "iwdg.h"

IWDG_HandleTypeDef hiwdg;

/* IWDG init function */
void MX_IWDG_Init(void)
{

  /* USER CODE BEGIN IWDG_Init 1 */
#ifndef DEBUG
  /* USER CODE END IWDG_Init 1 */
  hiwdg.Instance = IWDG;
  hiwdg.Init.Prescaler = IWDG_PRESCALER_8;
  hiwdg.Init.Window = 4095;
  hiwdg.Init.Reload = 4095;
  if (HAL_IWDG_Init(&hiwdg) != HAL_OK)
  {
    Error_Handler();
  }
  /* USER CODE BEGIN IWDG_Init 2 */
#endif
  /* USER CODE END IWDG_Init 2 */

}

/* USER CODE BEGIN 1 */
void IWDGRefresh(void)
{
#ifndef DEBUG
	if(HAL_IWDG_Refresh(&hiwdg) != HAL_OK)
  {
    Error_Handler();
  }
#endif
}

void IWDGSetMaxTimeout(void)
{
#ifndef DEBUG
	hiwdg.Instance = IWDG;
  hiwdg.Init.Prescaler = IWDG_PRESCALER_256;
  hiwdg.Init.Reload = 0x0FFF;
  if (HAL_IWDG_Init(&hiwdg) != HAL_OK)
  {
    Error_Handler();
  }
	
	IWDGRefresh();
#endif
}
/* USER CODE END 1 */
