mehdinuri/CPU4v1/CPM/CP/Core/Inc/usart.h

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
/* Define to prevent recursive inclusion -------------------------------------*/
#ifndef __USART_H__
#define __USART_H__

#ifdef __cplusplus
extern "C" {
#endif

/* Includes ------------------------------------------------------------------*/
#include "main.h"

extern UART_HandleTypeDef huart4;

extern UART_HandleTypeDef huart5;

extern UART_HandleTypeDef huart8;

extern UART_HandleTypeDef huart2;

/* USER CODE BEGIN Private defines */
extern DMA_HandleTypeDef hdma_uart4_rx;
extern DMA_HandleTypeDef hdma_uart4_tx;
extern DMA_HandleTypeDef hdma_uart5_rx;
extern DMA_HandleTypeDef hdma_uart5_tx;
extern DMA_HandleTypeDef hdma_uart8_rx;
extern DMA_HandleTypeDef hdma_uart8_tx;
extern DMA_HandleTypeDef hdma_usart2_rx;
extern DMA_HandleTypeDef hdma_usart2_tx;

/* USER CODE END Private defines */

void MX_UART4_Init(void);
void MX_UART5_Init(void);
void MX_UART8_Init(void);
void MX_USART2_UART_Init(void);

/* USER CODE BEGIN Prototypes */
extern void UART4Init(uint32_t lBaudRate);
extern void UART8Init(uint32_t lBaudRate);
extern void USART2Init(uint32_t lBaudRate);
extern void UARTDeInit(UART_HandleTypeDef *huart);

/* USER CODE END Prototypes */

#ifdef __cplusplus
}
#endif

#endif /* __USART_H__ */
