mehdinuri/CPU4v1/CPM/CP/Core/Src/iwdg.c

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
/* Includes ------------------------------------------------------------------*/
#include "iwdg.h"

/* USER CODE BEGIN 0 */
#include "defs.h"

/* USER CODE END 0 */

IWDG_HandleTypeDef hiwdg1;

/* IWDG1 init function */
void MX_IWDG1_Init(void)
{

  /* USER CODE BEGIN IWDG1_Init 0 */
  #ifndef DEBUG
  /* USER CODE END IWDG1_Init 0 */

  hiwdg1.Instance = IWDG1;
  hiwdg1.Init.Prescaler = IWDG_PRESCALER_8;
  hiwdg1.Init.Window = 4095;
  hiwdg1.Init.Reload = 4095;
  if (HAL_IWDG_Init(&hiwdg1) != HAL_OK)
  {
    Error_Handler();
  }
  /* USER CODE BEGIN IWDG1_Init 2 */
  #endif /* ifndef DEBUG */
  /* USER CODE END IWDG1_Init 2 */

}

/* USER CODE BEGIN 1 */
void IWDGRefresh(void)
{
  #ifndef DEBUG
  HAL_IWDG_Refresh(&hiwdg1);
  #endif
}

void IWDGInit(void)
{
  #ifndef DEBUG
  MX_IWDG1_Init();
  #endif
}

void IWDGSetMaxTimeout(void)
{
  #ifndef DEBUG
  hiwdg1.Instance = IWDG1;
  hiwdg1.Init.Prescaler = IWDG_PRESCALER_256;
  hiwdg1.Init.Reload = 0x0FFF;
  if (HAL_IWDG_Init(&hiwdg1) != HAL_OK)
  {
    Error_Handler();
  }

  IWDGRefresh();
  #endif
}

void IWDGSetNormalTimeout(void)
{
  #ifndef DEBUG
  IWDGInit();
  IWDGRefresh();
  #endif
}

/* USER CODE END 1 */
