mehdinuri/CPU4v1/(commit log)

2026-04-05 cp and mp
    [MISRA-C.cfg, gcovr.cfg]
2026-04-17 added psm and ssm, restructured code
    [ConfigurationService.h, MISRA-C.cfg, gcovr.cfg]
2026-04-18 structure and tooling for ssm and psm
    [MISRA-C.cfg, gcovr.cfg]
2026-04-18 ports and adapters to psm
    [gcovr.cfg]
2026-04-18 move Tasks/ under App/Platform/STM32/Tasks/
    Aligns PSM with the CP reference hexagonal layout: task wrappers now live
    alongside Bootstrap/ in the PSM_Platform_STM32 library. Files flattened to
    CamelCase .c/.h pairs (Measurement, CanMsgParser, CanMsgSender, Storage)
    and task sources are compiled into the platform library instead of the
    main executable. PSM_Domain is now a link dependency of PSM_Platform_STM32
    so task code can resolve domain symbols.
    [Measurement.c, Measurement.h, MeasurementService.h, adc.c, app_freertos.c, fdcan.c, main_stm32.c, tim.c]
2026-04-18 cabinetEnv and globalTime
    [ConfigurationService.h]
2026-04-18 cp add canonical io mapping
    [ConfigurationService.h]
