mehdinuri/CPU4v1/(notices)

Notices in the files:
SSM/Core/Inc/gpio.h:
Copyright (c) 2025 STMicroelectronics.
All rights reserved.
This software is licensed under terms that can be found in the LICENSE file
CPM/CP/Core/Src/usart.c:
Copyright (c) 2026 STMicroelectronics.
